FPJ-GAOGE/V4-Underwater-Robot/THIRD_PARTY_NOTICES.md

# 许可、署名与来源

**中文** · [English](THIRD_PARTY_NOTICES.en.md)

本仓库按项目所有者要求整理为**私有开源准备仓库**，保留各上游组件的原始许可和版权声明。没有给整个资料包补写统一 MIT / GPL 许可，也没有将私有整理等同于所有材料已获公共再分发许可。

| 范围 | 来源许可 / 状态 | 本仓库处理 |
| --- | --- | --- |
| `firmware/v4` 的 IWIN-FINS 项目 | 上游 [LICENSE](firmware/v4/LICENSE) 为 GNU GPL v3 文本 | 原样保留；具体子组件按各自条款 |
| V4 的 CMSIS、ST HAL、USB 库 | CMSIS Apache 2.0；HAL 原说明指向 BSD-3-Clause；USB 含 ST SLA0044 | 保留对应 LICENSE 文件与源码头部，不将其统一改写 |
| `firmware/v4-pro` 的 FineSUB | 上游 [LICENSE](firmware/v4-pro/LICENSE) 为 MPL-2.0 | 保留文件级条款、原始署名和固定依赖来源 |
| FineSUB 的 CMSIS-DSP、ETL、BSP 及其他依赖 | 各自目录许可，详见 [IMPORT](firmware/v4-pro/IMPORT.md) | 固定版本并保留许可文件；裁剪不用于目标构建的资料有记录 |
| `software/v4-topside` | 指定提交未附明确许可 | 私有收录并标注来源，未擅自为上游代码添加许可 |
| Jetson 与历史通信附件 | 飞书附件中未附明确许可 | 保留原文件、校验值及文档来源 |
| CAD、工程图、照片、BOM、文档改写 | 所提供资料没有独立的开放硬件/文档许可声明；部分模型为外购器件外形 | 分型号整理并列出来源，不推定供应商外形模型可无条件公开 |

对未明确授权部分，公开发布前需要项目权利人确认分发范围和许可；这不影响当前按要求建立私有资料库。新增整理文档不声明代表第三方授权，也不自动改变被引用材料的条款。

## 保留与排除

- 保留上游作者和团队署名、版权头、许可证、固定提交，以及原始代码行为。
- 机械原包保留原文件名与原生装配文件；中性格式逐文件校验，不声称转换成另一种许可。
- 未收录飞书评论、OAuth 响应、设备登录密码、个人分工、行程及费用信息。
- 没有将未经确认的研究论文实验结果、仿真模型或其他仓库的 Pro 配置当作本项目实测指标。

源码与设计出处见 [sources.md](docs/sources.md)。
