FPJ-GAOGE/V4-Underwater-Robot/hardware/v4/electrical-connection.original.pdf

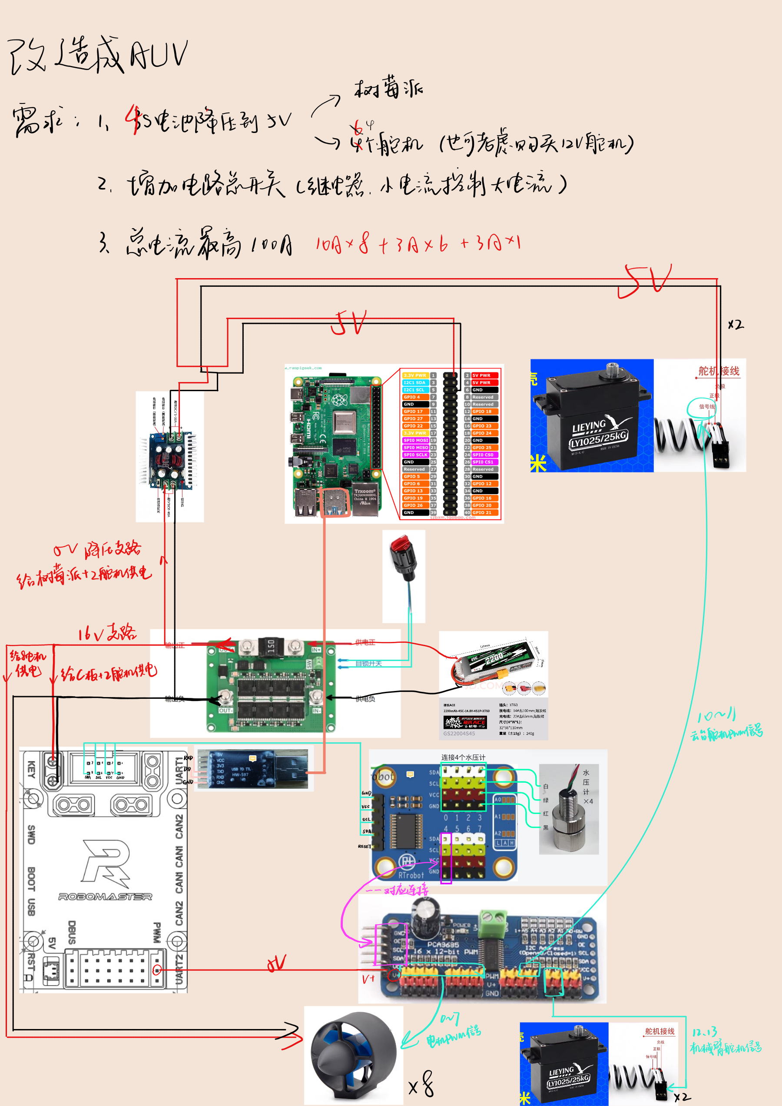
[picture p7: page 1]
