FPJ-GAOGE/V4-Underwater-Robot/docs/bom.en.md

[中文](bom.md) | [English](bom.en.md)

# V4 / V4-pro Bill of Materials (BOM)

This page and the downloadable tables use the same [structured bilingual dataset](../hardware/bom/bom-data.json). Compiled on **2026-10-22**. There are **95 records: 56 for V4 and 39 for V4-pro**. These include historical alternatives, optional mechanisms and unconfirmed quantities; the complete list is not a purchase order for one vehicle.

## Downloads

- [Excel: bilingual V4 / V4-pro BOM](../hardware/bom/V4-V4pro-BOM.xlsx)
- [CSV: V4](../hardware/bom/V4-BOM.csv) · [CSV: V4-pro](../hardware/bom/V4-pro-BOM.csv)
- [JSON: bilingual data, sources and status](../hardware/bom/bom-data.json)
- [Release downloads](https://github.com/FPJ-GAOGE/V4-Underwater-Robot/releases/tag/bilingual-bom-2026-10-22) · [SHA-256 checksums](../hardware/bom/SHA256SUMS.txt)

## Reading quantities and status

- **Unconfirmed** means no quantity can be established from the source. It is `null` in JSON, not zero. Numeric entries reproduce source values; they do not imply a completed assembly-instance count.
- “pcs/sets” are organizational counting units. Where the source lacks a supplier package unit, the quantity note says so. The 100 m Ethernet-tether entry is a recorded length, not 100 cables.
- Do not add **historical alternatives** to the current quantities. **Optional design files** do not mean that every vehicle includes the mechanism. A CAD part file alone does not establish how many instances are required.
- Resolve **conflicting sources** against the actual vehicle: V4 servos (2/4), relay ratings (30 A/120 A) and different terminal layouts; Pro servo supply (5 V/8.4 V) and terminal quantities.
- Purchase links retain only product IDs from the source and omit account/tracking parameters. Current prices, availability and product options have not been checked. One listing may include ESC/no-ESC, voltage or range options; do not order solely from the URL.
- V4 and V4-pro have distinct thruster wiring, controllers, onboard computers, control signals and CAD. Matching names or listing URLs do not establish interchangeability.

All 26 entries in the original V4 parts table are included. Additional entries from the older electrical document have explicit status, and H30 appears only once as a firmware dependency. Pro connector customization is described alongside devices without separate purchase counts, so device counts have not been copied into connector quantities. For mechanical parts without stated material, tolerance, sealing grade or pressure performance, use the drawings and confirmed vehicle records.

## V4

### Electronics and actuators

| ID / Item | Quantity / unit and note | Specification and customization | Status / source / original listing |
| --- | --- | --- | --- |
| `v4-thruster`<br>Thruster | 8 pcs | The original V4 uses power-positive, power-negative and PWM wires. Measure cable lengths on the selected frame; do not use the Pro three-phase wiring scheme. | Listed in source; verify before purchase<br>[v4-parts](#source-v4-parts) · [v4-electrical](#source-v4-electrical)<br>[Original listing](https://item.taobao.com/item.htm?id=591864716045) |
| `v4-servo`<br>Servo | 2 pcs<br>The parts list says 2; the older electrical list says 4. Do not add them. | The older electrical list and V4-ly firmware retain four channels. Confirm the installed camera/mechanism configuration. | Conflicting sources; confirm against the vehicle<br>[v4-parts](#source-v4-parts) · [v4-electrical](#source-v4-electrical) · [v4-firmware](#source-v4-firmware)<br>[Original listing](https://item.taobao.com/item.htm?id=853148098562) |
| `v4-pressure-sensor`<br>Depth/pressure sensor | 4 pcs | Parts list: stainless steel, 10 m option. An older product title mentions MS5837-30BA. Confirm the actual model/option; 10 m is not the vehicle depth rating. The older wiring uses the supplied adapter board; verify that it is included with the sensor. | Listed in source; verify before purchase<br>[v4-parts](#source-v4-parts) · [v4-electrical](#source-v4-electrical)<br>[Original listing](https://item.taobao.com/item.htm?id=605375059849) |
| `v4-battery`<br>4S battery | 1 pcs | XT60 main-power connector. The older electrical document records 10000 mAh and 25C; the parts list confirms only 4S/XT60. | Listed in source; verify before purchase<br>[v4-parts](#source-v4-parts) · [v4-electrical](#source-v4-electrical)<br>[Original listing](https://item.taobao.com/item.htm?id=609820541557) |
| `v4-relay`<br>Relay/power-switch module | 1 pcs | The parts list says 30 A and the older electrical document says 120 A. The original short link is not evidence of the model or current rating. | Conflicting sources; confirm against the vehicle<br>[v4-parts](#source-v4-parts) · [v4-electrical](#source-v4-electrical)<br>No verified product URL |
| `v4-rotary-switch`<br>Underwater rotary switch | 1 pcs | Switch in the main-power control path; verify the connections and contact rating of the actual part. | Listed in source; verify before purchase<br>[v4-parts](#source-v4-parts) · [v4-electrical](#source-v4-electrical)<br>[Original listing](https://item.taobao.com/item.htm?id=746272975983) |
| `v4-buck-converter`<br>DC-DC step-down converter | 1 pcs | Supplies the Raspberry Pi and mechanism branches; confirm voltage/current requirements for each load. | Listed in source; verify before purchase<br>[v4-parts](#source-v4-parts) · [v4-electrical](#source-v4-electrical)<br>[Original listing](https://item.taobao.com/item.htm?id=856012812115) |
| `v4-power-distribution`<br>Power distribution board | 1 pcs<br>Quantity 1 comes from the older electrical list; it is absent from the current parts list. | The older wiring uses it for Raspberry Pi/servo branches and also describes a custom split harness. Do not duplicate alternative distribution solutions. | Historical alternative; do not add to current quantities<br>[v4-electrical](#source-v4-electrical)<br>[Original listing](https://item.taobao.com/item.htm?id=814381038913) |
| `v4-raspberry-pi`<br>Raspberry Pi 4B | 1 pcs | Onboard computer; RAM and storage specifications are not stated in the parts list. | Listed in source; verify before purchase<br>[v4-parts](#source-v4-parts) · [v4-electrical](#source-v4-electrical)<br>[Original listing](https://detail.tmall.com/item.htm?id=705995475782) |
| `v4-controller`<br>RoboMaster C board | 1 pcs | V4 controller named in the system documentation. The firmware project targets STM32F407IGHx; verify the actual board. | Listed in source; verify before purchase<br>[v4-parts](#source-v4-parts) · [v4-electrical](#source-v4-electrical) · [v4-firmware](#source-v4-firmware)<br>[Original listing](https://item.taobao.com/item.htm?id=611226266955) |
| `v4-h30-imu`<br>H30 IMU (firmware dependency) | Unconfirmed pcs<br>No confirmed quantity is given in the source; this does not mean zero. | V4-ly attitude feedback uses H30 on USART1 at 921600 8N1; startup also checks BMI088. Record the actual H30 purchase model and mounting. | Quantity or specification missing<br>[v4-firmware](#source-v4-firmware)<br>No verified product URL |
| `v4-pca9685`<br>PCA9685 PWM expansion board | 1 pcs | Thrusters use channels 0–7; firmware reserves channels 8–11 for servos. Distinguish logic VCC from the V+ load supply. | Listed in source; verify before purchase<br>[v4-parts](#source-v4-parts) · [v4-electrical](#source-v4-electrical) · [v4-firmware](#source-v4-firmware)<br>[Original listing](https://detail.tmall.com/item.htm?id=624960039615) |
| `v4-i2c-expander`<br>I2C multiplexer board | 1 pcs | Firmware uses TCA9548A: channels 0–3 for pressure sensors and channel 4 for PCA9685. | Listed in source; verify before purchase<br>[v4-parts](#source-v4-parts) · [v4-electrical](#source-v4-electrical) · [v4-firmware](#source-v4-firmware)<br>[Original listing](https://item.taobao.com/item.htm?id=612860784973) |
| `v4-camera`<br>Camera | 1 pcs | The full design includes a stereo-camera arrangement; a monocular mount update dated 2025-07-10 is separate. Match the camera to the selected mount and interface. | Listed in source; verify before purchase<br>[v4-parts](#source-v4-parts) · [v4-design](#source-v4-design)<br>[Original listing](https://item.taobao.com/item.htm?id=793615736142) |
| `v4-wireless-debugger`<br>Wireless debugger/programmer | 1 pcs | Verify compatibility with the actual SWD connection and programming tool. | Listed in source; verify before purchase<br>[v4-parts](#source-v4-parts)<br>[Original listing](https://item.taobao.com/item.htm?id=745548099223) |

### Connectors and cabling

| ID / Item | Quantity / unit and note | Specification and customization | Status / source / original listing |
| --- | --- | --- | --- |
| `v4-servo-thruster-connectors`<br>Watertight servo/thruster connectors | 12 sets<br>The source says 12 without a package unit; listed as sets from the mating-pair description, subject to confirmation. Note the older 8-thruster/4-servo layout versus the current 2-servo list. | Three-pin receptacle plus male cable; confirm equipment positions and cable lengths before custom assembly. | Conflicting sources; confirm against the vehicle<br>[v4-parts](#source-v4-parts)<br>[Original listing](https://item.taobao.com/item.htm?id=811948973422) |
| `v4-connector-caps`<br>Three-pin male blanking plugs | 2 pcs | For unused servo/thruster connectors; match the mating receptacle. | Listed in source; verify before purchase<br>[v4-parts](#source-v4-parts)<br>[Original listing](https://item.taobao.com/item.htm?id=811948973422) |
| `v4-pressure-sleeves`<br>External pressure-sensor sleeves | 4 pcs | For sensor-cable extension and potting; follow the purchased materials/process specifications. | Listed in source; verify before purchase<br>[v4-parts](#source-v4-parts) · [v4-design](#source-v4-design)<br>[Original listing](https://item.taobao.com/item.htm?id=781752613399) |
| `v4-pressure-connectors`<br>Watertight pressure-sensor connectors | 4 sets<br>The source quantity is 4; mating pairs are listed as sets. Confirm the supplier package unit. | Custom 00W four-pin plug and receptacle; 65 cm vendor-supplied four-core cable. | Listed in source; verify before purchase<br>[v4-parts](#source-v4-parts)<br>[Original listing](https://item.taobao.com/item.htm?id=619481441943) |
| `v4-ethernet-tether`<br>Neutral-buoyancy Ethernet tether | 100 m<br>100 is a recorded length, not 100 cables; confirm whether it is the per-vehicle requirement. | The quantity cell states “neutral-buoyancy Ethernet cable, 100 m”. Confirm termination, outer diameter, core count and length definition with the connector supplier. | Listed in source; verify before purchase<br>[v4-parts](#source-v4-parts)<br>No verified product URL |
| `v4-tether-connector`<br>Tether connector | 1 pcs | 1W eight-pin plug; the mating receptacle and termination arrangement are not fully specified. | Listed in source; verify before purchase<br>[v4-parts](#source-v4-parts)<br>No verified product URL |
| `v4-camera-connector`<br>Camera connector | Unconfirmed pcs<br>No confirmed quantity is given in the source; this does not mean zero. | 1W four-pin plug; verify against the actual camera and cable-penetration design. | Quantity or specification missing<br>[v4-parts](#source-v4-parts)<br>No verified product URL |
| `v4-terminal-20p`<br>H3800 20-position terminal block | 2 pcs | Match the current mounting holes and wiring schedule. | Listed in source; verify before purchase<br>[v4-parts](#source-v4-parts)<br>[Original listing](https://item.taobao.com/item.htm?id=661948958655) |
| `v4-terminal-16p`<br>H3803 16-position terminal block | 2 pcs | Verify against the power/branch harnesses and the actual terminal specification. | Listed in source; verify before purchase<br>[v4-parts](#source-v4-parts)<br>[Original listing](https://item.taobao.com/item.htm?id=551775262138) |
| `v4-terminal-6p`<br>H3800 6-position terminal block | 2 pcs | An older document describes a different six-/seven-pin layout. Do not add the historical terminal rows to this quantity. | Listed in source; verify before purchase<br>[v4-parts](#source-v4-parts) · [v4-electrical](#source-v4-electrical)<br>[Original listing](https://item.taobao.com/item.htm?id=661948958655) |
| `v4-bridge-3-5mm`<br>3.5 mm ten-position jumper bridge | 2 pcs | FBS10-3.5, red, brass; match the terminal-block series. | Listed in source; verify before purchase<br>[v4-parts](#source-v4-parts)<br>[Original listing](https://detail.tmall.com/item.htm?id=622709470719) |
| `v4-bridge-6-2mm`<br>6.2 mm ten-position jumper bridge | 2 pcs | Ten-position EB bridge; match the terminal-block series. | Listed in source; verify before purchase<br>[v4-parts](#source-v4-parts)<br>[Original listing](https://item.taobao.com/item.htm?id=551775262138) |
| `v4-usb-c-power-cable`<br>Raspberry Pi USB-C power cable | 1 pcs | The source specifies two left/right angled connectors; verify current capability and available space. | Listed in source; verify before purchase<br>[v4-parts](#source-v4-parts)<br>[Original listing](https://detail.tmall.com/item.htm?id=739417974339) |

### Mechanical and machined parts

| ID / Item | Quantity / unit and note | Specification and customization | Status / source / original listing |
| --- | --- | --- | --- |
| `v4-side-support`<br>Side support | Unconfirmed pcs<br>The CAD contains this part, but its assembly instance count is unconfirmed. Do not copy the Pro quantity. | 主体/侧支撑.STEP; a DWG is also provided. The V4 aluminum-machining instructions specify matte black anodizing; use the drawings for material and tolerances. | Quantity or specification missing<br>[v4-design](#source-v4-design) · [v4-cad](#source-v4-cad)<br>No verified product URL |
| `v4-bottom-support`<br>Bottom support 2 | Unconfirmed pcs<br>The CAD contains this part, but its assembly instance count is unconfirmed. Do not copy the Pro quantity. | 主体/底支撑2.STEP; a DWG is also provided. The V4 aluminum-machining instructions specify matte black anodizing; use the drawings for material and tolerances. | Quantity or specification missing<br>[v4-design](#source-v4-design) · [v4-cad](#source-v4-cad)<br>No verified product URL |
| `v4-upper-thruster-support`<br>Upper thruster support | Unconfirmed pcs<br>The CAD contains this part, but its assembly instance count is unconfirmed. Do not copy the Pro quantity. | 主体/上推进器支撑.STEP; a DWG is also provided. The V4 aluminum-machining instructions specify matte black anodizing; use the drawings for material and tolerances. | Quantity or specification missing<br>[v4-design](#source-v4-design) · [v4-cad](#source-v4-cad)<br>No verified product URL |
| `v4-corner-piece`<br>Corner bracket | Unconfirmed pcs<br>The CAD contains this part, but its assembly instance count is unconfirmed. Do not copy the Pro quantity. | 主体/角件.STEP. The V4 aluminum-machining instructions specify matte black anodizing; use the drawings for material and tolerances. | Quantity or specification missing<br>[v4-design](#source-v4-design) · [v4-cad](#source-v4-cad)<br>No verified product URL |
| `v4-rear-endcap`<br>Rear end cap 165 | Unconfirmed pcs<br>The CAD contains this part, but its assembly instance count is unconfirmed. Do not copy the Pro quantity. | 密封舱/后舱盖165.STEP; a DWG is also provided. The V4 aluminum-machining instructions specify matte black anodizing; use the drawings for material and tolerances. | Quantity or specification missing<br>[v4-design](#source-v4-design) · [v4-cad](#source-v4-cad)<br>No verified product URL |
| `v4-gimbal-base`<br>Gimbal base | Unconfirmed pcs<br>The CAD contains this part, but its assembly instance count is unconfirmed. Do not copy the Pro quantity. | 相机云台/云台底架.STEP; a DWG is also provided. The V4 aluminum-machining instructions specify matte black anodizing; use the drawings for material and tolerances. | Quantity or specification missing<br>[v4-design](#source-v4-design) · [v4-cad](#source-v4-cad)<br>No verified product URL |
| `v4-rear-gimbal-base`<br>Rear gimbal base | Unconfirmed pcs<br>The CAD contains this part, but its assembly instance count is unconfirmed. Do not copy the Pro quantity. | 相机云台/后云台底架.STEP; a DWG is also provided. The V4 aluminum-machining instructions specify matte black anodizing; use the drawings for material and tolerances. | Quantity or specification missing<br>[v4-design](#source-v4-design) · [v4-cad](#source-v4-cad)<br>No verified product URL |
| `v4-sensor-sleeve-mount`<br>Machined external-sleeve mount | Unconfirmed pcs<br>The CAD contains this part, but its assembly instance count is unconfirmed. Do not copy the Pro quantity. | 水深传感器/外置套管固定加工版.STEP. The V4 aluminum-machining instructions specify matte black anodizing; use the drawings for material and tolerances. | Quantity or specification missing<br>[v4-design](#source-v4-design) · [v4-cad](#source-v4-cad)<br>No verified product URL |
| `v4-sealed-housing`<br>Sealed enclosure and associated seals/mounts | Unconfirmed assembly (breakdown required)<br>No confirmed quantity is given in the source; this does not mean zero. | The manufacturing steps mention the sealed enclosure and rear cap, but do not provide a complete enclosure/seal purchase breakdown or a vehicle depth rating. | Quantity or specification missing<br>[v4-design](#source-v4-design)<br>No verified product URL |

### Printed parts and internal supports

| ID / Item | Quantity / unit and note | Specification and customization | Status / source / original listing |
| --- | --- | --- | --- |
| `v4-upper-electronics-tray`<br>Upper electronics tray | Unconfirmed pcs<br>No confirmed quantity is given in the source; this does not mean zero. | CAD: 密封舱/舱内/上层架板.STEP. Confirm the process, material and quantity from the selected assembly; file presence alone does not establish them. | Quantity or specification missing<br>[v4-cad](#source-v4-cad)<br>No verified product URL |
| `v4-lower-electronics-tray`<br>Lower electronics tray | Unconfirmed pcs<br>No confirmed quantity is given in the source; this does not mean zero. | CAD: 密封舱/舱内/下层架板.STEP. Confirm the process, material and quantity from the selected assembly; file presence alone does not establish them. | Quantity or specification missing<br>[v4-cad](#source-v4-cad)<br>No verified product URL |
| `v4-battery-tray`<br>Battery holder | Unconfirmed pcs<br>No confirmed quantity is given in the source; this does not mean zero. | CAD: 密封舱/舱内/电池架.STEP. Confirm the process, material and quantity from the selected assembly; file presence alone does not establish them. | Quantity or specification missing<br>[v4-cad](#source-v4-cad)<br>No verified product URL |
| `v4-camera-link`<br>Camera mounting link | Unconfirmed pcs<br>No confirmed quantity is given in the source; this does not mean zero. | CAD: 相机云台/相机连接件.STEP. Confirm the process, material and quantity from the selected assembly; file presence alone does not establish them. | Quantity or specification missing<br>[v4-cad](#source-v4-cad)<br>No verified product URL |
| `v4-servo-link`<br>Servo mounting link | Unconfirmed pcs<br>No confirmed quantity is given in the source; this does not mean zero. | CAD: 相机云台/舵机连接件.STEP. Confirm the process, material and quantity from the selected assembly; file presence alone does not establish them. | Quantity or specification missing<br>[v4-cad](#source-v4-cad)<br>No verified product URL |
| `v4-buoyancy-shell`<br>Buoyancy shell 2 | Unconfirmed pcs<br>No confirmed quantity is given in the source; this does not mean zero. | CAD: 浮力外壳/浮力外壳2.STEP. Confirm the process, material and quantity from the selected assembly; file presence alone does not establish them. | Quantity or specification missing<br>[v4-cad](#source-v4-cad)<br>No verified product URL |

### Fasteners and assembly materials

| ID / Item | Quantity / unit and note | Specification and customization | Status / source / original listing |
| --- | --- | --- | --- |
| `v4-switch-extension-wire`<br>24 AWG switch-extension wire | Unconfirmed m<br>No confirmed quantity is given in the source; this does not mean zero. | The older electrical text specifies 24 AWG only when the rotary-switch leads need extending; total length is not stated. | Quantity or specification missing<br>[v4-electrical](#source-v4-electrical)<br>No verified product URL |
| `v4-power-y-harness`<br>XT60 and power-split harness | Unconfirmed sets<br>No confirmed quantity is given in the source; this does not mean zero. | The older wiring describes a Y split and XT60 connection. Use a completed, verified harness; the historical rewiring steps are not a product specification. | Quantity or specification missing<br>[v4-electrical](#source-v4-electrical)<br>No verified product URL |
| `v4-heat-set-inserts`<br>M2.5/M3 heat-set inserts | Unconfirmed pcs<br>No confirmed quantity is given in the source; this does not mean zero. | Use M2.5 at Raspberry Pi/PWM-board positions and M3 at other specified positions; not every hole receives an insert. | Quantity or specification missing<br>[v4-design](#source-v4-design)<br>No verified product URL |
| `v4-nylon-standoffs`<br>M2.5/M3 nylon standoffs | Unconfirmed pcs<br>No confirmed quantity is given in the source; this does not mean zero. | M2.5 for Raspberry Pi/PWM-board positions and M3 elsewhere as specified; the C board and terminals do not use the same standoffs. | Quantity or specification missing<br>[v4-design](#source-v4-design)<br>No verified product URL |
| `v4-fasteners`<br>Frame and electronics-mount fasteners | Unconfirmed pcs<br>No confirmed quantity is given in the source; this does not mean zero. | Derive from the 2025-05-23 assembly and threaded-hole drawings; the source has no consolidated size/quantity list. | Quantity or specification missing<br>[v4-design](#source-v4-design) · [v4-cad](#source-v4-cad)<br>No verified product URL |
| `v4-potting-material`<br>Epoxy potting and insulating materials | Unconfirmed amount TBD<br>No confirmed quantity is given in the source; this does not mean zero. | The source requires epoxy potting after soldering and insulation of unused distribution points; mixture and quantity are not specified. | Quantity or specification missing<br>[v4-design](#source-v4-design) · [v4-electrical](#source-v4-electrical)<br>No verified product URL |

### Historical wiring alternatives

| ID / Item | Quantity / unit and note | Specification and customization | Status / source / original listing |
| --- | --- | --- | --- |
| `v4-usb-ttl`<br>USB-to-TTL adapter | 1 pcs<br>Quantity 1 comes from the older electrical list; it is absent from the current parts list. | Optional UART connection in the older electrical document; distinguish it from direct GPIO UART wiring. | Historical alternative; do not add to current quantities<br>[v4-electrical](#source-v4-electrical)<br>No verified product URL |
| `v4-historical-6pin-large`<br>Large six-pin terminal blocks, older layout | 4 pcs | The older wiring uses these for thrusters with positive/negative/signal wiring. | Historical alternative; do not add to current quantities<br>[v4-electrical](#source-v4-electrical)<br>No verified product URL |
| `v4-historical-6pin-small`<br>Small six-pin terminal blocks, older layout | 2 pcs | Used for servos in the older wiring; do not add to the current H3800-series layout. | Historical alternative; do not add to current quantities<br>[v4-electrical](#source-v4-electrical)<br>No verified product URL |
| `v4-historical-7pin-small`<br>Small seven-pin terminal block, older layout | Unconfirmed pcs<br>No confirmed quantity is given in the source; this does not mean zero. | Three UART wires plus four SWD wires; the source gives no explicit quantity. | Historical alternative; do not add to current quantities<br>[v4-electrical](#source-v4-electrical)<br>No verified product URL |
| `v4-historical-stlink`<br>ST-Link debugger (older connection) | Unconfirmed pcs<br>No confirmed quantity is given in the source; this does not mean zero. | The older wiring steps mention ST-Link. It is an alternative to the wireless debugger, not an automatic additional purchase. | Historical alternative; do not add to current quantities<br>[v4-electrical](#source-v4-electrical)<br>No verified product URL |

### Optional mechanisms and later updates

| ID / Item | Quantity / unit and note | Specification and customization | Status / source / original listing |
| --- | --- | --- | --- |
| `v4-monocular-mount-update`<br>2025-07-10 monocular-camera mount update | Unconfirmed assembly (breakdown required)<br>No confirmed quantity is given in the source; this does not mean zero. | Two separate SLDPRT definitions, 相机支架1 and 相机支架2; this does not establish one of each per vehicle. Confirm the chosen mechanism. | Optional design files; not part of the default assembly<br>[v4-design](#source-v4-design) · [v4-cad](#source-v4-cad)<br>No verified product URL |
| `v4-gripper-design`<br>Optional gripper design package | Unconfirmed assembly (breakdown required)<br>No confirmed quantity is given in the source; this does not mean zero. | Contains driving/driven gears, a circular flange, gripper finger, link rod, base and top-cover models. Instance counts and vehicle integration are unconfirmed. | Optional design files; not part of the default assembly<br>[v4-design](#source-v4-design) · [v4-cad](#source-v4-cad)<br>No verified product URL |

## V4-pro

### Electronics and actuators

| ID / Item | Quantity / unit and note | Specification and customization | Status / source / original listing |
| --- | --- | --- | --- |
| `v4-pro-thruster`<br>Brushless thruster without ESC | 8 pcs | Four CW and four CCW propellers, paired one of each; the four cable groups are 65/50/38/32 cm. Three motor-phase wires, not the V4 power-positive/negative/PWM arrangement. | Listed in source; verify before purchase<br>[pro-making](#source-pro-making)<br>[Original listing](https://item.taobao.com/item.htm?id=591864716045) |
| `v4-pro-esc`<br>Four-in-one ESC | 2 pcs | Eight motor channels total. FineSUB uses DSHOT with bidirectional 3D mode and telemetry; confirm the ESC model, voltage and firmware settings. | Listed in source; verify before purchase<br>[pro-making](#source-pro-making) · [pro-firmware](#source-pro-firmware)<br>No verified product URL |
| `v4-pro-pressure-sensor`<br>Depth/pressure sensor | 4 pcs | 316L stainless steel, 10 m option; custom 70 cm waterproof leads, pin 1 red/2 black/3 green SCL/4 white SDA. The 10 m option is not a vehicle depth rating. | Listed in source; verify before purchase<br>[pro-making](#source-pro-making)<br>[Original listing](https://item.taobao.com/item.htm?id=605375059849) |
| `v4-pro-fill-light`<br>PWM fill light | 2 pcs | ArduSub pulse-width-controlled light, 100° beam angle; 60 cm waterproof lead, pin 1 red/2 black/3 yellow PWM. Verify its power supply specification. | Listed in source; verify before purchase<br>[pro-making](#source-pro-making) · [pro-wiring](#source-pro-wiring)<br>[Original listing](https://item.taobao.com/item.htm?id=934701227487) |
| `v4-pro-servo`<br>Servo | 2 pcs | 75 cm waterproof lead, pin 1 red/2 black/3 yellow PWM. The simplified drawing says 5 V while the manufacturing text specifies an 8.4 V adjustable board supply; resolve this before assembly. | Conflicting sources; confirm against the vehicle<br>[pro-making](#source-pro-making) · [pro-wiring](#source-pro-wiring)<br>[Original listing](https://item.taobao.com/item.htm?id=853148098562) |
| `v4-pro-controller`<br>RoboMaster A board | 1 pcs | STM32F427. Thrusters use DSHOT; lights/servos use separate PWM outputs. Verify board and load supplies. | Listed in source; verify before purchase<br>[pro-making](#source-pro-making) · [pro-firmware](#source-pro-firmware)<br>[Original listing](https://item.taobao.com/item.htm?id=605165393036) |
| `v4-pro-jetson`<br>Jetson Orin module and carrier board | 1 set<br>The source says “NANO ×1”. Counted as one computer set; separate module/carrier purchase quantities require confirmation. | The manufacturing list says “NANO”; the linked setup covers Orin NX/Nano and a Damiao carrier. This is not a generic substitution with the older Jetson Nano. | Listed in source; verify before purchase<br>[pro-making](#source-pro-making) · [orin-setup](#source-orin-setup)<br>No verified product URL |
| `v4-pro-battery`<br>Custom battery | Unconfirmed pcs<br>No confirmed quantity is given in the source; this does not mean zero. | The original wiring drawing labels the main supply 24 V. Capacity, cell configuration, protection and charging interface are unspecified; do not infer them from a product title. | Quantity or specification missing<br>[pro-making](#source-pro-making) · [pro-wiring](#source-pro-wiring)<br>No verified product URL |
| `v4-pro-power-distribution`<br>Power distribution board | Unconfirmed pcs<br>No confirmed quantity is given in the source; this does not mean zero. | Must match the battery, ESC, controller and Jetson branches; model, current rating and quantity are not listed. | Quantity or specification missing<br>[pro-making](#source-pro-making) · [pro-wiring](#source-pro-wiring)<br>No verified product URL |
| `v4-pro-i2c-expander`<br>I2C multiplexer board | Unconfirmed pcs<br>No confirmed quantity is given in the source; this does not mean zero. | The guide requires 3.3 V; current firmware uses I2C2 → TCA9548A at 0x70 → four pressure sensors. | Quantity or specification missing<br>[pro-making](#source-pro-making) · [pro-firmware](#source-pro-firmware)<br>[Original listing](https://item.taobao.com/item.htm?id=677595693967) |
| `v4-pro-imu`<br>IMU | Unconfirmed pcs<br>No confirmed quantity is given in the source; this does not mean zero. | The guide requests 400 Hz firmware and 921600 baud. Firmware uses H30/UART7; confirm the actual hardware model. | Quantity or specification missing<br>[pro-making](#source-pro-making) · [pro-firmware](#source-pro-firmware)<br>[Original listing](https://item.taobao.com/item.htm?id=649300089333) |
| `v4-pro-wireless-programmer`<br>Wireless programmer | 2 pcs | Match each intended use and SWD interface; this does not mean attaching two programmers to one board. | Listed in source; verify before purchase<br>[pro-making](#source-pro-making)<br>[Original listing](https://item.taobao.com/item.htm?id=745548099223) |
| `v4-pro-powerline-modem`<br>Power-line communication module | 2 pcs | Paired modules for PC-to-vehicle communication; confirm model and power requirements. | Listed in source; verify before purchase<br>[pro-making](#source-pro-making)<br>[Original listing](https://item.taobao.com/item.htm?id=674728822237) |
| `v4-pro-camera`<br>USB camera | Unconfirmed pcs<br>No confirmed quantity is given in the source; this does not mean zero. | The manufacturing/setup texts mention a USB camera; model, quantity and actual video modes are not fully specified. | Quantity or specification missing<br>[pro-making](#source-pro-making) · [orin-setup](#source-orin-setup)<br>No verified product URL |
| `v4-pro-rotary-switch`<br>Rotary power switch | Unconfirmed pcs<br>No confirmed quantity is given in the source; this does not mean zero. | Mentioned in the internal wiring steps; contact rating and quantity are not listed. Do not substitute the V4 switch entry automatically. | Quantity or specification missing<br>[pro-making](#source-pro-making)<br>No verified product URL |

### Connectors and cabling

| ID / Item | Quantity / unit and note | Specification and customization | Status / source / original listing |
| --- | --- | --- | --- |
| `v4-pro-terminal-12p`<br>H3800 12-position terminal block | 2 pcs | The text lists 12P ×2; the drawing also shows 20P and servo 12P blocks. Reconcile against the final harness. | Conflicting sources; confirm against the vehicle<br>[pro-making](#source-pro-making) · [pro-wiring](#source-pro-wiring)<br>[Original listing](https://item.taobao.com/item.htm?id=661948958655) |
| `v4-pro-terminal-drawing-extras`<br>Additional 20P/12P blocks in drawing (reconciliation pending) | Unconfirmed pcs<br>No confirmed quantity is given in the source; this does not mean zero. | Records the drawing/text discrepancy; it is not a confirmed extra quantity on top of the listed 12P ×2. | Conflicting sources; confirm against the vehicle<br>[pro-wiring](#source-pro-wiring)<br>No verified product URL |
| `v4-pro-thruster-connectors`<br>Thruster 1W three-pin watertight connectors | Unconfirmed sets (confirm)<br>Connectors are specified with the eight thrusters, but no separate purchase count/unit is stated. | Motor-phase plugs; mating receptacles are specified at 15 A with 20 cm internal leads. Expand the mating pairs and supplier package units. | Quantity or specification missing<br>[pro-making](#source-pro-making)<br>No verified product URL |
| `v4-pro-pressure-connectors`<br>Pressure-sensor 00W four-pin watertight connectors | Unconfirmed sets (confirm)<br>Specified with the four sensors; no separate connector purchase quantity is listed. | Plug pin 1 red/2 black/3 green SCL/4 white SDA; 20 cm internal receptacle leads and 70 cm sensor-side leads. | Quantity or specification missing<br>[pro-making](#source-pro-making)<br>No verified product URL |
| `v4-pro-light-connectors`<br>Fill-light 1W three-pin watertight connectors | Unconfirmed sets (confirm)<br>Specified with the two lights; no separate connector purchase quantity is listed. | Pin 1 red/2 black/3 yellow PWM; receptacle specified at 3 A with 20 cm internal leads and 60 cm device-side leads. | Quantity or specification missing<br>[pro-making](#source-pro-making)<br>No verified product URL |
| `v4-pro-servo-connectors`<br>Servo 1W three-pin watertight connectors | Unconfirmed sets (confirm)<br>Specified with the two servos; no separate connector purchase quantity is listed. | Pin 1 red/2 black/3 yellow PWM; receptacle specified at 2 A with 20 cm internal leads and 75 cm device-side leads. | Quantity or specification missing<br>[pro-making](#source-pro-making)<br>No verified product URL |
| `v4-pro-uart-harness`<br>Jetson-to-RM-A UART harness | Unconfirmed cables<br>No confirmed quantity is given in the source; this does not mean zero. | GH1.25 four-pin lead with the 5 V wire removed: common GND and crossed TX/RX. The documented /dev/ttyTHS1 connects to UART3; confirm the carrier revision. | Quantity or specification missing<br>[orin-setup](#source-orin-setup)<br>No verified product URL |
| `v4-pro-camera-penetrator`<br>Camera cable penetrator | Unconfirmed pcs<br>No confirmed quantity is given in the source; this does not mean zero. | The internal assembly instructions call for a camera cable penetrator; match the cable diameter and sealing design. | Quantity or specification missing<br>[pro-making](#source-pro-making)<br>No verified product URL |
| `v4-pro-ethernet-cable`<br>Ethernet/power-line connection cables | Unconfirmed cables<br>No confirmed quantity is given in the source; this does not mean zero. | The Orin/PC setup uses a direct Ethernet cable for initial checks and paired power-line modules in the vehicle. No consolidated length/termination specification is given. | Quantity or specification missing<br>[pro-making](#source-pro-making) · [orin-setup](#source-orin-setup)<br>No verified product URL |

### Mechanical and machined parts

| ID / Item | Quantity / unit and note | Specification and customization | Status / source / original listing |
| --- | --- | --- | --- |
| `v4-pro-side-support`<br>Side support | 2 pcs | 主体/侧支撑.STEP and DWG. Use the corresponding drawings for material, tolerance and finish. | Listed in source; verify before purchase<br>[pro-making](#source-pro-making) · [pro-cad](#source-pro-cad)<br>No verified product URL |
| `v4-pro-bottom-support`<br>Bottom support 2 | 2 pcs | Called bottom support in the list; the filename is 底支撑2. Use the corresponding drawings for material, tolerance and finish. | Listed in source; verify before purchase<br>[pro-making](#source-pro-making) · [pro-cad](#source-pro-cad)<br>No verified product URL |
| `v4-pro-upper-thruster-support`<br>Upper thruster support | 2 pcs | 主体/上推进器支撑.STEP and DWG. Use the corresponding drawings for material, tolerance and finish. | Listed in source; verify before purchase<br>[pro-making](#source-pro-making) · [pro-cad](#source-pro-cad)<br>No verified product URL |
| `v4-pro-front-gimbal-base`<br>Front gimbal base | 1 pcs | The matching CAD part is 相机云台/前云台底架. Use the corresponding drawings for material, tolerance and finish. | Listed in source; verify before purchase<br>[pro-making](#source-pro-making) · [pro-cad](#source-pro-cad)<br>No verified product URL |
| `v4-pro-rear-endcap`<br>Rear end cap | 1 pcs | The matching CAD part is 密封舱/后舱盖165; use the drawings for connector holes and threads. Use the corresponding drawings for material, tolerance and finish. | Listed in source; verify before purchase<br>[pro-making](#source-pro-making) · [pro-cad](#source-pro-cad)<br>No verified product URL |
| `v4-pro-acrylic-tube`<br>Acrylic tube | Unconfirmed pcs<br>No confirmed quantity is given in the source; this does not mean zero. | The purchasing text lists an acrylic tube and associated mounts, without quantity, dimensions or pressure rating. | Quantity or specification missing<br>[pro-making](#source-pro-making)<br>No verified product URL |
| `v4-pro-housing-fixings`<br>Enclosure seals/flanges/mounts | Unconfirmed assembly (breakdown required)<br>No confirmed quantity is given in the source; this does not mean zero. | Expand from the full assembly and selected enclosure; the source does not provide a complete per-part count. | Quantity or specification missing<br>[pro-making](#source-pro-making) · [pro-cad](#source-pro-cad)<br>No verified product URL |

### Printed parts and internal supports

| ID / Item | Quantity / unit and note | Specification and customization | Status / source / original listing |
| --- | --- | --- | --- |
| `v4-pro-upper-tray`<br>Upper electronics tray | 1 pcs | 3D print from the V4pro model; no unified material, layer-height or infill settings are supplied. | Listed in source; verify before purchase<br>[pro-making](#source-pro-making) · [pro-cad](#source-pro-cad)<br>No verified product URL |
| `v4-pro-lower-tray`<br>Lower electronics tray | 1 pcs | 3D print from the V4pro model; no unified material, layer-height or infill settings are supplied. | Listed in source; verify before purchase<br>[pro-making](#source-pro-making) · [pro-cad](#source-pro-cad)<br>No verified product URL |
| `v4-pro-pressure-mount`<br>Pressure-sensor mount | 4 pcs | 3D print from the V4pro model; no unified material, layer-height or infill settings are supplied. | Listed in source; verify before purchase<br>[pro-making](#source-pro-making) · [pro-cad](#source-pro-cad)<br>No verified product URL |
| `v4-pro-light-mount`<br>Fill-light mount | 2 pcs | 3D print from the V4pro model; no unified material, layer-height or infill settings are supplied. | Listed in source; verify before purchase<br>[pro-making](#source-pro-making) · [pro-cad](#source-pro-cad)<br>No verified product URL |

### Fasteners and assembly materials

| ID / Item | Quantity / unit and note | Specification and customization | Status / source / original listing |
| --- | --- | --- | --- |
| `v4-pro-heat-set-inserts`<br>M3/M4 heat-set inserts | Unconfirmed pcs<br>No confirmed quantity is given in the source; this does not mean zero. | Select M3/M4 positions from the upper/lower tray models; do not substitute the V4 M2.5/M3 instructions. | Quantity or specification missing<br>[pro-making](#source-pro-making)<br>No verified product URL |
| `v4-pro-fasteners`<br>Frame and electronics-mount screws | Unconfirmed pcs<br>No confirmed quantity is given in the source; this does not mean zero. | Flat-head screws are specified for side supports; derive threads, lengths and quantities from the assembly/drawings. | Quantity or specification missing<br>[pro-making](#source-pro-making) · [pro-cad](#source-pro-cad)<br>No verified product URL |
| `v4-pro-esc-capacitors`<br>ESC capacitors | Unconfirmed pcs<br>No confirmed quantity is given in the source; this does not mean zero. | The internal soldering steps explicitly mention ESC wiring and capacitors, without capacitor ratings or quantities. | Quantity or specification missing<br>[pro-making](#source-pro-making)<br>No verified product URL |
| `v4-pro-power-harness`<br>Power/distribution/switch harnesses | Unconfirmed sets (breakdown required)<br>No confirmed quantity is given in the source; this does not mean zero. | For ESCs, distribution board, custom battery, rotary switch and power-line modules; determine wire gauge, protection and lengths from actual loads. | Quantity or specification missing<br>[pro-making](#source-pro-making)<br>No verified product URL |

## Sources

| Source ID | Document |
| --- | --- |
| `v4-parts` | [V4 parts list](https://iwin-fins.feishu.cn/wiki/BQjFwY7GeiFW2KkmTXWcBC7fn8d) |
| `v4-electrical` | [AUV electrical connections and component list](https://iwin-fins.feishu.cn/wiki/R7XGwUqQZiNfqGkNGA8cCkj1nsh) |
| `v4-design` | [Competition details and V4 design, including the mechanical version table](https://iwin-fins.feishu.cn/wiki/Ty7WwhJmCihi7qk3Gx8cAL93n8f) |
| `v4-cad` | [V4 neutral CAD from 2025-05-23 and later optional mechanism files](https://github.com/FPJ-GAOGE/V4-Underwater-Robot/tree/main/hardware/v4) |
| `v4-firmware` | [IWIN-FINS V4-ly, fixed commit 42e5f16](https://gitee.com/superkinkin/IWIN-FINS/tree/42e5f16f5b3ad3e23fceb5eb60868340b365dfd5/) |
| `pro-making` | [V4-PRO manufacturing guide (RM-A controller)](https://iwin-fins.feishu.cn/wiki/RfVuwKMnqisR3rkWaFmcW6bOnVh) |
| `pro-wiring` | [V4 simplified wiring drawing (the contents describe V4-pro)](https://iwin-fins.feishu.cn/wiki/AW4WwJtehiJW3mk2VVbcxBXOnje) |
| `orin-setup` | [Orin NX setup (also described as applicable to Orin Nano)](https://iwin-fins.feishu.cn/docx/S8I9dBMNmo2dIPxhWzkcyeQsnoP) |
| `pro-firmware` | [FineSUB v4pro1, fixed commit 5a78326](https://gitee.com/gan-ju/FineSUB/tree/5a7832648206e522e9b8e0dff108638789f6afdd/) |
| `pro-cad` | [CAD files extracted from V4pro.zip](https://github.com/FPJ-GAOGE/V4-Underwater-Robot/tree/main/hardware/v4-pro) |

Feishu links may require project access. CAD and fixed software snapshots are preserved in this private repository and its Release. The reference open-source project informed presentation only; it is not a source of specifications or quantities in this BOM.

For assembly details, see [V4 hardware](hardware-v4.en.md), [V4-pro hardware](hardware-v4-pro.en.md) and [variant differences](variants.en.md). Update the same item ID in the bilingual JSON first, then synchronize Excel, CSV and both language pages while retaining the evidence for conflicts.
