FPJ-GAOGE/V4-Underwater-Robot/hardware/bom/V4-BOM.csv

条目 ID / Item ID | 型号 / Variant | 类别 | Category | 元件 / 零件 | Component / Part | 数量 / Quantity | 单位 | Unit | 数量依据 / 备注 | Quantity basis / Notes | 规格及型号差异 | Specifications and variant details | 状态 | Status | 原商品记录 / Original supplier link | 来源 ID / Source IDs | 来源链接 / Source URLs
v4-thruster | V4 | 电子与执行器 | Electronics and actuators | 推进器 | Thruster | 8 | 件 | pcs |  |  | 原V4为电源正/负/PWM三线；线长按安装位置实测定制，不采用Pro三相线接法。 | The original V4 uses power-positive, power-negative and PWM wires. Measure cable lengths on the selected frame; do not use the Pro three-phase wiring scheme. | 原文列明，采购前核对 | Listed in source; verify before purchase | https://item.taobao.com/item.htm?id=591864716045 | v4-parts; v4-electrical | https://iwin-fins.feishu.cn/wiki/BQjFwY7GeiFW2KkmTXWcBC7fn8d; https://iwin-fins.feishu.cn/wiki/R7XGwUqQZiNfqGkNGA8cCkj1nsh
v4-servo | V4 | 电子与执行器 | Electronics and actuators | 舵机 | Servo | 2 | 件 | pcs | 配件表数量2；旧电路表数量4，不相加。 | The parts list says 2; the older electrical list says 4. Do not add them. | 旧电路表和V4-ly固件保留4路；按当前相机/机构实装数量确认。 | The older electrical list and V4-ly firmware retain four channels. Confirm the installed camera/mechanism configuration. | 来源冲突，待实物确认 | Conflicting sources; confirm against the vehicle | https://item.taobao.com/item.htm?id=853148098562 | v4-parts; v4-electrical; v4-firmware | https://iwin-fins.feishu.cn/wiki/BQjFwY7GeiFW2KkmTXWcBC7fn8d; https://iwin-fins.feishu.cn/wiki/R7XGwUqQZiNfqGkNGA8cCkj1nsh; https://gitee.com/superkinkin/IWIN-FINS/tree/42e5f16f5b3ad3e23fceb5eb60868340b365dfd5/
v4-pressure-sensor | V4 | 电子与执行器 | Electronics and actuators | 水深/水压传感器 | Depth/pressure sensor | 4 | 件 | pcs |  |  | 配件表：不锈钢、10m选项；旧商品标题含MS5837-30BA。选项/实际型号须核对，10m不是整机潜深。 旧接线使用随附转接板，需核对是否包含在传感器供货中。 | Parts list: stainless steel, 10 m option. An older product title mentions MS5837-30BA. Confirm the actual model/option; 10 m is not the vehicle depth rating. The older wiring uses the supplied adapter board; verify that it is included with the sensor. | 原文列明，采购前核对 | Listed in source; verify before purchase | https://item.taobao.com/item.htm?id=605375059849 | v4-parts; v4-electrical | https://iwin-fins.feishu.cn/wiki/BQjFwY7GeiFW2KkmTXWcBC7fn8d; https://iwin-fins.feishu.cn/wiki/R7XGwUqQZiNfqGkNGA8cCkj1nsh
v4-battery | V4 | 电子与执行器 | Electronics and actuators | 4S电池 | 4S battery | 1 | 件 | pcs |  |  | XT60主电源接口；旧电路文档记10000mAh、25C，配件表只确认4S/XT60。 | XT60 main-power connector. The older electrical document records 10000 mAh and 25C; the parts list confirms only 4S/XT60. | 原文列明，采购前核对 | Listed in source; verify before purchase | https://item.taobao.com/item.htm?id=609820541557 | v4-parts; v4-electrical | https://iwin-fins.feishu.cn/wiki/BQjFwY7GeiFW2KkmTXWcBC7fn8d; https://iwin-fins.feishu.cn/wiki/R7XGwUqQZiNfqGkNGA8cCkj1nsh
v4-relay | V4 | 电子与执行器 | Electronics and actuators | 继电器/电源开关模块 | Relay/power-switch module | 1 | 件 | pcs |  |  | 配件表写30A，旧电路文档写120A；原短链接不作为型号或额定电流证明。 | The parts list says 30 A and the older electrical document says 120 A. The original short link is not evidence of the model or current rating. | 来源冲突，待实物确认 | Conflicting sources; confirm against the vehicle |  | v4-parts; v4-electrical | https://iwin-fins.feishu.cn/wiki/BQjFwY7GeiFW2KkmTXWcBC7fn8d; https://iwin-fins.feishu.cn/wiki/R7XGwUqQZiNfqGkNGA8cCkj1nsh
v4-rotary-switch | V4 | 电子与执行器 | Electronics and actuators | 水下旋钮开关 | Underwater rotary switch | 1 | 件 | pcs |  |  | 主电源控制路径中的开关；按实际器件核对接口和触点能力。 | Switch in the main-power control path; verify the connections and contact rating of the actual part. | 原文列明，采购前核对 | Listed in source; verify before purchase | https://item.taobao.com/item.htm?id=746272975983 | v4-parts; v4-electrical | https://iwin-fins.feishu.cn/wiki/BQjFwY7GeiFW2KkmTXWcBC7fn8d; https://iwin-fins.feishu.cn/wiki/R7XGwUqQZiNfqGkNGA8cCkj1nsh
v4-buck-converter | V4 | 电子与执行器 | Electronics and actuators | 降压模块 | DC-DC step-down converter | 1 | 件 | pcs |  |  | 用于树莓派和机构支路；各负载电压/电流分别核对。 | Supplies the Raspberry Pi and mechanism branches; confirm voltage/current requirements for each load. | 原文列明，采购前核对 | Listed in source; verify before purchase | https://item.taobao.com/item.htm?id=856012812115 | v4-parts; v4-electrical | https://iwin-fins.feishu.cn/wiki/BQjFwY7GeiFW2KkmTXWcBC7fn8d; https://iwin-fins.feishu.cn/wiki/R7XGwUqQZiNfqGkNGA8cCkj1nsh
v4-power-distribution | V4 | 电子与执行器 | Electronics and actuators | 分电板 | Power distribution board | 1 | 件 | pcs | 数量1来自旧电路表；当前配件表未列。 | Quantity 1 comes from the older electrical list; it is absent from the current parts list. | 旧电路用于树莓派/舵机支路；正文也允许自制分线，不与其他分支方案重复采购。 | The older wiring uses it for Raspberry Pi/servo branches and also describes a custom split harness. Do not duplicate alternative distribution solutions. | 历史替代项，不与当前清单累加 | Historical alternative; do not add to current quantities | https://item.taobao.com/item.htm?id=814381038913 | v4-electrical | https://iwin-fins.feishu.cn/wiki/R7XGwUqQZiNfqGkNGA8cCkj1nsh
v4-raspberry-pi | V4 | 电子与执行器 | Electronics and actuators | 树莓派4B | Raspberry Pi 4B | 1 | 件 | pcs |  |  | 舱内计算机；内存规格和存储介质未在配件表明确。 | Onboard computer; RAM and storage specifications are not stated in the parts list. | 原文列明，采购前核对 | Listed in source; verify before purchase | https://detail.tmall.com/item.htm?id=705995475782 | v4-parts; v4-electrical | https://iwin-fins.feishu.cn/wiki/BQjFwY7GeiFW2KkmTXWcBC7fn8d; https://iwin-fins.feishu.cn/wiki/R7XGwUqQZiNfqGkNGA8cCkj1nsh
v4-controller | V4 | 电子与执行器 | Electronics and actuators | RoboMaster C板 | RoboMaster C board | 1 | 件 | pcs |  |  | 系统资料中的V4主控；固件工程目标为STM32F407IGHx，按实际板卡核对。 | V4 controller named in the system documentation. The firmware project targets STM32F407IGHx; verify the actual board. | 原文列明，采购前核对 | Listed in source; verify before purchase | https://item.taobao.com/item.htm?id=611226266955 | v4-parts; v4-electrical; v4-firmware | https://iwin-fins.feishu.cn/wiki/BQjFwY7GeiFW2KkmTXWcBC7fn8d; https://iwin-fins.feishu.cn/wiki/R7XGwUqQZiNfqGkNGA8cCkj1nsh; https://gitee.com/superkinkin/IWIN-FINS/tree/42e5f16f5b3ad3e23fceb5eb60868340b365dfd5/
v4-h30-imu | V4 | 电子与执行器 | Electronics and actuators | H30 IMU（源码依赖） | H30 IMU (firmware dependency) |  | 件 | pcs | 原文未给出可确认的数量；不等于0。 | No confirmed quantity is given in the source; this does not mean zero. | V4-ly姿态反馈来自H30，USART1 921600 8N1；启动还检查BMI088。实际H30采购型号与安装需补录。 | V4-ly attitude feedback uses H30 on USART1 at 921600 8N1; startup also checks BMI088. Record the actual H30 purchase model and mounting. | 数量或规格缺失 | Quantity or specification missing |  | v4-firmware | https://gitee.com/superkinkin/IWIN-FINS/tree/42e5f16f5b3ad3e23fceb5eb60868340b365dfd5/
v4-pca9685 | V4 | 电子与执行器 | Electronics and actuators | PCA9685 PWM扩展板 | PCA9685 PWM expansion board | 1 | 件 | pcs |  |  | 推进器使用通道0–7；固件舵机预留通道8–11，逻辑VCC与V+负载电源区分。 | Thrusters use channels 0–7; firmware reserves channels 8–11 for servos. Distinguish logic VCC from the V+ load supply. | 原文列明，采购前核对 | Listed in source; verify before purchase | https://detail.tmall.com/item.htm?id=624960039615 | v4-parts; v4-electrical; v4-firmware | https://iwin-fins.feishu.cn/wiki/BQjFwY7GeiFW2KkmTXWcBC7fn8d; https://iwin-fins.feishu.cn/wiki/R7XGwUqQZiNfqGkNGA8cCkj1nsh; https://gitee.com/superkinkin/IWIN-FINS/tree/42e5f16f5b3ad3e23fceb5eb60868340b365dfd5/
v4-i2c-expander | V4 | 电子与执行器 | Electronics and actuators | I2C扩展板 | I2C multiplexer board | 1 | 件 | pcs |  |  | 固件为TCA9548A；0–3通道接压力传感器，4通道接PCA9685。 | Firmware uses TCA9548A: channels 0–3 for pressure sensors and channel 4 for PCA9685. | 原文列明，采购前核对 | Listed in source; verify before purchase | https://item.taobao.com/item.htm?id=612860784973 | v4-parts; v4-electrical; v4-firmware | https://iwin-fins.feishu.cn/wiki/BQjFwY7GeiFW2KkmTXWcBC7fn8d; https://iwin-fins.feishu.cn/wiki/R7XGwUqQZiNfqGkNGA8cCkj1nsh; https://gitee.com/superkinkin/IWIN-FINS/tree/42e5f16f5b3ad3e23fceb5eb60868340b365dfd5/
v4-camera | V4 | 电子与执行器 | Electronics and actuators | 相机 | Camera | 1 | 件 | pcs |  |  | 完整设计含双目方案，后有2025-07-10单目支架更新；按所选支架与接口确认。 | The full design includes a stereo-camera arrangement; a monocular mount update dated 2025-07-10 is separate. Match the camera to the selected mount and interface. | 原文列明，采购前核对 | Listed in source; verify before purchase | https://item.taobao.com/item.htm?id=793615736142 | v4-parts; v4-design | https://iwin-fins.feishu.cn/wiki/BQjFwY7GeiFW2KkmTXWcBC7fn8d; https://iwin-fins.feishu.cn/wiki/Ty7WwhJmCihi7qk3Gx8cAL93n8f
v4-wireless-debugger | V4 | 电子与执行器 | Electronics and actuators | 无线调试/烧写器 | Wireless debugger/programmer | 1 | 件 | pcs |  |  | 按实际SWD接口与工具支持情况核对。 | Verify compatibility with the actual SWD connection and programming tool. | 原文列明，采购前核对 | Listed in source; verify before purchase | https://item.taobao.com/item.htm?id=745548099223 | v4-parts | https://iwin-fins.feishu.cn/wiki/BQjFwY7GeiFW2KkmTXWcBC7fn8d
v4-usb-ttl | V4 | 历史接线替代项 | Historical wiring alternatives | USB转TTL模块 | USB-to-TTL adapter | 1 | 件 | pcs | 数量1来自旧电路表；当前配件表未列。 | Quantity 1 comes from the older electrical list; it is absent from the current parts list. | 旧电路的可选UART连接方法；与直接GPIO UART方案区分。 | Optional UART connection in the older electrical document; distinguish it from direct GPIO UART wiring. | 历史替代项，不与当前清单累加 | Historical alternative; do not add to current quantities |  | v4-electrical | https://iwin-fins.feishu.cn/wiki/R7XGwUqQZiNfqGkNGA8cCkj1nsh
v4-servo-thruster-connectors | V4 | 连接器与线材 | Connectors and cabling | 舵机/推进器水密接插件 | Watertight servo/thruster connectors | 12 | 组 | sets | 原表记12，未写包装单位；按配对说明暂列组，须核对。旧8推进器+4舵机与当前舵机2的差异勿忽略。 | The source says 12 without a package unit; listed as sets from the mating-pair description, subject to confirmation. Note the older 8-thruster/4-servo layout versus the current 2-servo list. | 3芯母座+公缆；先确定设备位置和线长，再交由厂家定制。 | Three-pin receptacle plus male cable; confirm equipment positions and cable lengths before custom assembly. | 来源冲突，待实物确认 | Conflicting sources; confirm against the vehicle | https://item.taobao.com/item.htm?id=811948973422 | v4-parts | https://iwin-fins.feishu.cn/wiki/BQjFwY7GeiFW2KkmTXWcBC7fn8d
v4-connector-caps | V4 | 连接器与线材 | Connectors and cabling | 3芯公堵头 | Three-pin male blanking plugs | 2 | 件 | pcs |  |  | 用于未使用的舵机/推进器接口，与母座配套。 | For unused servo/thruster connectors; match the mating receptacle. | 原文列明，采购前核对 | Listed in source; verify before purchase | https://item.taobao.com/item.htm?id=811948973422 | v4-parts | https://iwin-fins.feishu.cn/wiki/BQjFwY7GeiFW2KkmTXWcBC7fn8d
v4-pressure-sleeves | V4 | 连接器与线材 | Connectors and cabling | 水压计外置套管 | External pressure-sensor sleeves | 4 | 件 | pcs |  |  | 用于传感器线缆延长和灌封；密封工艺按所购材料说明。 | For sensor-cable extension and potting; follow the purchased materials/process specifications. | 原文列明，采购前核对 | Listed in source; verify before purchase | https://item.taobao.com/item.htm?id=781752613399 | v4-parts; v4-design | https://iwin-fins.feishu.cn/wiki/BQjFwY7GeiFW2KkmTXWcBC7fn8d; https://iwin-fins.feishu.cn/wiki/Ty7WwhJmCihi7qk3Gx8cAL93n8f
v4-pressure-connectors | V4 | 连接器与线材 | Connectors and cabling | 水压计水密接插件 | Watertight pressure-sensor connectors | 4 | 组 | sets | 原表数量4；配对件以组列出，商品包装单位待确认。 | The source quantity is 4; mating pairs are listed as sets. Confirm the supplier package unit. | 定制00W 4芯插头+插座；厂家4芯电缆65cm。 | Custom 00W four-pin plug and receptacle; 65 cm vendor-supplied four-core cable. | 原文列明，采购前核对 | Listed in source; verify before purchase | https://item.taobao.com/item.htm?id=619481441943 | v4-parts | https://iwin-fins.feishu.cn/wiki/BQjFwY7GeiFW2KkmTXWcBC7fn8d
v4-ethernet-tether | V4 | 连接器与线材 | Connectors and cabling | 零浮力网线 | Neutral-buoyancy Ethernet tether | 100 | 米 | m | 100为原表长度记录，不是100条电缆；是否对应单台需求待确认。 | 100 is a recorded length, not 100 cables; confirm whether it is the per-vehicle requirement. | 原表数量栏写“零浮力网线，100m”；端接、外径、芯数与长度定义需和接插件确认。 | The quantity cell states “neutral-buoyancy Ethernet cable, 100 m”. Confirm termination, outer diameter, core count and length definition with the connector supplier. | 原文列明，采购前核对 | Listed in source; verify before purchase |  | v4-parts | https://iwin-fins.feishu.cn/wiki/BQjFwY7GeiFW2KkmTXWcBC7fn8d
v4-tether-connector | V4 | 连接器与线材 | Connectors and cabling | 电缆接插件 | Tether connector | 1 | 件 | pcs |  |  | 1W 8芯插头；配对插座与端接方案未完整列出。 | 1W eight-pin plug; the mating receptacle and termination arrangement are not fully specified. | 原文列明，采购前核对 | Listed in source; verify before purchase |  | v4-parts | https://iwin-fins.feishu.cn/wiki/BQjFwY7GeiFW2KkmTXWcBC7fn8d
v4-camera-connector | V4 | 连接器与线材 | Connectors and cabling | 相机接插件 | Camera connector |  | 件 | pcs | 原文未给出可确认的数量；不等于0。 | No confirmed quantity is given in the source; this does not mean zero. | 1W 4芯插头；按实际相机和穿舱方案核对。 | 1W four-pin plug; verify against the actual camera and cable-penetration design. | 数量或规格缺失 | Quantity or specification missing |  | v4-parts | https://iwin-fins.feishu.cn/wiki/BQjFwY7GeiFW2KkmTXWcBC7fn8d
v4-terminal-20p | V4 | 连接器与线材 | Connectors and cabling | H3800 20P接线端子 | H3800 20-position terminal block | 2 | 件 | pcs |  |  | 按当前板架孔位与线束表配套。 | Match the current mounting holes and wiring schedule. | 原文列明，采购前核对 | Listed in source; verify before purchase | https://item.taobao.com/item.htm?id=661948958655 | v4-parts | https://iwin-fins.feishu.cn/wiki/BQjFwY7GeiFW2KkmTXWcBC7fn8d
v4-terminal-16p | V4 | 连接器与线材 | Connectors and cabling | H3803 16P接线端子 | H3803 16-position terminal block | 2 | 件 | pcs |  |  | 按动力/支路线束和实物端子规格核对。 | Verify against the power/branch harnesses and the actual terminal specification. | 原文列明，采购前核对 | Listed in source; verify before purchase | https://item.taobao.com/item.htm?id=551775262138 | v4-parts | https://iwin-fins.feishu.cn/wiki/BQjFwY7GeiFW2KkmTXWcBC7fn8d
v4-terminal-6p | V4 | 连接器与线材 | Connectors and cabling | H3800 6P接线端子 | H3800 6-position terminal block | 2 | 件 | pcs |  |  | 旧电路正文另有6针/7针布局；不与历史端子行累加。 | An older document describes a different six-/seven-pin layout. Do not add the historical terminal rows to this quantity. | 原文列明，采购前核对 | Listed in source; verify before purchase | https://item.taobao.com/item.htm?id=661948958655 | v4-parts; v4-electrical | https://iwin-fins.feishu.cn/wiki/BQjFwY7GeiFW2KkmTXWcBC7fn8d; https://iwin-fins.feishu.cn/wiki/R7XGwUqQZiNfqGkNGA8cCkj1nsh
v4-bridge-3-5mm | V4 | 连接器与线材 | Connectors and cabling | 3.5mm 10P短接件 | 3.5 mm ten-position jumper bridge | 2 | 件 | pcs |  |  | FBS10-3.5，红色，黄铜；与端子系列匹配。 | FBS10-3.5, red, brass; match the terminal-block series. | 原文列明，采购前核对 | Listed in source; verify before purchase | https://detail.tmall.com/item.htm?id=622709470719 | v4-parts | https://iwin-fins.feishu.cn/wiki/BQjFwY7GeiFW2KkmTXWcBC7fn8d
v4-bridge-6-2mm | V4 | 连接器与线材 | Connectors and cabling | 6.2mm 10P短接件 | 6.2 mm ten-position jumper bridge | 2 | 件 | pcs |  |  | 10P EB连接件；与端子系列匹配。 | Ten-position EB bridge; match the terminal-block series. | 原文列明，采购前核对 | Listed in source; verify before purchase | https://item.taobao.com/item.htm?id=551775262138 | v4-parts | https://iwin-fins.feishu.cn/wiki/BQjFwY7GeiFW2KkmTXWcBC7fn8d
v4-usb-c-power-cable | V4 | 连接器与线材 | Connectors and cabling | 树莓派Type-C供电线 | Raspberry Pi USB-C power cable | 1 | 件 | pcs |  |  | 原表记录双左右弯头；按供电电流和安装空间核对。 | The source specifies two left/right angled connectors; verify current capability and available space. | 原文列明，采购前核对 | Listed in source; verify before purchase | https://detail.tmall.com/item.htm?id=739417974339 | v4-parts | https://iwin-fins.feishu.cn/wiki/BQjFwY7GeiFW2KkmTXWcBC7fn8d
v4-historical-6pin-large | V4 | 历史接线替代项 | Historical wiring alternatives | 旧方案大6针座 | Large six-pin terminal blocks, older layout | 4 | 件 | pcs |  |  | 旧电路用于推进器，每路为正/负/信号三线。 | The older wiring uses these for thrusters with positive/negative/signal wiring. | 历史替代项，不与当前清单累加 | Historical alternative; do not add to current quantities |  | v4-electrical | https://iwin-fins.feishu.cn/wiki/R7XGwUqQZiNfqGkNGA8cCkj1nsh
v4-historical-6pin-small | V4 | 历史接线替代项 | Historical wiring alternatives | 旧方案小6针座 | Small six-pin terminal blocks, older layout | 2 | 件 | pcs |  |  | 旧电路用于舵机；与当前H3800等布局不叠加。 | Used for servos in the older wiring; do not add to the current H3800-series layout. | 历史替代项，不与当前清单累加 | Historical alternative; do not add to current quantities |  | v4-electrical | https://iwin-fins.feishu.cn/wiki/R7XGwUqQZiNfqGkNGA8cCkj1nsh
v4-historical-7pin-small | V4 | 历史接线替代项 | Historical wiring alternatives | 旧方案小7针座 | Small seven-pin terminal block, older layout |  | 件 | pcs | 原文未给出可确认的数量；不等于0。 | No confirmed quantity is given in the source; this does not mean zero. | UART三线+SWD四线；原正文没有明确数量。 | Three UART wires plus four SWD wires; the source gives no explicit quantity. | 历史替代项，不与当前清单累加 | Historical alternative; do not add to current quantities |  | v4-electrical | https://iwin-fins.feishu.cn/wiki/R7XGwUqQZiNfqGkNGA8cCkj1nsh
v4-historical-stlink | V4 | 历史接线替代项 | Historical wiring alternatives | ST-Link调试器（旧接法） | ST-Link debugger (older connection) |  | 件 | pcs | 原文未给出可确认的数量；不等于0。 | No confirmed quantity is given in the source; this does not mean zero. | 旧接线步骤提及ST-Link；与无线调试器属不同调试方案，不默认同时采购。 | The older wiring steps mention ST-Link. It is an alternative to the wireless debugger, not an automatic additional purchase. | 历史替代项，不与当前清单累加 | Historical alternative; do not add to current quantities |  | v4-electrical | https://iwin-fins.feishu.cn/wiki/R7XGwUqQZiNfqGkNGA8cCkj1nsh
v4-switch-extension-wire | V4 | 紧固件与装配材料 | Fasteners and assembly materials | 24AWG开关延长线 | 24 AWG switch-extension wire |  | 米 | m | 原文未给出可确认的数量；不等于0。 | No confirmed quantity is given in the source; this does not mean zero. | 旧电路只在需要延长旋钮开关线时指定24AWG，未给总长度。 | The older electrical text specifies 24 AWG only when the rotary-switch leads need extending; total length is not stated. | 数量或规格缺失 | Quantity or specification missing |  | v4-electrical | https://iwin-fins.feishu.cn/wiki/R7XGwUqQZiNfqGkNGA8cCkj1nsh
v4-power-y-harness | V4 | 紧固件与装配材料 | Fasteners and assembly materials | XT60与电源分支线束 | XT60 and power-split harness |  | 组 | sets | 原文未给出可确认的数量；不等于0。 | No confirmed quantity is given in the source; this does not mean zero. | 旧接线描述Y形分支与XT60连接；使用完成并核验的线束，不将旧改线操作当产品规格。 | The older wiring describes a Y split and XT60 connection. Use a completed, verified harness; the historical rewiring steps are not a product specification. | 数量或规格缺失 | Quantity or specification missing |  | v4-electrical | https://iwin-fins.feishu.cn/wiki/R7XGwUqQZiNfqGkNGA8cCkj1nsh
v4-side-support | V4 | 结构与加工件 | Mechanical and machined parts | 侧支撑 | Side support |  | 件 | pcs | CAD存在该零件，未从装配体确认实例数；不套用Pro数量。 | The CAD contains this part, but its assembly instance count is unconfirmed. Do not copy the Pro quantity. | 主体/侧支撑.STEP；同时提供DWG。 V4铝合金加工说明为黑色阳极氧化、哑光；具体材料及公差以工程图为准。 | 主体/侧支撑.STEP; a DWG is also provided. The V4 aluminum-machining instructions specify matte black anodizing; use the drawings for material and tolerances. | 数量或规格缺失 | Quantity or specification missing |  | v4-design; v4-cad | https://iwin-fins.feishu.cn/wiki/Ty7WwhJmCihi7qk3Gx8cAL93n8f; https://github.com/FPJ-GAOGE/V4-Underwater-Robot/tree/main/hardware/v4
v4-bottom-support | V4 | 结构与加工件 | Mechanical and machined parts | 底支撑2 | Bottom support 2 |  | 件 | pcs | CAD存在该零件，未从装配体确认实例数；不套用Pro数量。 | The CAD contains this part, but its assembly instance count is unconfirmed. Do not copy the Pro quantity. | 主体/底支撑2.STEP；同时提供DWG。 V4铝合金加工说明为黑色阳极氧化、哑光；具体材料及公差以工程图为准。 | 主体/底支撑2.STEP; a DWG is also provided. The V4 aluminum-machining instructions specify matte black anodizing; use the drawings for material and tolerances. | 数量或规格缺失 | Quantity or specification missing |  | v4-design; v4-cad | https://iwin-fins.feishu.cn/wiki/Ty7WwhJmCihi7qk3Gx8cAL93n8f; https://github.com/FPJ-GAOGE/V4-Underwater-Robot/tree/main/hardware/v4
v4-upper-thruster-support | V4 | 结构与加工件 | Mechanical and machined parts | 上推进器支撑 | Upper thruster support |  | 件 | pcs | CAD存在该零件，未从装配体确认实例数；不套用Pro数量。 | The CAD contains this part, but its assembly instance count is unconfirmed. Do not copy the Pro quantity. | 主体/上推进器支撑.STEP；同时提供DWG。 V4铝合金加工说明为黑色阳极氧化、哑光；具体材料及公差以工程图为准。 | 主体/上推进器支撑.STEP; a DWG is also provided. The V4 aluminum-machining instructions specify matte black anodizing; use the drawings for material and tolerances. | 数量或规格缺失 | Quantity or specification missing |  | v4-design; v4-cad | https://iwin-fins.feishu.cn/wiki/Ty7WwhJmCihi7qk3Gx8cAL93n8f; https://github.com/FPJ-GAOGE/V4-Underwater-Robot/tree/main/hardware/v4
v4-corner-piece | V4 | 结构与加工件 | Mechanical and machined parts | 角件 | Corner bracket |  | 件 | pcs | CAD存在该零件，未从装配体确认实例数；不套用Pro数量。 | The CAD contains this part, but its assembly instance count is unconfirmed. Do not copy the Pro quantity. | 主体/角件.STEP。 V4铝合金加工说明为黑色阳极氧化、哑光；具体材料及公差以工程图为准。 | 主体/角件.STEP. The V4 aluminum-machining instructions specify matte black anodizing; use the drawings for material and tolerances. | 数量或规格缺失 | Quantity or specification missing |  | v4-design; v4-cad | https://iwin-fins.feishu.cn/wiki/Ty7WwhJmCihi7qk3Gx8cAL93n8f; https://github.com/FPJ-GAOGE/V4-Underwater-Robot/tree/main/hardware/v4
v4-rear-endcap | V4 | 结构与加工件 | Mechanical and machined parts | 后舱盖165 | Rear end cap 165 |  | 件 | pcs | CAD存在该零件，未从装配体确认实例数；不套用Pro数量。 | The CAD contains this part, but its assembly instance count is unconfirmed. Do not copy the Pro quantity. | 密封舱/后舱盖165.STEP；同时提供DWG。 V4铝合金加工说明为黑色阳极氧化、哑光；具体材料及公差以工程图为准。 | 密封舱/后舱盖165.STEP; a DWG is also provided. The V4 aluminum-machining instructions specify matte black anodizing; use the drawings for material and tolerances. | 数量或规格缺失 | Quantity or specification missing |  | v4-design; v4-cad | https://iwin-fins.feishu.cn/wiki/Ty7WwhJmCihi7qk3Gx8cAL93n8f; https://github.com/FPJ-GAOGE/V4-Underwater-Robot/tree/main/hardware/v4
v4-gimbal-base | V4 | 结构与加工件 | Mechanical and machined parts | 云台底架 | Gimbal base |  | 件 | pcs | CAD存在该零件，未从装配体确认实例数；不套用Pro数量。 | The CAD contains this part, but its assembly instance count is unconfirmed. Do not copy the Pro quantity. | 相机云台/云台底架.STEP；同时提供DWG。 V4铝合金加工说明为黑色阳极氧化、哑光；具体材料及公差以工程图为准。 | 相机云台/云台底架.STEP; a DWG is also provided. The V4 aluminum-machining instructions specify matte black anodizing; use the drawings for material and tolerances. | 数量或规格缺失 | Quantity or specification missing |  | v4-design; v4-cad | https://iwin-fins.feishu.cn/wiki/Ty7WwhJmCihi7qk3Gx8cAL93n8f; https://github.com/FPJ-GAOGE/V4-Underwater-Robot/tree/main/hardware/v4
v4-rear-gimbal-base | V4 | 结构与加工件 | Mechanical and machined parts | 后云台底架 | Rear gimbal base |  | 件 | pcs | CAD存在该零件，未从装配体确认实例数；不套用Pro数量。 | The CAD contains this part, but its assembly instance count is unconfirmed. Do not copy the Pro quantity. | 相机云台/后云台底架.STEP；同时提供DWG。 V4铝合金加工说明为黑色阳极氧化、哑光；具体材料及公差以工程图为准。 | 相机云台/后云台底架.STEP; a DWG is also provided. The V4 aluminum-machining instructions specify matte black anodizing; use the drawings for material and tolerances. | 数量或规格缺失 | Quantity or specification missing |  | v4-design; v4-cad | https://iwin-fins.feishu.cn/wiki/Ty7WwhJmCihi7qk3Gx8cAL93n8f; https://github.com/FPJ-GAOGE/V4-Underwater-Robot/tree/main/hardware/v4
v4-sensor-sleeve-mount | V4 | 结构与加工件 | Mechanical and machined parts | 外置套管固定加工件 | Machined external-sleeve mount |  | 件 | pcs | CAD存在该零件，未从装配体确认实例数；不套用Pro数量。 | The CAD contains this part, but its assembly instance count is unconfirmed. Do not copy the Pro quantity. | 水深传感器/外置套管固定加工版.STEP。 V4铝合金加工说明为黑色阳极氧化、哑光；具体材料及公差以工程图为准。 | 水深传感器/外置套管固定加工版.STEP. The V4 aluminum-machining instructions specify matte black anodizing; use the drawings for material and tolerances. | 数量或规格缺失 | Quantity or specification missing |  | v4-design; v4-cad | https://iwin-fins.feishu.cn/wiki/Ty7WwhJmCihi7qk3Gx8cAL93n8f; https://github.com/FPJ-GAOGE/V4-Underwater-Robot/tree/main/hardware/v4
v4-upper-electronics-tray | V4 | 打印件与内部支撑 | Printed parts and internal supports | 上层架板 | Upper electronics tray |  | 件 | pcs | 原文未给出可确认的数量；不等于0。 | No confirmed quantity is given in the source; this does not mean zero. | 对应CAD：密封舱/舱内/上层架板.STEP；加工方式、材料和数量按所选装配确认，不能仅凭文件存在推断。 | CAD: 密封舱/舱内/上层架板.STEP. Confirm the process, material and quantity from the selected assembly; file presence alone does not establish them. | 数量或规格缺失 | Quantity or specification missing |  | v4-cad | https://github.com/FPJ-GAOGE/V4-Underwater-Robot/tree/main/hardware/v4
v4-lower-electronics-tray | V4 | 打印件与内部支撑 | Printed parts and internal supports | 下层架板 | Lower electronics tray |  | 件 | pcs | 原文未给出可确认的数量；不等于0。 | No confirmed quantity is given in the source; this does not mean zero. | 对应CAD：密封舱/舱内/下层架板.STEP；加工方式、材料和数量按所选装配确认，不能仅凭文件存在推断。 | CAD: 密封舱/舱内/下层架板.STEP. Confirm the process, material and quantity from the selected assembly; file presence alone does not establish them. | 数量或规格缺失 | Quantity or specification missing |  | v4-cad | https://github.com/FPJ-GAOGE/V4-Underwater-Robot/tree/main/hardware/v4
v4-battery-tray | V4 | 打印件与内部支撑 | Printed parts and internal supports | 电池架 | Battery holder |  | 件 | pcs | 原文未给出可确认的数量；不等于0。 | No confirmed quantity is given in the source; this does not mean zero. | 对应CAD：密封舱/舱内/电池架.STEP；加工方式、材料和数量按所选装配确认，不能仅凭文件存在推断。 | CAD: 密封舱/舱内/电池架.STEP. Confirm the process, material and quantity from the selected assembly; file presence alone does not establish them. | 数量或规格缺失 | Quantity or specification missing |  | v4-cad | https://github.com/FPJ-GAOGE/V4-Underwater-Robot/tree/main/hardware/v4
v4-camera-link | V4 | 打印件与内部支撑 | Printed parts and internal supports | 相机连接件 | Camera mounting link |  | 件 | pcs | 原文未给出可确认的数量；不等于0。 | No confirmed quantity is given in the source; this does not mean zero. | 对应CAD：相机云台/相机连接件.STEP；加工方式、材料和数量按所选装配确认，不能仅凭文件存在推断。 | CAD: 相机云台/相机连接件.STEP. Confirm the process, material and quantity from the selected assembly; file presence alone does not establish them. | 数量或规格缺失 | Quantity or specification missing |  | v4-cad | https://github.com/FPJ-GAOGE/V4-Underwater-Robot/tree/main/hardware/v4
v4-servo-link | V4 | 打印件与内部支撑 | Printed parts and internal supports | 舵机连接件 | Servo mounting link |  | 件 | pcs | 原文未给出可确认的数量；不等于0。 | No confirmed quantity is given in the source; this does not mean zero. | 对应CAD：相机云台/舵机连接件.STEP；加工方式、材料和数量按所选装配确认，不能仅凭文件存在推断。 | CAD: 相机云台/舵机连接件.STEP. Confirm the process, material and quantity from the selected assembly; file presence alone does not establish them. | 数量或规格缺失 | Quantity or specification missing |  | v4-cad | https://github.com/FPJ-GAOGE/V4-Underwater-Robot/tree/main/hardware/v4
v4-buoyancy-shell | V4 | 打印件与内部支撑 | Printed parts and internal supports | 浮力外壳2 | Buoyancy shell 2 |  | 件 | pcs | 原文未给出可确认的数量；不等于0。 | No confirmed quantity is given in the source; this does not mean zero. | 对应CAD：浮力外壳/浮力外壳2.STEP；加工方式、材料和数量按所选装配确认，不能仅凭文件存在推断。 | CAD: 浮力外壳/浮力外壳2.STEP. Confirm the process, material and quantity from the selected assembly; file presence alone does not establish them. | 数量或规格缺失 | Quantity or specification missing |  | v4-cad | https://github.com/FPJ-GAOGE/V4-Underwater-Robot/tree/main/hardware/v4
v4-sealed-housing | V4 | 结构与加工件 | Mechanical and machined parts | 密封舱及配套密封/固定件 | Sealed enclosure and associated seals/mounts |  | 组（待展开） | assembly (breakdown required) | 原文未给出可确认的数量；不等于0。 | No confirmed quantity is given in the source; this does not mean zero. | 制造步骤提及密封舱与后舱盖；未给出完整舱体/密封件采购展开和额定潜深。 | The manufacturing steps mention the sealed enclosure and rear cap, but do not provide a complete enclosure/seal purchase breakdown or a vehicle depth rating. | 数量或规格缺失 | Quantity or specification missing |  | v4-design | https://iwin-fins.feishu.cn/wiki/Ty7WwhJmCihi7qk3Gx8cAL93n8f
v4-heat-set-inserts | V4 | 紧固件与装配材料 | Fasteners and assembly materials | M2.5/M3预埋螺母 | M2.5/M3 heat-set inserts |  | 件 | pcs | 原文未给出可确认的数量；不等于0。 | No confirmed quantity is given in the source; this does not mean zero. | 树莓派、PWM扩展板相关位置用M2.5，其他指定位置M3；并非每个孔都装。 | Use M2.5 at Raspberry Pi/PWM-board positions and M3 at other specified positions; not every hole receives an insert. | 数量或规格缺失 | Quantity or specification missing |  | v4-design | https://iwin-fins.feishu.cn/wiki/Ty7WwhJmCihi7qk3Gx8cAL93n8f
v4-nylon-standoffs | V4 | 紧固件与装配材料 | Fasteners and assembly materials | M2.5/M3尼龙柱 | M2.5/M3 nylon standoffs |  | 件 | pcs | 原文未给出可确认的数量；不等于0。 | No confirmed quantity is given in the source; this does not mean zero. | 树莓派/PWM板M2.5，其余指定位置M3；C板和端子不使用同样支柱。 | M2.5 for Raspberry Pi/PWM-board positions and M3 elsewhere as specified; the C board and terminals do not use the same standoffs. | 数量或规格缺失 | Quantity or specification missing |  | v4-design | https://iwin-fins.feishu.cn/wiki/Ty7WwhJmCihi7qk3Gx8cAL93n8f
v4-fasteners | V4 | 紧固件与装配材料 | Fasteners and assembly materials | 框架与板架紧固件 | Frame and electronics-mount fasteners |  | 件 | pcs | 原文未给出可确认的数量；不等于0。 | No confirmed quantity is given in the source; this does not mean zero. | 按2025-05-23装配与螺纹工程图展开，原文无统一规格/数量表。 | Derive from the 2025-05-23 assembly and threaded-hole drawings; the source has no consolidated size/quantity list. | 数量或规格缺失 | Quantity or specification missing |  | v4-design; v4-cad | https://iwin-fins.feishu.cn/wiki/Ty7WwhJmCihi7qk3Gx8cAL93n8f; https://github.com/FPJ-GAOGE/V4-Underwater-Robot/tree/main/hardware/v4
v4-potting-material | V4 | 紧固件与装配材料 | Fasteners and assembly materials | 环氧灌封与绝缘材料 | Epoxy potting and insulating materials |  | 用量待定 | amount TBD | 原文未给出可确认的数量；不等于0。 | No confirmed quantity is given in the source; this does not mean zero. | 原文要求焊后环氧灌封，旧电气文档要求封住未使用分电点；配比/用量未给。 | The source requires epoxy potting after soldering and insulation of unused distribution points; mixture and quantity are not specified. | 数量或规格缺失 | Quantity or specification missing |  | v4-design; v4-electrical | https://iwin-fins.feishu.cn/wiki/Ty7WwhJmCihi7qk3Gx8cAL93n8f; https://iwin-fins.feishu.cn/wiki/R7XGwUqQZiNfqGkNGA8cCkj1nsh
v4-monocular-mount-update | V4 | 可选机构与后续更新 | Optional mechanisms and later updates | 2025-07-10单目相机支架更新 | 2025-07-10 monocular-camera mount update |  | 组（待展开） | assembly (breakdown required) | 原文未给出可确认的数量；不等于0。 | No confirmed quantity is given in the source; this does not mean zero. | 独立的相机支架1/2两份SLDPRT，不代表每台各采购1件；按所选机构确认。 | Two separate SLDPRT definitions, 相机支架1 and 相机支架2; this does not establish one of each per vehicle. Confirm the chosen mechanism. | 可选设计资料，非默认装配 | Optional design files; not part of the default assembly |  | v4-design; v4-cad | https://iwin-fins.feishu.cn/wiki/Ty7WwhJmCihi7qk3Gx8cAL93n8f; https://github.com/FPJ-GAOGE/V4-Underwater-Robot/tree/main/hardware/v4
v4-gripper-design | V4 | 可选机构与后续更新 | Optional mechanisms and later updates | 机械爪设计附加包 | Optional gripper design package |  | 组（待展开） | assembly (breakdown required) | 原文未给出可确认的数量；不等于0。 | No confirmed quantity is given in the source; this does not mean zero. | 含主动/从动齿轮、圆法兰、夹手、拉杆、基座和顶盖模型；实例数及与主机集成未确认。 | Contains driving/driven gears, a circular flange, gripper finger, link rod, base and top-cover models. Instance counts and vehicle integration are unconfirmed. | 可选设计资料，非默认装配 | Optional design files; not part of the default assembly |  | v4-design; v4-cad | https://iwin-fins.feishu.cn/wiki/Ty7WwhJmCihi7qk3Gx8cAL93n8f; https://github.com/FPJ-GAOGE/V4-Underwater-Robot/tree/main/hardware/v4
