FPJ-GAOGE/V4-Underwater-Robot/hardware/bom/V4-pro-BOM.csv

条目 ID / Item ID | 型号 / Variant | 类别 | Category | 元件 / 零件 | Component / Part | 数量 / Quantity | 单位 | Unit | 数量依据 / 备注 | Quantity basis / Notes | 规格及型号差异 | Specifications and variant details | 状态 | Status | 原商品记录 / Original supplier link | 来源 ID / Source IDs | 来源链接 / Source URLs
v4-pro-thruster | V4-pro | 电子与执行器 | Electronics and actuators | 无刷推进器（不带电调） | Brushless thruster without ESC | 8 | 件 | pcs |  |  | 4正桨+4反桨；一正一反为一组，4组线长65/50/38/32cm。三根电机相线，不是V4正/负/PWM线。 | Four CW and four CCW propellers, paired one of each; the four cable groups are 65/50/38/32 cm. Three motor-phase wires, not the V4 power-positive/negative/PWM arrangement. | 原文列明，采购前核对 | Listed in source; verify before purchase | https://item.taobao.com/item.htm?id=591864716045 | pro-making | https://iwin-fins.feishu.cn/wiki/RfVuwKMnqisR3rkWaFmcW6bOnVh
v4-pro-esc | V4-pro | 电子与执行器 | Electronics and actuators | 四合一电调 | Four-in-one ESC | 2 | 件 | pcs |  |  | 共8电机通道；FineSUB使用DSHOT双向3D及遥测，电调型号/电压/固件参数待确认。 | Eight motor channels total. FineSUB uses DSHOT with bidirectional 3D mode and telemetry; confirm the ESC model, voltage and firmware settings. | 原文列明，采购前核对 | Listed in source; verify before purchase |  | pro-making; pro-firmware | https://iwin-fins.feishu.cn/wiki/RfVuwKMnqisR3rkWaFmcW6bOnVh; https://gitee.com/gan-ju/FineSUB/tree/5a7832648206e522e9b8e0dff108638789f6afdd/
v4-pro-pressure-sensor | V4-pro | 电子与执行器 | Electronics and actuators | 水深/水压传感器 | Depth/pressure sensor | 4 | 件 | pcs |  |  | 316L不锈钢、10m选项；定制70cm防水线，1红/2黑/3绿SCL/4白SDA。10m不是整机潜深。 | 316L stainless steel, 10 m option; custom 70 cm waterproof leads, pin 1 red/2 black/3 green SCL/4 white SDA. The 10 m option is not a vehicle depth rating. | 原文列明，采购前核对 | Listed in source; verify before purchase | https://item.taobao.com/item.htm?id=605375059849 | pro-making | https://iwin-fins.feishu.cn/wiki/RfVuwKMnqisR3rkWaFmcW6bOnVh
v4-pro-fill-light | V4-pro | 电子与执行器 | Electronics and actuators | PWM补光灯 | PWM fill light | 2 | 件 | pcs |  |  | ArduSub脉宽控制探照灯，100°光束角；60cm防水线，1红/2黑/3黄PWM；动力供电按器件核实。 | ArduSub pulse-width-controlled light, 100° beam angle; 60 cm waterproof lead, pin 1 red/2 black/3 yellow PWM. Verify its power supply specification. | 原文列明，采购前核对 | Listed in source; verify before purchase | https://item.taobao.com/item.htm?id=934701227487 | pro-making; pro-wiring | https://iwin-fins.feishu.cn/wiki/RfVuwKMnqisR3rkWaFmcW6bOnVh; https://iwin-fins.feishu.cn/wiki/AW4WwJtehiJW3mk2VVbcxBXOnje
v4-pro-servo | V4-pro | 电子与执行器 | Electronics and actuators | 舵机 | Servo | 2 | 件 | pcs |  |  | 75cm防水线，1红/2黑/3黄PWM。接线简图标5V，制作文字要求A板可调负载电源8.4V，必须核对。 | 75 cm waterproof lead, pin 1 red/2 black/3 yellow PWM. The simplified drawing says 5 V while the manufacturing text specifies an 8.4 V adjustable board supply; resolve this before assembly. | 来源冲突，待实物确认 | Conflicting sources; confirm against the vehicle | https://item.taobao.com/item.htm?id=853148098562 | pro-making; pro-wiring | https://iwin-fins.feishu.cn/wiki/RfVuwKMnqisR3rkWaFmcW6bOnVh; https://iwin-fins.feishu.cn/wiki/AW4WwJtehiJW3mk2VVbcxBXOnje
v4-pro-controller | V4-pro | 电子与执行器 | Electronics and actuators | RoboMaster A板 | RoboMaster A board | 1 | 件 | pcs |  |  | STM32F427；推进器为DSHOT，灯具/舵机是独立PWM输出；核对板卡和负载供电。 | STM32F427. Thrusters use DSHOT; lights/servos use separate PWM outputs. Verify board and load supplies. | 原文列明，采购前核对 | Listed in source; verify before purchase | https://item.taobao.com/item.htm?id=605165393036 | pro-making; pro-firmware | https://iwin-fins.feishu.cn/wiki/RfVuwKMnqisR3rkWaFmcW6bOnVh; https://gitee.com/gan-ju/FineSUB/tree/5a7832648206e522e9b8e0dff108638789f6afdd/
v4-pro-jetson | V4-pro | 电子与执行器 | Electronics and actuators | Jetson Orin模块与载板 | Jetson Orin module and carrier board | 1 | 套 | set | 原文“NANO×1”；暂以一套计算机记数，模块/载板的独立采购数量待确认。 | The source says “NANO ×1”. Counted as one computer set; separate module/carrier purchase quantities require confirmation. | 制作清单记“NANO”；关联说明覆盖Orin NX/Nano、达妙载板。不是旧款Jetson Nano的通用替代。 | The manufacturing list says “NANO”; the linked setup covers Orin NX/Nano and a Damiao carrier. This is not a generic substitution with the older Jetson Nano. | 原文列明，采购前核对 | Listed in source; verify before purchase |  | pro-making; orin-setup | https://iwin-fins.feishu.cn/wiki/RfVuwKMnqisR3rkWaFmcW6bOnVh; https://iwin-fins.feishu.cn/docx/S8I9dBMNmo2dIPxhWzkcyeQsnoP
v4-pro-battery | V4-pro | 电子与执行器 | Electronics and actuators | 定制电池 | Custom battery |  | 件 | pcs | 原文未给出可确认的数量；不等于0。 | No confirmed quantity is given in the source; this does not mean zero. | 原接线图主电源标24V；容量、电芯串并联、保护及充电接口未明确，不能用商品标题补齐。 | The original wiring drawing labels the main supply 24 V. Capacity, cell configuration, protection and charging interface are unspecified; do not infer them from a product title. | 数量或规格缺失 | Quantity or specification missing |  | pro-making; pro-wiring | https://iwin-fins.feishu.cn/wiki/RfVuwKMnqisR3rkWaFmcW6bOnVh; https://iwin-fins.feishu.cn/wiki/AW4WwJtehiJW3mk2VVbcxBXOnje
v4-pro-power-distribution | V4-pro | 电子与执行器 | Electronics and actuators | 分电板 | Power distribution board |  | 件 | pcs | 原文未给出可确认的数量；不等于0。 | No confirmed quantity is given in the source; this does not mean zero. | 匹配电池、电调、主控、Jetson支路；具体型号/电流和数量未列。 | Must match the battery, ESC, controller and Jetson branches; model, current rating and quantity are not listed. | 数量或规格缺失 | Quantity or specification missing |  | pro-making; pro-wiring | https://iwin-fins.feishu.cn/wiki/RfVuwKMnqisR3rkWaFmcW6bOnVh; https://iwin-fins.feishu.cn/wiki/AW4WwJtehiJW3mk2VVbcxBXOnje
v4-pro-i2c-expander | V4-pro | 电子与执行器 | Electronics and actuators | I2C扩展板 | I2C multiplexer board |  | 件 | pcs | 原文未给出可确认的数量；不等于0。 | No confirmed quantity is given in the source; this does not mean zero. | 制作要求3.3V；当前固件为I2C2→TCA9548A地址0x70→4路水压计。 | The guide requires 3.3 V; current firmware uses I2C2 → TCA9548A at 0x70 → four pressure sensors. | 数量或规格缺失 | Quantity or specification missing | https://item.taobao.com/item.htm?id=677595693967 | pro-making; pro-firmware | https://iwin-fins.feishu.cn/wiki/RfVuwKMnqisR3rkWaFmcW6bOnVh; https://gitee.com/gan-ju/FineSUB/tree/5a7832648206e522e9b8e0dff108638789f6afdd/
v4-pro-imu | V4-pro | 电子与执行器 | Electronics and actuators | IMU | IMU |  | 件 | pcs | 原文未给出可确认的数量；不等于0。 | No confirmed quantity is given in the source; this does not mean zero. | 供应商刷400Hz固件，配置921600波特率；源码为H30/UART7，确认实际硬件型号。 | The guide requests 400 Hz firmware and 921600 baud. Firmware uses H30/UART7; confirm the actual hardware model. | 数量或规格缺失 | Quantity or specification missing | https://item.taobao.com/item.htm?id=649300089333 | pro-making; pro-firmware | https://iwin-fins.feishu.cn/wiki/RfVuwKMnqisR3rkWaFmcW6bOnVh; https://gitee.com/gan-ju/FineSUB/tree/5a7832648206e522e9b8e0dff108638789f6afdd/
v4-pro-wireless-programmer | V4-pro | 电子与执行器 | Electronics and actuators | 无线烧写器 | Wireless programmer | 2 | 件 | pcs |  |  | 按各自用途和SWD接口配套，不代表同时连接两台到一块板。 | Match each intended use and SWD interface; this does not mean attaching two programmers to one board. | 原文列明，采购前核对 | Listed in source; verify before purchase | https://item.taobao.com/item.htm?id=745548099223 | pro-making | https://iwin-fins.feishu.cn/wiki/RfVuwKMnqisR3rkWaFmcW6bOnVh
v4-pro-powerline-modem | V4-pro | 电子与执行器 | Electronics and actuators | 电力载波模块 | Power-line communication module | 2 | 件 | pcs |  |  | PC与潜器通信的成对模块，具体型号/电源参数按实物核对。 | Paired modules for PC-to-vehicle communication; confirm model and power requirements. | 原文列明，采购前核对 | Listed in source; verify before purchase | https://item.taobao.com/item.htm?id=674728822237 | pro-making | https://iwin-fins.feishu.cn/wiki/RfVuwKMnqisR3rkWaFmcW6bOnVh
v4-pro-camera | V4-pro | 电子与执行器 | Electronics and actuators | USB相机 | USB camera |  | 件 | pcs | 原文未给出可确认的数量；不等于0。 | No confirmed quantity is given in the source; this does not mean zero. | 制作步骤与Orin说明提及USB相机；型号、数量及实际视频模式未完整给出。 | The manufacturing/setup texts mention a USB camera; model, quantity and actual video modes are not fully specified. | 数量或规格缺失 | Quantity or specification missing |  | pro-making; orin-setup | https://iwin-fins.feishu.cn/wiki/RfVuwKMnqisR3rkWaFmcW6bOnVh; https://iwin-fins.feishu.cn/docx/S8I9dBMNmo2dIPxhWzkcyeQsnoP
v4-pro-rotary-switch | V4-pro | 电子与执行器 | Electronics and actuators | 旋钮开关 | Rotary power switch |  | 件 | pcs | 原文未给出可确认的数量；不等于0。 | No confirmed quantity is given in the source; this does not mean zero. | 内部焊线步骤提及；触点额定值和数量未列，不能套用V4开关条目。 | Mentioned in the internal wiring steps; contact rating and quantity are not listed. Do not substitute the V4 switch entry automatically. | 数量或规格缺失 | Quantity or specification missing |  | pro-making | https://iwin-fins.feishu.cn/wiki/RfVuwKMnqisR3rkWaFmcW6bOnVh
v4-pro-terminal-12p | V4-pro | 连接器与线材 | Connectors and cabling | H3800 12P接线端子 | H3800 12-position terminal block | 2 | 件 | pcs |  |  | 文字列12P×2；接线图另外显示20P及舵机12P等，须按最终线束重新确认。 | The text lists 12P ×2; the drawing also shows 20P and servo 12P blocks. Reconcile against the final harness. | 来源冲突，待实物确认 | Conflicting sources; confirm against the vehicle | https://item.taobao.com/item.htm?id=661948958655 | pro-making; pro-wiring | https://iwin-fins.feishu.cn/wiki/RfVuwKMnqisR3rkWaFmcW6bOnVh; https://iwin-fins.feishu.cn/wiki/AW4WwJtehiJW3mk2VVbcxBXOnje
v4-pro-terminal-drawing-extras | V4-pro | 连接器与线材 | Connectors and cabling | 接线图额外20P/12P端子（待合并） | Additional 20P/12P blocks in drawing (reconciliation pending) |  | 件 | pcs | 原文未给出可确认的数量；不等于0。 | No confirmed quantity is given in the source; this does not mean zero. | 用于记录图文差异，不作为在12P×2之外已确认需要追加的数量。 | Records the drawing/text discrepancy; it is not a confirmed extra quantity on top of the listed 12P ×2. | 来源冲突，待实物确认 | Conflicting sources; confirm against the vehicle |  | pro-wiring | https://iwin-fins.feishu.cn/wiki/AW4WwJtehiJW3mk2VVbcxBXOnje
v4-pro-thruster-connectors | V4-pro | 连接器与线材 | Connectors and cabling | 推进器1W 3芯水密接插件 | Thruster 1W three-pin watertight connectors |  | 组（待核对） | sets (confirm) | 原文随8个推进器说明定制接插件，未另列采购数量；不能假定计数单位。 | Connectors are specified with the eight thrusters, but no separate purchase count/unit is stated. | 三相线插头；对应插座要求15A、20cm舱内线；各路配对和包装单位需展开。 | Motor-phase plugs; mating receptacles are specified at 15 A with 20 cm internal leads. Expand the mating pairs and supplier package units. | 数量或规格缺失 | Quantity or specification missing |  | pro-making | https://iwin-fins.feishu.cn/wiki/RfVuwKMnqisR3rkWaFmcW6bOnVh
v4-pro-pressure-connectors | V4-pro | 连接器与线材 | Connectors and cabling | 水压计00W 4芯水密接插件 | Pressure-sensor 00W four-pin watertight connectors |  | 组（待核对） | sets (confirm) | 与4个水压计配套，原文未单列接插件采购数量。 | Specified with the four sensors; no separate connector purchase quantity is listed. | 插头1红/2黑/3绿SCL/4白SDA；插座20cm舱内线，传感器侧70cm。 | Plug pin 1 red/2 black/3 green SCL/4 white SDA; 20 cm internal receptacle leads and 70 cm sensor-side leads. | 数量或规格缺失 | Quantity or specification missing |  | pro-making | https://iwin-fins.feishu.cn/wiki/RfVuwKMnqisR3rkWaFmcW6bOnVh
v4-pro-light-connectors | V4-pro | 连接器与线材 | Connectors and cabling | 补光灯1W 3芯水密接插件 | Fill-light 1W three-pin watertight connectors |  | 组（待核对） | sets (confirm) | 与2个灯配套，原文未单列接插件采购数量。 | Specified with the two lights; no separate connector purchase quantity is listed. | 1红/2黑/3黄PWM；插座3A、20cm舱内线，设备侧60cm。 | Pin 1 red/2 black/3 yellow PWM; receptacle specified at 3 A with 20 cm internal leads and 60 cm device-side leads. | 数量或规格缺失 | Quantity or specification missing |  | pro-making | https://iwin-fins.feishu.cn/wiki/RfVuwKMnqisR3rkWaFmcW6bOnVh
v4-pro-servo-connectors | V4-pro | 连接器与线材 | Connectors and cabling | 舵机1W 3芯水密接插件 | Servo 1W three-pin watertight connectors |  | 组（待核对） | sets (confirm) | 与2个舵机配套，原文未单列接插件采购数量。 | Specified with the two servos; no separate connector purchase quantity is listed. | 1红/2黑/3黄PWM；插座2A、20cm舱内线，设备侧75cm。 | Pin 1 red/2 black/3 yellow PWM; receptacle specified at 2 A with 20 cm internal leads and 75 cm device-side leads. | 数量或规格缺失 | Quantity or specification missing |  | pro-making | https://iwin-fins.feishu.cn/wiki/RfVuwKMnqisR3rkWaFmcW6bOnVh
v4-pro-uart-harness | V4-pro | 连接器与线材 | Connectors and cabling | Jetson–RM-A UART连接线 | Jetson-to-RM-A UART harness |  | 条 | cables | 原文未给出可确认的数量；不等于0。 | No confirmed quantity is given in the source; this does not mean zero. | GH1.25 4pin线去除5V，仅GND共地、TX↔RX；/dev/ttyTHS1对接UART3，按具体载板核对。 | GH1.25 four-pin lead with the 5 V wire removed: common GND and crossed TX/RX. The documented /dev/ttyTHS1 connects to UART3; confirm the carrier revision. | 数量或规格缺失 | Quantity or specification missing |  | orin-setup | https://iwin-fins.feishu.cn/docx/S8I9dBMNmo2dIPxhWzkcyeQsnoP
v4-pro-camera-penetrator | V4-pro | 连接器与线材 | Connectors and cabling | 相机穿舱件 | Camera cable penetrator |  | 件 | pcs | 原文未给出可确认的数量；不等于0。 | No confirmed quantity is given in the source; this does not mean zero. | 内部装配要求制作相机穿线螺丝；按相机电缆外径和密封方案核对。 | The internal assembly instructions call for a camera cable penetrator; match the cable diameter and sealing design. | 数量或规格缺失 | Quantity or specification missing |  | pro-making | https://iwin-fins.feishu.cn/wiki/RfVuwKMnqisR3rkWaFmcW6bOnVh
v4-pro-ethernet-cable | V4-pro | 连接器与线材 | Connectors and cabling | 以太网/载波连接线 | Ethernet/power-line connection cables |  | 条 | cables | 原文未给出可确认的数量；不等于0。 | No confirmed quantity is given in the source; this does not mean zero. | Orin与PC调试先直连网线，整机另有载波模块；线长与端接未给统一规格。 | The Orin/PC setup uses a direct Ethernet cable for initial checks and paired power-line modules in the vehicle. No consolidated length/termination specification is given. | 数量或规格缺失 | Quantity or specification missing |  | pro-making; orin-setup | https://iwin-fins.feishu.cn/wiki/RfVuwKMnqisR3rkWaFmcW6bOnVh; https://iwin-fins.feishu.cn/docx/S8I9dBMNmo2dIPxhWzkcyeQsnoP
v4-pro-side-support | V4-pro | 结构与加工件 | Mechanical and machined parts | 侧支撑 | Side support | 2 | 件 | pcs |  |  | 主体/侧支撑.STEP与DWG。 材料、公差与表面处理按对应工程图。 | 主体/侧支撑.STEP and DWG. Use the corresponding drawings for material, tolerance and finish. | 原文列明，采购前核对 | Listed in source; verify before purchase |  | pro-making; pro-cad | https://iwin-fins.feishu.cn/wiki/RfVuwKMnqisR3rkWaFmcW6bOnVh; https://github.com/FPJ-GAOGE/V4-Underwater-Robot/tree/main/hardware/v4-pro
v4-pro-bottom-support | V4-pro | 结构与加工件 | Mechanical and machined parts | 底支撑2 | Bottom support 2 | 2 | 件 | pcs |  |  | 原清单称底支撑，文件名底支撑2。 材料、公差与表面处理按对应工程图。 | Called bottom support in the list; the filename is 底支撑2. Use the corresponding drawings for material, tolerance and finish. | 原文列明，采购前核对 | Listed in source; verify before purchase |  | pro-making; pro-cad | https://iwin-fins.feishu.cn/wiki/RfVuwKMnqisR3rkWaFmcW6bOnVh; https://github.com/FPJ-GAOGE/V4-Underwater-Robot/tree/main/hardware/v4-pro
v4-pro-upper-thruster-support | V4-pro | 结构与加工件 | Mechanical and machined parts | 上推进器支撑 | Upper thruster support | 2 | 件 | pcs |  |  | 主体/上推进器支撑.STEP与DWG。 材料、公差与表面处理按对应工程图。 | 主体/上推进器支撑.STEP and DWG. Use the corresponding drawings for material, tolerance and finish. | 原文列明，采购前核对 | Listed in source; verify before purchase |  | pro-making; pro-cad | https://iwin-fins.feishu.cn/wiki/RfVuwKMnqisR3rkWaFmcW6bOnVh; https://github.com/FPJ-GAOGE/V4-Underwater-Robot/tree/main/hardware/v4-pro
v4-pro-front-gimbal-base | V4-pro | 结构与加工件 | Mechanical and machined parts | 前云台底座 | Front gimbal base | 1 | 件 | pcs |  |  | CAD对应相机云台/前云台底架。 材料、公差与表面处理按对应工程图。 | The matching CAD part is 相机云台/前云台底架. Use the corresponding drawings for material, tolerance and finish. | 原文列明，采购前核对 | Listed in source; verify before purchase |  | pro-making; pro-cad | https://iwin-fins.feishu.cn/wiki/RfVuwKMnqisR3rkWaFmcW6bOnVh; https://github.com/FPJ-GAOGE/V4-Underwater-Robot/tree/main/hardware/v4-pro
v4-pro-rear-endcap | V4-pro | 结构与加工件 | Mechanical and machined parts | 后舱盖 | Rear end cap | 1 | 件 | pcs |  |  | CAD对应密封舱/后舱盖165；连接器孔与螺纹按工程图。 材料、公差与表面处理按对应工程图。 | The matching CAD part is 密封舱/后舱盖165; use the drawings for connector holes and threads. Use the corresponding drawings for material, tolerance and finish. | 原文列明，采购前核对 | Listed in source; verify before purchase |  | pro-making; pro-cad | https://iwin-fins.feishu.cn/wiki/RfVuwKMnqisR3rkWaFmcW6bOnVh; https://github.com/FPJ-GAOGE/V4-Underwater-Robot/tree/main/hardware/v4-pro
v4-pro-acrylic-tube | V4-pro | 结构与加工件 | Mechanical and machined parts | 亚克力管 | Acrylic tube |  | 件 | pcs | 原文未给出可确认的数量；不等于0。 | No confirmed quantity is given in the source; this does not mean zero. | 原采购文列亚克力管及附属固定件，未给数量/尺寸/耐压等级。 | The purchasing text lists an acrylic tube and associated mounts, without quantity, dimensions or pressure rating. | 数量或规格缺失 | Quantity or specification missing |  | pro-making | https://iwin-fins.feishu.cn/wiki/RfVuwKMnqisR3rkWaFmcW6bOnVh
v4-pro-housing-fixings | V4-pro | 结构与加工件 | Mechanical and machined parts | 舱体密封圈/法兰/固定件 | Enclosure seals/flanges/mounts |  | 组（待展开） | assembly (breakdown required) | 原文未给出可确认的数量；不等于0。 | No confirmed quantity is given in the source; this does not mean zero. | 按完整装配体和配套舱体展开；原文未给完整独立零件数量。 | Expand from the full assembly and selected enclosure; the source does not provide a complete per-part count. | 数量或规格缺失 | Quantity or specification missing |  | pro-making; pro-cad | https://iwin-fins.feishu.cn/wiki/RfVuwKMnqisR3rkWaFmcW6bOnVh; https://github.com/FPJ-GAOGE/V4-Underwater-Robot/tree/main/hardware/v4-pro
v4-pro-upper-tray | V4-pro | 打印件与内部支撑 | Printed parts and internal supports | 上层板架 | Upper electronics tray | 1 | 件 | pcs |  |  | 按V4pro模型3D打印；材料、层高、填充率未给统一参数。 | 3D print from the V4pro model; no unified material, layer-height or infill settings are supplied. | 原文列明，采购前核对 | Listed in source; verify before purchase |  | pro-making; pro-cad | https://iwin-fins.feishu.cn/wiki/RfVuwKMnqisR3rkWaFmcW6bOnVh; https://github.com/FPJ-GAOGE/V4-Underwater-Robot/tree/main/hardware/v4-pro
v4-pro-lower-tray | V4-pro | 打印件与内部支撑 | Printed parts and internal supports | 下层板架 | Lower electronics tray | 1 | 件 | pcs |  |  | 按V4pro模型3D打印；材料、层高、填充率未给统一参数。 | 3D print from the V4pro model; no unified material, layer-height or infill settings are supplied. | 原文列明，采购前核对 | Listed in source; verify before purchase |  | pro-making; pro-cad | https://iwin-fins.feishu.cn/wiki/RfVuwKMnqisR3rkWaFmcW6bOnVh; https://github.com/FPJ-GAOGE/V4-Underwater-Robot/tree/main/hardware/v4-pro
v4-pro-pressure-mount | V4-pro | 打印件与内部支撑 | Printed parts and internal supports | 水压计固定件 | Pressure-sensor mount | 4 | 件 | pcs |  |  | 按V4pro模型3D打印；材料、层高、填充率未给统一参数。 | 3D print from the V4pro model; no unified material, layer-height or infill settings are supplied. | 原文列明，采购前核对 | Listed in source; verify before purchase |  | pro-making; pro-cad | https://iwin-fins.feishu.cn/wiki/RfVuwKMnqisR3rkWaFmcW6bOnVh; https://github.com/FPJ-GAOGE/V4-Underwater-Robot/tree/main/hardware/v4-pro
v4-pro-light-mount | V4-pro | 打印件与内部支撑 | Printed parts and internal supports | 补光灯固定件 | Fill-light mount | 2 | 件 | pcs |  |  | 按V4pro模型3D打印；材料、层高、填充率未给统一参数。 | 3D print from the V4pro model; no unified material, layer-height or infill settings are supplied. | 原文列明，采购前核对 | Listed in source; verify before purchase |  | pro-making; pro-cad | https://iwin-fins.feishu.cn/wiki/RfVuwKMnqisR3rkWaFmcW6bOnVh; https://github.com/FPJ-GAOGE/V4-Underwater-Robot/tree/main/hardware/v4-pro
v4-pro-heat-set-inserts | V4-pro | 紧固件与装配材料 | Fasteners and assembly materials | M3/M4预埋螺母 | M3/M4 heat-set inserts |  | 件 | pcs | 原文未给出可确认的数量；不等于0。 | No confirmed quantity is given in the source; this does not mean zero. | 按上下板架模型区分M3/M4孔位；不能使用V4的M2.5/M3说明代替。 | Select M3/M4 positions from the upper/lower tray models; do not substitute the V4 M2.5/M3 instructions. | 数量或规格缺失 | Quantity or specification missing |  | pro-making | https://iwin-fins.feishu.cn/wiki/RfVuwKMnqisR3rkWaFmcW6bOnVh
v4-pro-fasteners | V4-pro | 紧固件与装配材料 | Fasteners and assembly materials | 框架与板架螺钉 | Frame and electronics-mount screws |  | 件 | pcs | 原文未给出可确认的数量；不等于0。 | No confirmed quantity is given in the source; this does not mean zero. | 侧支撑要求平头螺丝；具体螺纹、长度和数量按装配体/工程图展开。 | Flat-head screws are specified for side supports; derive threads, lengths and quantities from the assembly/drawings. | 数量或规格缺失 | Quantity or specification missing |  | pro-making; pro-cad | https://iwin-fins.feishu.cn/wiki/RfVuwKMnqisR3rkWaFmcW6bOnVh; https://github.com/FPJ-GAOGE/V4-Underwater-Robot/tree/main/hardware/v4-pro
v4-pro-esc-capacitors | V4-pro | 紧固件与装配材料 | Fasteners and assembly materials | 电调配套电容 | ESC capacitors |  | 件 | pcs | 原文未给出可确认的数量；不等于0。 | No confirmed quantity is given in the source; this does not mean zero. | 内部焊接步骤明确电调焊线与电容，未给电容规格和数量。 | The internal soldering steps explicitly mention ESC wiring and capacitors, without capacitor ratings or quantities. | 数量或规格缺失 | Quantity or specification missing |  | pro-making | https://iwin-fins.feishu.cn/wiki/RfVuwKMnqisR3rkWaFmcW6bOnVh
v4-pro-power-harness | V4-pro | 紧固件与装配材料 | Fasteners and assembly materials | 动力/分电/开关线束 | Power/distribution/switch harnesses |  | 组（待展开） | sets (breakdown required) | 原文未给出可确认的数量；不等于0。 | No confirmed quantity is given in the source; this does not mean zero. | 用于电调、分电板、定制电池、旋钮开关和载波模块；线规、保护与长度须按实际负载确定。 | For ESCs, distribution board, custom battery, rotary switch and power-line modules; determine wire gauge, protection and lengths from actual loads. | 数量或规格缺失 | Quantity or specification missing |  | pro-making | https://iwin-fins.feishu.cn/wiki/RfVuwKMnqisR3rkWaFmcW6bOnVh
