FPJ-GAOGE/V4-Underwater-Robot/hardware/bom/V4-V4pro-BOM.xlsx

Sheet: V4 中文
V4 材料清单
资料整理日期：2026-10-22。空白数量表示原资料未明确，不等于零。
状态列区分历史替代方案、可选件和待确认项。历史清单不得与现行清单直接相加；商品链接不代表当前价格或在售状态。
条目 ID | 类别 | 元件 / 零件 | 数量 | 单位 | 规格及型号差异 | 数量依据 / 备注 | 状态 | 原商品记录 | 资料来源 | 来源链接
v4-thruster | 电子与执行器 | 推进器 | 8 | 件 | 原V4为电源正/负/PWM三线；线长按安装位置实测定制，不采用Pro三相线接法。 |  | 原文列明，采购前核对 | https://item.taobao.com/item.htm?id=591864716045 | V4配件清单 AUV电路连接设计及元件清单 | https://iwin-fins.feishu.cn/wiki/BQjFwY7GeiFW2KkmTXWcBC7fn8d https://iwin-fins.feishu.cn/wiki/R7XGwUqQZiNfqGkNGA8cCkj1nsh
v4-servo | 电子与执行器 | 舵机 | 2 | 件 | 旧电路表和V4-ly固件保留4路；按当前相机/机构实装数量确认。 | 配件表数量2；旧电路表数量4，不相加。 | 来源冲突，待实物确认 | https://item.taobao.com/item.htm?id=853148098562 | V4配件清单 AUV电路连接设计及元件清单 IWIN-FINS V4-ly固定提交42e5f16 | https://iwin-fins.feishu.cn/wiki/BQjFwY7GeiFW2KkmTXWcBC7fn8d https://iwin-fins.feishu.cn/wiki/R7XGwUqQZiNfqGkNGA8cCkj1nsh https://gitee.com/superkinkin/IWIN-FINS/tree/42e5f16f5b3ad3e23fceb5eb60868340b365dfd5/
v4-pressure-sensor | 电子与执行器 | 水深/水压传感器 | 4 | 件 | 配件表：不锈钢、10m选项；旧商品标题含MS5837-30BA。选项/实际型号须核对，10m不是整机潜深。 旧接线使用随附转接板，需核对是否包含在传感器供货中。 |  | 原文列明，采购前核对 | https://item.taobao.com/item.htm?id=605375059849 | V4配件清单 AUV电路连接设计及元件清单 | https://iwin-fins.feishu.cn/wiki/BQjFwY7GeiFW2KkmTXWcBC7fn8d https://iwin-fins.feishu.cn/wiki/R7XGwUqQZiNfqGkNGA8cCkj1nsh
v4-battery | 电子与执行器 | 4S电池 | 1 | 件 | XT60主电源接口；旧电路文档记10000mAh、25C，配件表只确认4S/XT60。 |  | 原文列明，采购前核对 | https://item.taobao.com/item.htm?id=609820541557 | V4配件清单 AUV电路连接设计及元件清单 | https://iwin-fins.feishu.cn/wiki/BQjFwY7GeiFW2KkmTXWcBC7fn8d https://iwin-fins.feishu.cn/wiki/R7XGwUqQZiNfqGkNGA8cCkj1nsh
v4-relay | 电子与执行器 | 继电器/电源开关模块 | 1 | 件 | 配件表写30A，旧电路文档写120A；原短链接不作为型号或额定电流证明。 |  | 来源冲突，待实物确认 |  | V4配件清单 AUV电路连接设计及元件清单 | https://iwin-fins.feishu.cn/wiki/BQjFwY7GeiFW2KkmTXWcBC7fn8d https://iwin-fins.feishu.cn/wiki/R7XGwUqQZiNfqGkNGA8cCkj1nsh
v4-rotary-switch | 电子与执行器 | 水下旋钮开关 | 1 | 件 | 主电源控制路径中的开关；按实际器件核对接口和触点能力。 |  | 原文列明，采购前核对 | https://item.taobao.com/item.htm?id=746272975983 | V4配件清单 AUV电路连接设计及元件清单 | https://iwin-fins.feishu.cn/wiki/BQjFwY7GeiFW2KkmTXWcBC7fn8d https://iwin-fins.feishu.cn/wiki/R7XGwUqQZiNfqGkNGA8cCkj1nsh
v4-buck-converter | 电子与执行器 | 降压模块 | 1 | 件 | 用于树莓派和机构支路；各负载电压/电流分别核对。 |  | 原文列明，采购前核对 | https://item.taobao.com/item.htm?id=856012812115 | V4配件清单 AUV电路连接设计及元件清单 | https://iwin-fins.feishu.cn/wiki/BQjFwY7GeiFW2KkmTXWcBC7fn8d https://iwin-fins.feishu.cn/wiki/R7XGwUqQZiNfqGkNGA8cCkj1nsh
v4-power-distribution | 电子与执行器 | 分电板 | 1 | 件 | 旧电路用于树莓派/舵机支路；正文也允许自制分线，不与其他分支方案重复采购。 | 数量1来自旧电路表；当前配件表未列。 | 历史替代项，不与当前清单累加 | https://item.taobao.com/item.htm?id=814381038913 | AUV电路连接设计及元件清单 | https://iwin-fins.feishu.cn/wiki/R7XGwUqQZiNfqGkNGA8cCkj1nsh
v4-raspberry-pi | 电子与执行器 | 树莓派4B | 1 | 件 | 舱内计算机；内存规格和存储介质未在配件表明确。 |  | 原文列明，采购前核对 | https://detail.tmall.com/item.htm?id=705995475782 | V4配件清单 AUV电路连接设计及元件清单 | https://iwin-fins.feishu.cn/wiki/BQjFwY7GeiFW2KkmTXWcBC7fn8d https://iwin-fins.feishu.cn/wiki/R7XGwUqQZiNfqGkNGA8cCkj1nsh
v4-controller | 电子与执行器 | RoboMaster C板 | 1 | 件 | 系统资料中的V4主控；固件工程目标为STM32F407IGHx，按实际板卡核对。 |  | 原文列明，采购前核对 | https://item.taobao.com/item.htm?id=611226266955 | V4配件清单 AUV电路连接设计及元件清单 IWIN-FINS V4-ly固定提交42e5f16 | https://iwin-fins.feishu.cn/wiki/BQjFwY7GeiFW2KkmTXWcBC7fn8d https://iwin-fins.feishu.cn/wiki/R7XGwUqQZiNfqGkNGA8cCkj1nsh https://gitee.com/superkinkin/IWIN-FINS/tree/42e5f16f5b3ad3e23fceb5eb60868340b365dfd5/
v4-h30-imu | 电子与执行器 | H30 IMU（源码依赖） |  | 件 | V4-ly姿态反馈来自H30，USART1 921600 8N1；启动还检查BMI088。实际H30采购型号与安装需补录。 | 原文未给出可确认的数量；不等于0。 | 数量或规格缺失 |  | IWIN-FINS V4-ly固定提交42e5f16 | https://gitee.com/superkinkin/IWIN-FINS/tree/42e5f16f5b3ad3e23fceb5eb60868340b365dfd5/
v4-pca9685 | 电子与执行器 | PCA9685 PWM扩展板 | 1 | 件 | 推进器使用通道0–7；固件舵机预留通道8–11，逻辑VCC与V+负载电源区分。 |  | 原文列明，采购前核对 | https://detail.tmall.com/item.htm?id=624960039615 | V4配件清单 AUV电路连接设计及元件清单 IWIN-FINS V4-ly固定提交42e5f16 | https://iwin-fins.feishu.cn/wiki/BQjFwY7GeiFW2KkmTXWcBC7fn8d https://iwin-fins.feishu.cn/wiki/R7XGwUqQZiNfqGkNGA8cCkj1nsh https://gitee.com/superkinkin/IWIN-FINS/tree/42e5f16f5b3ad3e23fceb5eb60868340b365dfd5/
v4-i2c-expander | 电子与执行器 | I2C扩展板 | 1 | 件 | 固件为TCA9548A；0–3通道接压力传感器，4通道接PCA9685。 |  | 原文列明，采购前核对 | https://item.taobao.com/item.htm?id=612860784973 | V4配件清单 AUV电路连接设计及元件清单 IWIN-FINS V4-ly固定提交42e5f16 | https://iwin-fins.feishu.cn/wiki/BQjFwY7GeiFW2KkmTXWcBC7fn8d https://iwin-fins.feishu.cn/wiki/R7XGwUqQZiNfqGkNGA8cCkj1nsh https://gitee.com/superkinkin/IWIN-FINS/tree/42e5f16f5b3ad3e23fceb5eb60868340b365dfd5/
v4-camera | 电子与执行器 | 相机 | 1 | 件 | 完整设计含双目方案，后有2025-07-10单目支架更新；按所选支架与接口确认。 |  | 原文列明，采购前核对 | https://item.taobao.com/item.htm?id=793615736142 | V4配件清单 比赛细节与V4设计（含结构设计表） | https://iwin-fins.feishu.cn/wiki/BQjFwY7GeiFW2KkmTXWcBC7fn8d https://iwin-fins.feishu.cn/wiki/Ty7WwhJmCihi7qk3Gx8cAL93n8f
v4-wireless-debugger | 电子与执行器 | 无线调试/烧写器 | 1 | 件 | 按实际SWD接口与工具支持情况核对。 |  | 原文列明，采购前核对 | https://item.taobao.com/item.htm?id=745548099223 | V4配件清单 | https://iwin-fins.feishu.cn/wiki/BQjFwY7GeiFW2KkmTXWcBC7fn8d
v4-usb-ttl | 历史接线替代项 | USB转TTL模块 | 1 | 件 | 旧电路的可选UART连接方法；与直接GPIO UART方案区分。 | 数量1来自旧电路表；当前配件表未列。 | 历史替代项，不与当前清单累加 |  | AUV电路连接设计及元件清单 | https://iwin-fins.feishu.cn/wiki/R7XGwUqQZiNfqGkNGA8cCkj1nsh
v4-servo-thruster-connectors | 连接器与线材 | 舵机/推进器水密接插件 | 12 | 组 | 3芯母座+公缆；先确定设备位置和线长，再交由厂家定制。 | 原表记12，未写包装单位；按配对说明暂列组，须核对。旧8推进器+4舵机与当前舵机2的差异勿忽略。 | 来源冲突，待实物确认 | https://item.taobao.com/item.htm?id=811948973422 | V4配件清单 | https://iwin-fins.feishu.cn/wiki/BQjFwY7GeiFW2KkmTXWcBC7fn8d
v4-connector-caps | 连接器与线材 | 3芯公堵头 | 2 | 件 | 用于未使用的舵机/推进器接口，与母座配套。 |  | 原文列明，采购前核对 | https://item.taobao.com/item.htm?id=811948973422 | V4配件清单 | https://iwin-fins.feishu.cn/wiki/BQjFwY7GeiFW2KkmTXWcBC7fn8d
v4-pressure-sleeves | 连接器与线材 | 水压计外置套管 | 4 | 件 | 用于传感器线缆延长和灌封；密封工艺按所购材料说明。 |  | 原文列明，采购前核对 | https://item.taobao.com/item.htm?id=781752613399 | V4配件清单 比赛细节与V4设计（含结构设计表） | https://iwin-fins.feishu.cn/wiki/BQjFwY7GeiFW2KkmTXWcBC7fn8d https://iwin-fins.feishu.cn/wiki/Ty7WwhJmCihi7qk3Gx8cAL93n8f
v4-pressure-connectors | 连接器与线材 | 水压计水密接插件 | 4 | 组 | 定制00W 4芯插头+插座；厂家4芯电缆65cm。 | 原表数量4；配对件以组列出，商品包装单位待确认。 | 原文列明，采购前核对 | https://item.taobao.com/item.htm?id=619481441943 | V4配件清单 | https://iwin-fins.feishu.cn/wiki/BQjFwY7GeiFW2KkmTXWcBC7fn8d
v4-ethernet-tether | 连接器与线材 | 零浮力网线 | 100 | 米 | 原表数量栏写“零浮力网线，100m”；端接、外径、芯数与长度定义需和接插件确认。 | 100为原表长度记录，不是100条电缆；是否对应单台需求待确认。 | 原文列明，采购前核对 |  | V4配件清单 | https://iwin-fins.feishu.cn/wiki/BQjFwY7GeiFW2KkmTXWcBC7fn8d
v4-tether-connector | 连接器与线材 | 电缆接插件 | 1 | 件 | 1W 8芯插头；配对插座与端接方案未完整列出。 |  | 原文列明，采购前核对 |  | V4配件清单 | https://iwin-fins.feishu.cn/wiki/BQjFwY7GeiFW2KkmTXWcBC7fn8d
v4-camera-connector | 连接器与线材 | 相机接插件 |  | 件 | 1W 4芯插头；按实际相机和穿舱方案核对。 | 原文未给出可确认的数量；不等于0。 | 数量或规格缺失 |  | V4配件清单 | https://iwin-fins.feishu.cn/wiki/BQjFwY7GeiFW2KkmTXWcBC7fn8d
v4-terminal-20p | 连接器与线材 | H3800 20P接线端子 | 2 | 件 | 按当前板架孔位与线束表配套。 |  | 原文列明，采购前核对 | https://item.taobao.com/item.htm?id=661948958655 | V4配件清单 | https://iwin-fins.feishu.cn/wiki/BQjFwY7GeiFW2KkmTXWcBC7fn8d
v4-terminal-16p | 连接器与线材 | H3803 16P接线端子 | 2 | 件 | 按动力/支路线束和实物端子规格核对。 |  | 原文列明，采购前核对 | https://item.taobao.com/item.htm?id=551775262138 | V4配件清单 | https://iwin-fins.feishu.cn/wiki/BQjFwY7GeiFW2KkmTXWcBC7fn8d
v4-terminal-6p | 连接器与线材 | H3800 6P接线端子 | 2 | 件 | 旧电路正文另有6针/7针布局；不与历史端子行累加。 |  | 原文列明，采购前核对 | https://item.taobao.com/item.htm?id=661948958655 | V4配件清单 AUV电路连接设计及元件清单 | https://iwin-fins.feishu.cn/wiki/BQjFwY7GeiFW2KkmTXWcBC7fn8d https://iwin-fins.feishu.cn/wiki/R7XGwUqQZiNfqGkNGA8cCkj1nsh
v4-bridge-3-5mm | 连接器与线材 | 3.5mm 10P短接件 | 2 | 件 | FBS10-3.5，红色，黄铜；与端子系列匹配。 |  | 原文列明，采购前核对 | https://detail.tmall.com/item.htm?id=622709470719 | V4配件清单 | https://iwin-fins.feishu.cn/wiki/BQjFwY7GeiFW2KkmTXWcBC7fn8d
v4-bridge-6-2mm | 连接器与线材 | 6.2mm 10P短接件 | 2 | 件 | 10P EB连接件；与端子系列匹配。 |  | 原文列明，采购前核对 | https://item.taobao.com/item.htm?id=551775262138 | V4配件清单 | https://iwin-fins.feishu.cn/wiki/BQjFwY7GeiFW2KkmTXWcBC7fn8d
v4-usb-c-power-cable | 连接器与线材 | 树莓派Type-C供电线 | 1 | 件 | 原表记录双左右弯头；按供电电流和安装空间核对。 |  | 原文列明，采购前核对 | https://detail.tmall.com/item.htm?id=739417974339 | V4配件清单 | https://iwin-fins.feishu.cn/wiki/BQjFwY7GeiFW2KkmTXWcBC7fn8d
v4-historical-6pin-large | 历史接线替代项 | 旧方案大6针座 | 4 | 件 | 旧电路用于推进器，每路为正/负/信号三线。 |  | 历史替代项，不与当前清单累加 |  | AUV电路连接设计及元件清单 | https://iwin-fins.feishu.cn/wiki/R7XGwUqQZiNfqGkNGA8cCkj1nsh
v4-historical-6pin-small | 历史接线替代项 | 旧方案小6针座 | 2 | 件 | 旧电路用于舵机；与当前H3800等布局不叠加。 |  | 历史替代项，不与当前清单累加 |  | AUV电路连接设计及元件清单 | https://iwin-fins.feishu.cn/wiki/R7XGwUqQZiNfqGkNGA8cCkj1nsh
v4-historical-7pin-small | 历史接线替代项 | 旧方案小7针座 |  | 件 | UART三线+SWD四线；原正文没有明确数量。 | 原文未给出可确认的数量；不等于0。 | 历史替代项，不与当前清单累加 |  | AUV电路连接设计及元件清单 | https://iwin-fins.feishu.cn/wiki/R7XGwUqQZiNfqGkNGA8cCkj1nsh
v4-historical-stlink | 历史接线替代项 | ST-Link调试器（旧接法） |  | 件 | 旧接线步骤提及ST-Link；与无线调试器属不同调试方案，不默认同时采购。 | 原文未给出可确认的数量；不等于0。 | 历史替代项，不与当前清单累加 |  | AUV电路连接设计及元件清单 | https://iwin-fins.feishu.cn/wiki/R7XGwUqQZiNfqGkNGA8cCkj1nsh
v4-switch-extension-wire | 紧固件与装配材料 | 24AWG开关延长线 |  | 米 | 旧电路只在需要延长旋钮开关线时指定24AWG，未给总长度。 | 原文未给出可确认的数量；不等于0。 | 数量或规格缺失 |  | AUV电路连接设计及元件清单 | https://iwin-fins.feishu.cn/wiki/R7XGwUqQZiNfqGkNGA8cCkj1nsh
v4-power-y-harness | 紧固件与装配材料 | XT60与电源分支线束 |  | 组 | 旧接线描述Y形分支与XT60连接；使用完成并核验的线束，不将旧改线操作当产品规格。 | 原文未给出可确认的数量；不等于0。 | 数量或规格缺失 |  | AUV电路连接设计及元件清单 | https://iwin-fins.feishu.cn/wiki/R7XGwUqQZiNfqGkNGA8cCkj1nsh
v4-side-support | 结构与加工件 | 侧支撑 |  | 件 | 主体/侧支撑.STEP；同时提供DWG。 V4铝合金加工说明为黑色阳极氧化、哑光；具体材料及公差以工程图为准。 | CAD存在该零件，未从装配体确认实例数；不套用Pro数量。 | 数量或规格缺失 |  | 比赛细节与V4设计（含结构设计表） V4 2025-05-23中性CAD及后续可选机构资料 | https://iwin-fins.feishu.cn/wiki/Ty7WwhJmCihi7qk3Gx8cAL93n8f https://github.com/FPJ-GAOGE/V4-Underwater-Robot/tree/main/hardware/v4
v4-bottom-support | 结构与加工件 | 底支撑2 |  | 件 | 主体/底支撑2.STEP；同时提供DWG。 V4铝合金加工说明为黑色阳极氧化、哑光；具体材料及公差以工程图为准。 | CAD存在该零件，未从装配体确认实例数；不套用Pro数量。 | 数量或规格缺失 |  | 比赛细节与V4设计（含结构设计表） V4 2025-05-23中性CAD及后续可选机构资料 | https://iwin-fins.feishu.cn/wiki/Ty7WwhJmCihi7qk3Gx8cAL93n8f https://github.com/FPJ-GAOGE/V4-Underwater-Robot/tree/main/hardware/v4
v4-upper-thruster-support | 结构与加工件 | 上推进器支撑 |  | 件 | 主体/上推进器支撑.STEP；同时提供DWG。 V4铝合金加工说明为黑色阳极氧化、哑光；具体材料及公差以工程图为准。 | CAD存在该零件，未从装配体确认实例数；不套用Pro数量。 | 数量或规格缺失 |  | 比赛细节与V4设计（含结构设计表） V4 2025-05-23中性CAD及后续可选机构资料 | https://iwin-fins.feishu.cn/wiki/Ty7WwhJmCihi7qk3Gx8cAL93n8f https://github.com/FPJ-GAOGE/V4-Underwater-Robot/tree/main/hardware/v4
v4-corner-piece | 结构与加工件 | 角件 |  | 件 | 主体/角件.STEP。 V4铝合金加工说明为黑色阳极氧化、哑光；具体材料及公差以工程图为准。 | CAD存在该零件，未从装配体确认实例数；不套用Pro数量。 | 数量或规格缺失 |  | 比赛细节与V4设计（含结构设计表） V4 2025-05-23中性CAD及后续可选机构资料 | https://iwin-fins.feishu.cn/wiki/Ty7WwhJmCihi7qk3Gx8cAL93n8f https://github.com/FPJ-GAOGE/V4-Underwater-Robot/tree/main/hardware/v4
v4-rear-endcap | 结构与加工件 | 后舱盖165 |  | 件 | 密封舱/后舱盖165.STEP；同时提供DWG。 V4铝合金加工说明为黑色阳极氧化、哑光；具体材料及公差以工程图为准。 | CAD存在该零件，未从装配体确认实例数；不套用Pro数量。 | 数量或规格缺失 |  | 比赛细节与V4设计（含结构设计表） V4 2025-05-23中性CAD及后续可选机构资料 | https://iwin-fins.feishu.cn/wiki/Ty7WwhJmCihi7qk3Gx8cAL93n8f https://github.com/FPJ-GAOGE/V4-Underwater-Robot/tree/main/hardware/v4
v4-gimbal-base | 结构与加工件 | 云台底架 |  | 件 | 相机云台/云台底架.STEP；同时提供DWG。 V4铝合金加工说明为黑色阳极氧化、哑光；具体材料及公差以工程图为准。 | CAD存在该零件，未从装配体确认实例数；不套用Pro数量。 | 数量或规格缺失 |  | 比赛细节与V4设计（含结构设计表） V4 2025-05-23中性CAD及后续可选机构资料 | https://iwin-fins.feishu.cn/wiki/Ty7WwhJmCihi7qk3Gx8cAL93n8f https://github.com/FPJ-GAOGE/V4-Underwater-Robot/tree/main/hardware/v4
v4-rear-gimbal-base | 结构与加工件 | 后云台底架 |  | 件 | 相机云台/后云台底架.STEP；同时提供DWG。 V4铝合金加工说明为黑色阳极氧化、哑光；具体材料及公差以工程图为准。 | CAD存在该零件，未从装配体确认实例数；不套用Pro数量。 | 数量或规格缺失 |  | 比赛细节与V4设计（含结构设计表） V4 2025-05-23中性CAD及后续可选机构资料 | https://iwin-fins.feishu.cn/wiki/Ty7WwhJmCihi7qk3Gx8cAL93n8f https://github.com/FPJ-GAOGE/V4-Underwater-Robot/tree/main/hardware/v4
v4-sensor-sleeve-mount | 结构与加工件 | 外置套管固定加工件 |  | 件 | 水深传感器/外置套管固定加工版.STEP。 V4铝合金加工说明为黑色阳极氧化、哑光；具体材料及公差以工程图为准。 | CAD存在该零件，未从装配体确认实例数；不套用Pro数量。 | 数量或规格缺失 |  | 比赛细节与V4设计（含结构设计表） V4 2025-05-23中性CAD及后续可选机构资料 | https://iwin-fins.feishu.cn/wiki/Ty7WwhJmCihi7qk3Gx8cAL93n8f https://github.com/FPJ-GAOGE/V4-Underwater-Robot/tree/main/hardware/v4
v4-upper-electronics-tray | 打印件与内部支撑 | 上层架板 |  | 件 | 对应CAD：密封舱/舱内/上层架板.STEP；加工方式、材料和数量按所选装配确认，不能仅凭文件存在推断。 | 原文未给出可确认的数量；不等于0。 | 数量或规格缺失 |  | V4 2025-05-23中性CAD及后续可选机构资料 | https://github.com/FPJ-GAOGE/V4-Underwater-Robot/tree/main/hardware/v4
v4-lower-electronics-tray | 打印件与内部支撑 | 下层架板 |  | 件 | 对应CAD：密封舱/舱内/下层架板.STEP；加工方式、材料和数量按所选装配确认，不能仅凭文件存在推断。 | 原文未给出可确认的数量；不等于0。 | 数量或规格缺失 |  | V4 2025-05-23中性CAD及后续可选机构资料 | https://github.com/FPJ-GAOGE/V4-Underwater-Robot/tree/main/hardware/v4
v4-battery-tray | 打印件与内部支撑 | 电池架 |  | 件 | 对应CAD：密封舱/舱内/电池架.STEP；加工方式、材料和数量按所选装配确认，不能仅凭文件存在推断。 | 原文未给出可确认的数量；不等于0。 | 数量或规格缺失 |  | V4 2025-05-23中性CAD及后续可选机构资料 | https://github.com/FPJ-GAOGE/V4-Underwater-Robot/tree/main/hardware/v4
v4-camera-link | 打印件与内部支撑 | 相机连接件 |  | 件 | 对应CAD：相机云台/相机连接件.STEP；加工方式、材料和数量按所选装配确认，不能仅凭文件存在推断。 | 原文未给出可确认的数量；不等于0。 | 数量或规格缺失 |  | V4 2025-05-23中性CAD及后续可选机构资料 | https://github.com/FPJ-GAOGE/V4-Underwater-Robot/tree/main/hardware/v4
v4-servo-link | 打印件与内部支撑 | 舵机连接件 |  | 件 | 对应CAD：相机云台/舵机连接件.STEP；加工方式、材料和数量按所选装配确认，不能仅凭文件存在推断。 | 原文未给出可确认的数量；不等于0。 | 数量或规格缺失 |  | V4 2025-05-23中性CAD及后续可选机构资料 | https://github.com/FPJ-GAOGE/V4-Underwater-Robot/tree/main/hardware/v4
v4-buoyancy-shell | 打印件与内部支撑 | 浮力外壳2 |  | 件 | 对应CAD：浮力外壳/浮力外壳2.STEP；加工方式、材料和数量按所选装配确认，不能仅凭文件存在推断。 | 原文未给出可确认的数量；不等于0。 | 数量或规格缺失 |  | V4 2025-05-23中性CAD及后续可选机构资料 | https://github.com/FPJ-GAOGE/V4-Underwater-Robot/tree/main/hardware/v4
v4-sealed-housing | 结构与加工件 | 密封舱及配套密封/固定件 |  | 组（待展开） | 制造步骤提及密封舱与后舱盖；未给出完整舱体/密封件采购展开和额定潜深。 | 原文未给出可确认的数量；不等于0。 | 数量或规格缺失 |  | 比赛细节与V4设计（含结构设计表） | https://iwin-fins.feishu.cn/wiki/Ty7WwhJmCihi7qk3Gx8cAL93n8f
v4-heat-set-inserts | 紧固件与装配材料 | M2.5/M3预埋螺母 |  | 件 | 树莓派、PWM扩展板相关位置用M2.5，其他指定位置M3；并非每个孔都装。 | 原文未给出可确认的数量；不等于0。 | 数量或规格缺失 |  | 比赛细节与V4设计（含结构设计表） | https://iwin-fins.feishu.cn/wiki/Ty7WwhJmCihi7qk3Gx8cAL93n8f
v4-nylon-standoffs | 紧固件与装配材料 | M2.5/M3尼龙柱 |  | 件 | 树莓派/PWM板M2.5，其余指定位置M3；C板和端子不使用同样支柱。 | 原文未给出可确认的数量；不等于0。 | 数量或规格缺失 |  | 比赛细节与V4设计（含结构设计表） | https://iwin-fins.feishu.cn/wiki/Ty7WwhJmCihi7qk3Gx8cAL93n8f
v4-fasteners | 紧固件与装配材料 | 框架与板架紧固件 |  | 件 | 按2025-05-23装配与螺纹工程图展开，原文无统一规格/数量表。 | 原文未给出可确认的数量；不等于0。 | 数量或规格缺失 |  | 比赛细节与V4设计（含结构设计表） V4 2025-05-23中性CAD及后续可选机构资料 | https://iwin-fins.feishu.cn/wiki/Ty7WwhJmCihi7qk3Gx8cAL93n8f https://github.com/FPJ-GAOGE/V4-Underwater-Robot/tree/main/hardware/v4
v4-potting-material | 紧固件与装配材料 | 环氧灌封与绝缘材料 |  | 用量待定 | 原文要求焊后环氧灌封，旧电气文档要求封住未使用分电点；配比/用量未给。 | 原文未给出可确认的数量；不等于0。 | 数量或规格缺失 |  | 比赛细节与V4设计（含结构设计表） AUV电路连接设计及元件清单 | https://iwin-fins.feishu.cn/wiki/Ty7WwhJmCihi7qk3Gx8cAL93n8f https://iwin-fins.feishu.cn/wiki/R7XGwUqQZiNfqGkNGA8cCkj1nsh
v4-monocular-mount-update | 可选机构与后续更新 | 2025-07-10单目相机支架更新 |  | 组（待展开） | 独立的相机支架1/2两份SLDPRT，不代表每台各采购1件；按所选机构确认。 | 原文未给出可确认的数量；不等于0。 | 可选设计资料，非默认装配 |  | 比赛细节与V4设计（含结构设计表） V4 2025-05-23中性CAD及后续可选机构资料 | https://iwin-fins.feishu.cn/wiki/Ty7WwhJmCihi7qk3Gx8cAL93n8f https://github.com/FPJ-GAOGE/V4-Underwater-Robot/tree/main/hardware/v4
v4-gripper-design | 可选机构与后续更新 | 机械爪设计附加包 |  | 组（待展开） | 含主动/从动齿轮、圆法兰、夹手、拉杆、基座和顶盖模型；实例数及与主机集成未确认。 | 原文未给出可确认的数量；不等于0。 | 可选设计资料，非默认装配 |  | 比赛细节与V4设计（含结构设计表） V4 2025-05-23中性CAD及后续可选机构资料 | https://iwin-fins.feishu.cn/wiki/Ty7WwhJmCihi7qk3Gx8cAL93n8f https://github.com/FPJ-GAOGE/V4-Underwater-Robot/tree/main/hardware/v4

Sheet: V4 English
V4 Bill of materials
Source snapshot: 2026-10-22. Blank quantities mean unspecified in the source, not zero.
Use Status to distinguish historical alternatives, optional parts, and unresolved items. Do not add historical alternatives to the current list. Supplier links do not establish current prices or availability.
Item ID | Category | Component / Part | Qty | Unit | Specifications and variant details | Quantity basis / Notes | Status | Original supplier link | Sources | Source URLs
v4-thruster | Electronics and actuators | Thruster | 8 | pcs | The original V4 uses power-positive, power-negative and PWM wires. Measure cable lengths on the selected frame; do not use the Pro three-phase wiring scheme. |  | Listed in source; verify before purchase | https://item.taobao.com/item.htm?id=591864716045 | V4 parts list AUV electrical connections and component list | https://iwin-fins.feishu.cn/wiki/BQjFwY7GeiFW2KkmTXWcBC7fn8d https://iwin-fins.feishu.cn/wiki/R7XGwUqQZiNfqGkNGA8cCkj1nsh
v4-servo | Electronics and actuators | Servo | 2 | pcs | The older electrical list and V4-ly firmware retain four channels. Confirm the installed camera/mechanism configuration. | The parts list says 2; the older electrical list says 4. Do not add them. | Conflicting sources; confirm against the vehicle | https://item.taobao.com/item.htm?id=853148098562 | V4 parts list AUV electrical connections and component list IWIN-FINS V4-ly, fixed commit 42e5f16 | https://iwin-fins.feishu.cn/wiki/BQjFwY7GeiFW2KkmTXWcBC7fn8d https://iwin-fins.feishu.cn/wiki/R7XGwUqQZiNfqGkNGA8cCkj1nsh https://gitee.com/superkinkin/IWIN-FINS/tree/42e5f16f5b3ad3e23fceb5eb60868340b365dfd5/
v4-pressure-sensor | Electronics and actuators | Depth/pressure sensor | 4 | pcs | Parts list: stainless steel, 10 m option. An older product title mentions MS5837-30BA. Confirm the actual model/option; 10 m is not the vehicle depth rating. The older wiring uses the supplied adapter board; verify that it is included with the sensor. |  | Listed in source; verify before purchase | https://item.taobao.com/item.htm?id=605375059849 | V4 parts list AUV electrical connections and component list | https://iwin-fins.feishu.cn/wiki/BQjFwY7GeiFW2KkmTXWcBC7fn8d https://iwin-fins.feishu.cn/wiki/R7XGwUqQZiNfqGkNGA8cCkj1nsh
v4-battery | Electronics and actuators | 4S battery | 1 | pcs | XT60 main-power connector. The older electrical document records 10000 mAh and 25C; the parts list confirms only 4S/XT60. |  | Listed in source; verify before purchase | https://item.taobao.com/item.htm?id=609820541557 | V4 parts list AUV electrical connections and component list | https://iwin-fins.feishu.cn/wiki/BQjFwY7GeiFW2KkmTXWcBC7fn8d https://iwin-fins.feishu.cn/wiki/R7XGwUqQZiNfqGkNGA8cCkj1nsh
v4-relay | Electronics and actuators | Relay/power-switch module | 1 | pcs | The parts list says 30 A and the older electrical document says 120 A. The original short link is not evidence of the model or current rating. |  | Conflicting sources; confirm against the vehicle |  | V4 parts list AUV electrical connections and component list | https://iwin-fins.feishu.cn/wiki/BQjFwY7GeiFW2KkmTXWcBC7fn8d https://iwin-fins.feishu.cn/wiki/R7XGwUqQZiNfqGkNGA8cCkj1nsh
v4-rotary-switch | Electronics and actuators | Underwater rotary switch | 1 | pcs | Switch in the main-power control path; verify the connections and contact rating of the actual part. |  | Listed in source; verify before purchase | https://item.taobao.com/item.htm?id=746272975983 | V4 parts list AUV electrical connections and component list | https://iwin-fins.feishu.cn/wiki/BQjFwY7GeiFW2KkmTXWcBC7fn8d https://iwin-fins.feishu.cn/wiki/R7XGwUqQZiNfqGkNGA8cCkj1nsh
v4-buck-converter | Electronics and actuators | DC-DC step-down converter | 1 | pcs | Supplies the Raspberry Pi and mechanism branches; confirm voltage/current requirements for each load. |  | Listed in source; verify before purchase | https://item.taobao.com/item.htm?id=856012812115 | V4 parts list AUV electrical connections and component list | https://iwin-fins.feishu.cn/wiki/BQjFwY7GeiFW2KkmTXWcBC7fn8d https://iwin-fins.feishu.cn/wiki/R7XGwUqQZiNfqGkNGA8cCkj1nsh
v4-power-distribution | Electronics and actuators | Power distribution board | 1 | pcs | The older wiring uses it for Raspberry Pi/servo branches and also describes a custom split harness. Do not duplicate alternative distribution solutions. | Quantity 1 comes from the older electrical list; it is absent from the current parts list. | Historical alternative; do not add to current quantities | https://item.taobao.com/item.htm?id=814381038913 | AUV electrical connections and component list | https://iwin-fins.feishu.cn/wiki/R7XGwUqQZiNfqGkNGA8cCkj1nsh
v4-raspberry-pi | Electronics and actuators | Raspberry Pi 4B | 1 | pcs | Onboard computer; RAM and storage specifications are not stated in the parts list. |  | Listed in source; verify before purchase | https://detail.tmall.com/item.htm?id=705995475782 | V4 parts list AUV electrical connections and component list | https://iwin-fins.feishu.cn/wiki/BQjFwY7GeiFW2KkmTXWcBC7fn8d https://iwin-fins.feishu.cn/wiki/R7XGwUqQZiNfqGkNGA8cCkj1nsh
v4-controller | Electronics and actuators | RoboMaster C board | 1 | pcs | V4 controller named in the system documentation. The firmware project targets STM32F407IGHx; verify the actual board. |  | Listed in source; verify before purchase | https://item.taobao.com/item.htm?id=611226266955 | V4 parts list AUV electrical connections and component list IWIN-FINS V4-ly, fixed commit 42e5f16 | https://iwin-fins.feishu.cn/wiki/BQjFwY7GeiFW2KkmTXWcBC7fn8d https://iwin-fins.feishu.cn/wiki/R7XGwUqQZiNfqGkNGA8cCkj1nsh https://gitee.com/superkinkin/IWIN-FINS/tree/42e5f16f5b3ad3e23fceb5eb60868340b365dfd5/
v4-h30-imu | Electronics and actuators | H30 IMU (firmware dependency) |  | pcs | V4-ly attitude feedback uses H30 on USART1 at 921600 8N1; startup also checks BMI088. Record the actual H30 purchase model and mounting. | No confirmed quantity is given in the source; this does not mean zero. | Quantity or specification missing |  | IWIN-FINS V4-ly, fixed commit 42e5f16 | https://gitee.com/superkinkin/IWIN-FINS/tree/42e5f16f5b3ad3e23fceb5eb60868340b365dfd5/
v4-pca9685 | Electronics and actuators | PCA9685 PWM expansion board | 1 | pcs | Thrusters use channels 0–7; firmware reserves channels 8–11 for servos. Distinguish logic VCC from the V+ load supply. |  | Listed in source; verify before purchase | https://detail.tmall.com/item.htm?id=624960039615 | V4 parts list AUV electrical connections and component list IWIN-FINS V4-ly, fixed commit 42e5f16 | https://iwin-fins.feishu.cn/wiki/BQjFwY7GeiFW2KkmTXWcBC7fn8d https://iwin-fins.feishu.cn/wiki/R7XGwUqQZiNfqGkNGA8cCkj1nsh https://gitee.com/superkinkin/IWIN-FINS/tree/42e5f16f5b3ad3e23fceb5eb60868340b365dfd5/
v4-i2c-expander | Electronics and actuators | I2C multiplexer board | 1 | pcs | Firmware uses TCA9548A: channels 0–3 for pressure sensors and channel 4 for PCA9685. |  | Listed in source; verify before purchase | https://item.taobao.com/item.htm?id=612860784973 | V4 parts list AUV electrical connections and component list IWIN-FINS V4-ly, fixed commit 42e5f16 | https://iwin-fins.feishu.cn/wiki/BQjFwY7GeiFW2KkmTXWcBC7fn8d https://iwin-fins.feishu.cn/wiki/R7XGwUqQZiNfqGkNGA8cCkj1nsh https://gitee.com/superkinkin/IWIN-FINS/tree/42e5f16f5b3ad3e23fceb5eb60868340b365dfd5/
v4-camera | Electronics and actuators | Camera | 1 | pcs | The full design includes a stereo-camera arrangement; a monocular mount update dated 2025-07-10 is separate. Match the camera to the selected mount and interface. |  | Listed in source; verify before purchase | https://item.taobao.com/item.htm?id=793615736142 | V4 parts list Competition details and V4 design, including the mechanical version table | https://iwin-fins.feishu.cn/wiki/BQjFwY7GeiFW2KkmTXWcBC7fn8d https://iwin-fins.feishu.cn/wiki/Ty7WwhJmCihi7qk3Gx8cAL93n8f
v4-wireless-debugger | Electronics and actuators | Wireless debugger/programmer | 1 | pcs | Verify compatibility with the actual SWD connection and programming tool. |  | Listed in source; verify before purchase | https://item.taobao.com/item.htm?id=745548099223 | V4 parts list | https://iwin-fins.feishu.cn/wiki/BQjFwY7GeiFW2KkmTXWcBC7fn8d
v4-usb-ttl | Historical wiring alternatives | USB-to-TTL adapter | 1 | pcs | Optional UART connection in the older electrical document; distinguish it from direct GPIO UART wiring. | Quantity 1 comes from the older electrical list; it is absent from the current parts list. | Historical alternative; do not add to current quantities |  | AUV electrical connections and component list | https://iwin-fins.feishu.cn/wiki/R7XGwUqQZiNfqGkNGA8cCkj1nsh
v4-servo-thruster-connectors | Connectors and cabling | Watertight servo/thruster connectors | 12 | sets | Three-pin receptacle plus male cable; confirm equipment positions and cable lengths before custom assembly. | The source says 12 without a package unit; listed as sets from the mating-pair description, subject to confirmation. Note the older 8-thruster/4-servo layout versus the current 2-servo list. | Conflicting sources; confirm against the vehicle | https://item.taobao.com/item.htm?id=811948973422 | V4 parts list | https://iwin-fins.feishu.cn/wiki/BQjFwY7GeiFW2KkmTXWcBC7fn8d
v4-connector-caps | Connectors and cabling | Three-pin male blanking plugs | 2 | pcs | For unused servo/thruster connectors; match the mating receptacle. |  | Listed in source; verify before purchase | https://item.taobao.com/item.htm?id=811948973422 | V4 parts list | https://iwin-fins.feishu.cn/wiki/BQjFwY7GeiFW2KkmTXWcBC7fn8d
v4-pressure-sleeves | Connectors and cabling | External pressure-sensor sleeves | 4 | pcs | For sensor-cable extension and potting; follow the purchased materials/process specifications. |  | Listed in source; verify before purchase | https://item.taobao.com/item.htm?id=781752613399 | V4 parts list Competition details and V4 design, including the mechanical version table | https://iwin-fins.feishu.cn/wiki/BQjFwY7GeiFW2KkmTXWcBC7fn8d https://iwin-fins.feishu.cn/wiki/Ty7WwhJmCihi7qk3Gx8cAL93n8f
v4-pressure-connectors | Connectors and cabling | Watertight pressure-sensor connectors | 4 | sets | Custom 00W four-pin plug and receptacle; 65 cm vendor-supplied four-core cable. | The source quantity is 4; mating pairs are listed as sets. Confirm the supplier package unit. | Listed in source; verify before purchase | https://item.taobao.com/item.htm?id=619481441943 | V4 parts list | https://iwin-fins.feishu.cn/wiki/BQjFwY7GeiFW2KkmTXWcBC7fn8d
v4-ethernet-tether | Connectors and cabling | Neutral-buoyancy Ethernet tether | 100 | m | The quantity cell states “neutral-buoyancy Ethernet cable, 100 m”. Confirm termination, outer diameter, core count and length definition with the connector supplier. | 100 is a recorded length, not 100 cables; confirm whether it is the per-vehicle requirement. | Listed in source; verify before purchase |  | V4 parts list | https://iwin-fins.feishu.cn/wiki/BQjFwY7GeiFW2KkmTXWcBC7fn8d
v4-tether-connector | Connectors and cabling | Tether connector | 1 | pcs | 1W eight-pin plug; the mating receptacle and termination arrangement are not fully specified. |  | Listed in source; verify before purchase |  | V4 parts list | https://iwin-fins.feishu.cn/wiki/BQjFwY7GeiFW2KkmTXWcBC7fn8d
v4-camera-connector | Connectors and cabling | Camera connector |  | pcs | 1W four-pin plug; verify against the actual camera and cable-penetration design. | No confirmed quantity is given in the source; this does not mean zero. | Quantity or specification missing |  | V4 parts list | https://iwin-fins.feishu.cn/wiki/BQjFwY7GeiFW2KkmTXWcBC7fn8d
v4-terminal-20p | Connectors and cabling | H3800 20-position terminal block | 2 | pcs | Match the current mounting holes and wiring schedule. |  | Listed in source; verify before purchase | https://item.taobao.com/item.htm?id=661948958655 | V4 parts list | https://iwin-fins.feishu.cn/wiki/BQjFwY7GeiFW2KkmTXWcBC7fn8d
v4-terminal-16p | Connectors and cabling | H3803 16-position terminal block | 2 | pcs | Verify against the power/branch harnesses and the actual terminal specification. |  | Listed in source; verify before purchase | https://item.taobao.com/item.htm?id=551775262138 | V4 parts list | https://iwin-fins.feishu.cn/wiki/BQjFwY7GeiFW2KkmTXWcBC7fn8d
v4-terminal-6p | Connectors and cabling | H3800 6-position terminal block | 2 | pcs | An older document describes a different six-/seven-pin layout. Do not add the historical terminal rows to this quantity. |  | Listed in source; verify before purchase | https://item.taobao.com/item.htm?id=661948958655 | V4 parts list AUV electrical connections and component list | https://iwin-fins.feishu.cn/wiki/BQjFwY7GeiFW2KkmTXWcBC7fn8d https://iwin-fins.feishu.cn/wiki/R7XGwUqQZiNfqGkNGA8cCkj1nsh
v4-bridge-3-5mm | Connectors and cabling | 3.5 mm ten-position jumper bridge | 2 | pcs | FBS10-3.5, red, brass; match the terminal-block series. |  | Listed in source; verify before purchase | https://detail.tmall.com/item.htm?id=622709470719 | V4 parts list | https://iwin-fins.feishu.cn/wiki/BQjFwY7GeiFW2KkmTXWcBC7fn8d
v4-bridge-6-2mm | Connectors and cabling | 6.2 mm ten-position jumper bridge | 2 | pcs | Ten-position EB bridge; match the terminal-block series. |  | Listed in source; verify before purchase | https://item.taobao.com/item.htm?id=551775262138 | V4 parts list | https://iwin-fins.feishu.cn/wiki/BQjFwY7GeiFW2KkmTXWcBC7fn8d
v4-usb-c-power-cable | Connectors and cabling | Raspberry Pi USB-C power cable | 1 | pcs | The source specifies two left/right angled connectors; verify current capability and available space. |  | Listed in source; verify before purchase | https://detail.tmall.com/item.htm?id=739417974339 | V4 parts list | https://iwin-fins.feishu.cn/wiki/BQjFwY7GeiFW2KkmTXWcBC7fn8d
v4-historical-6pin-large | Historical wiring alternatives | Large six-pin terminal blocks, older layout | 4 | pcs | The older wiring uses these for thrusters with positive/negative/signal wiring. |  | Historical alternative; do not add to current quantities |  | AUV electrical connections and component list | https://iwin-fins.feishu.cn/wiki/R7XGwUqQZiNfqGkNGA8cCkj1nsh
v4-historical-6pin-small | Historical wiring alternatives | Small six-pin terminal blocks, older layout | 2 | pcs | Used for servos in the older wiring; do not add to the current H3800-series layout. |  | Historical alternative; do not add to current quantities |  | AUV electrical connections and component list | https://iwin-fins.feishu.cn/wiki/R7XGwUqQZiNfqGkNGA8cCkj1nsh
v4-historical-7pin-small | Historical wiring alternatives | Small seven-pin terminal block, older layout |  | pcs | Three UART wires plus four SWD wires; the source gives no explicit quantity. | No confirmed quantity is given in the source; this does not mean zero. | Historical alternative; do not add to current quantities |  | AUV electrical connections and component list | https://iwin-fins.feishu.cn/wiki/R7XGwUqQZiNfqGkNGA8cCkj1nsh
v4-historical-stlink | Historical wiring alternatives | ST-Link debugger (older connection) |  | pcs | The older wiring steps mention ST-Link. It is an alternative to the wireless debugger, not an automatic additional purchase. | No confirmed quantity is given in the source; this does not mean zero. | Historical alternative; do not add to current quantities |  | AUV electrical connections and component list | https://iwin-fins.feishu.cn/wiki/R7XGwUqQZiNfqGkNGA8cCkj1nsh
v4-switch-extension-wire | Fasteners and assembly materials | 24 AWG switch-extension wire |  | m | The older electrical text specifies 24 AWG only when the rotary-switch leads need extending; total length is not stated. | No confirmed quantity is given in the source; this does not mean zero. | Quantity or specification missing |  | AUV electrical connections and component list | https://iwin-fins.feishu.cn/wiki/R7XGwUqQZiNfqGkNGA8cCkj1nsh
v4-power-y-harness | Fasteners and assembly materials | XT60 and power-split harness |  | sets | The older wiring describes a Y split and XT60 connection. Use a completed, verified harness; the historical rewiring steps are not a product specification. | No confirmed quantity is given in the source; this does not mean zero. | Quantity or specification missing |  | AUV electrical connections and component list | https://iwin-fins.feishu.cn/wiki/R7XGwUqQZiNfqGkNGA8cCkj1nsh
v4-side-support | Mechanical and machined parts | Side support |  | pcs | 主体/侧支撑.STEP; a DWG is also provided. The V4 aluminum-machining instructions specify matte black anodizing; use the drawings for material and tolerances. | The CAD contains this part, but its assembly instance count is unconfirmed. Do not copy the Pro quantity. | Quantity or specification missing |  | Competition details and V4 design, including the mechanical version table V4 neutral CAD from 2025-05-23 and later optional mechanism files | https://iwin-fins.feishu.cn/wiki/Ty7WwhJmCihi7qk3Gx8cAL93n8f https://github.com/FPJ-GAOGE/V4-Underwater-Robot/tree/main/hardware/v4
v4-bottom-support | Mechanical and machined parts | Bottom support 2 |  | pcs | 主体/底支撑2.STEP; a DWG is also provided. The V4 aluminum-machining instructions specify matte black anodizing; use the drawings for material and tolerances. | The CAD contains this part, but its assembly instance count is unconfirmed. Do not copy the Pro quantity. | Quantity or specification missing |  | Competition details and V4 design, including the mechanical version table V4 neutral CAD from 2025-05-23 and later optional mechanism files | https://iwin-fins.feishu.cn/wiki/Ty7WwhJmCihi7qk3Gx8cAL93n8f https://github.com/FPJ-GAOGE/V4-Underwater-Robot/tree/main/hardware/v4
v4-upper-thruster-support | Mechanical and machined parts | Upper thruster support |  | pcs | 主体/上推进器支撑.STEP; a DWG is also provided. The V4 aluminum-machining instructions specify matte black anodizing; use the drawings for material and tolerances. | The CAD contains this part, but its assembly instance count is unconfirmed. Do not copy the Pro quantity. | Quantity or specification missing |  | Competition details and V4 design, including the mechanical version table V4 neutral CAD from 2025-05-23 and later optional mechanism files | https://iwin-fins.feishu.cn/wiki/Ty7WwhJmCihi7qk3Gx8cAL93n8f https://github.com/FPJ-GAOGE/V4-Underwater-Robot/tree/main/hardware/v4
v4-corner-piece | Mechanical and machined parts | Corner bracket |  | pcs | 主体/角件.STEP. The V4 aluminum-machining instructions specify matte black anodizing; use the drawings for material and tolerances. | The CAD contains this part, but its assembly instance count is unconfirmed. Do not copy the Pro quantity. | Quantity or specification missing |  | Competition details and V4 design, including the mechanical version table V4 neutral CAD from 2025-05-23 and later optional mechanism files | https://iwin-fins.feishu.cn/wiki/Ty7WwhJmCihi7qk3Gx8cAL93n8f https://github.com/FPJ-GAOGE/V4-Underwater-Robot/tree/main/hardware/v4
v4-rear-endcap | Mechanical and machined parts | Rear end cap 165 |  | pcs | 密封舱/后舱盖165.STEP; a DWG is also provided. The V4 aluminum-machining instructions specify matte black anodizing; use the drawings for material and tolerances. | The CAD contains this part, but its assembly instance count is unconfirmed. Do not copy the Pro quantity. | Quantity or specification missing |  | Competition details and V4 design, including the mechanical version table V4 neutral CAD from 2025-05-23 and later optional mechanism files | https://iwin-fins.feishu.cn/wiki/Ty7WwhJmCihi7qk3Gx8cAL93n8f https://github.com/FPJ-GAOGE/V4-Underwater-Robot/tree/main/hardware/v4
v4-gimbal-base | Mechanical and machined parts | Gimbal base |  | pcs | 相机云台/云台底架.STEP; a DWG is also provided. The V4 aluminum-machining instructions specify matte black anodizing; use the drawings for material and tolerances. | The CAD contains this part, but its assembly instance count is unconfirmed. Do not copy the Pro quantity. | Quantity or specification missing |  | Competition details and V4 design, including the mechanical version table V4 neutral CAD from 2025-05-23 and later optional mechanism files | https://iwin-fins.feishu.cn/wiki/Ty7WwhJmCihi7qk3Gx8cAL93n8f https://github.com/FPJ-GAOGE/V4-Underwater-Robot/tree/main/hardware/v4
v4-rear-gimbal-base | Mechanical and machined parts | Rear gimbal base |  | pcs | 相机云台/后云台底架.STEP; a DWG is also provided. The V4 aluminum-machining instructions specify matte black anodizing; use the drawings for material and tolerances. | The CAD contains this part, but its assembly instance count is unconfirmed. Do not copy the Pro quantity. | Quantity or specification missing |  | Competition details and V4 design, including the mechanical version table V4 neutral CAD from 2025-05-23 and later optional mechanism files | https://iwin-fins.feishu.cn/wiki/Ty7WwhJmCihi7qk3Gx8cAL93n8f https://github.com/FPJ-GAOGE/V4-Underwater-Robot/tree/main/hardware/v4
v4-sensor-sleeve-mount | Mechanical and machined parts | Machined external-sleeve mount |  | pcs | 水深传感器/外置套管固定加工版.STEP. The V4 aluminum-machining instructions specify matte black anodizing; use the drawings for material and tolerances. | The CAD contains this part, but its assembly instance count is unconfirmed. Do not copy the Pro quantity. | Quantity or specification missing |  | Competition details and V4 design, including the mechanical version table V4 neutral CAD from 2025-05-23 and later optional mechanism files | https://iwin-fins.feishu.cn/wiki/Ty7WwhJmCihi7qk3Gx8cAL93n8f https://github.com/FPJ-GAOGE/V4-Underwater-Robot/tree/main/hardware/v4
v4-upper-electronics-tray | Printed parts and internal supports | Upper electronics tray |  | pcs | CAD: 密封舱/舱内/上层架板.STEP. Confirm the process, material and quantity from the selected assembly; file presence alone does not establish them. | No confirmed quantity is given in the source; this does not mean zero. | Quantity or specification missing |  | V4 neutral CAD from 2025-05-23 and later optional mechanism files | https://github.com/FPJ-GAOGE/V4-Underwater-Robot/tree/main/hardware/v4
v4-lower-electronics-tray | Printed parts and internal supports | Lower electronics tray |  | pcs | CAD: 密封舱/舱内/下层架板.STEP. Confirm the process, material and quantity from the selected assembly; file presence alone does not establish them. | No confirmed quantity is given in the source; this does not mean zero. | Quantity or specification missing |  | V4 neutral CAD from 2025-05-23 and later optional mechanism files | https://github.com/FPJ-GAOGE/V4-Underwater-Robot/tree/main/hardware/v4
v4-battery-tray | Printed parts and internal supports | Battery holder |  | pcs | CAD: 密封舱/舱内/电池架.STEP. Confirm the process, material and quantity from the selected assembly; file presence alone does not establish them. | No confirmed quantity is given in the source; this does not mean zero. | Quantity or specification missing |  | V4 neutral CAD from 2025-05-23 and later optional mechanism files | https://github.com/FPJ-GAOGE/V4-Underwater-Robot/tree/main/hardware/v4
v4-camera-link | Printed parts and internal supports | Camera mounting link |  | pcs | CAD: 相机云台/相机连接件.STEP. Confirm the process, material and quantity from the selected assembly; file presence alone does not establish them. | No confirmed quantity is given in the source; this does not mean zero. | Quantity or specification missing |  | V4 neutral CAD from 2025-05-23 and later optional mechanism files | https://github.com/FPJ-GAOGE/V4-Underwater-Robot/tree/main/hardware/v4
v4-servo-link | Printed parts and internal supports | Servo mounting link |  | pcs | CAD: 相机云台/舵机连接件.STEP. Confirm the process, material and quantity from the selected assembly; file presence alone does not establish them. | No confirmed quantity is given in the source; this does not mean zero. | Quantity or specification missing |  | V4 neutral CAD from 2025-05-23 and later optional mechanism files | https://github.com/FPJ-GAOGE/V4-Underwater-Robot/tree/main/hardware/v4
v4-buoyancy-shell | Printed parts and internal supports | Buoyancy shell 2 |  | pcs | CAD: 浮力外壳/浮力外壳2.STEP. Confirm the process, material and quantity from the selected assembly; file presence alone does not establish them. | No confirmed quantity is given in the source; this does not mean zero. | Quantity or specification missing |  | V4 neutral CAD from 2025-05-23 and later optional mechanism files | https://github.com/FPJ-GAOGE/V4-Underwater-Robot/tree/main/hardware/v4
v4-sealed-housing | Mechanical and machined parts | Sealed enclosure and associated seals/mounts |  | assembly (breakdown required) | The manufacturing steps mention the sealed enclosure and rear cap, but do not provide a complete enclosure/seal purchase breakdown or a vehicle depth rating. | No confirmed quantity is given in the source; this does not mean zero. | Quantity or specification missing |  | Competition details and V4 design, including the mechanical version table | https://iwin-fins.feishu.cn/wiki/Ty7WwhJmCihi7qk3Gx8cAL93n8f
v4-heat-set-inserts | Fasteners and assembly materials | M2.5/M3 heat-set inserts |  | pcs | Use M2.5 at Raspberry Pi/PWM-board positions and M3 at other specified positions; not every hole receives an insert. | No confirmed quantity is given in the source; this does not mean zero. | Quantity or specification missing |  | Competition details and V4 design, including the mechanical version table | https://iwin-fins.feishu.cn/wiki/Ty7WwhJmCihi7qk3Gx8cAL93n8f
v4-nylon-standoffs | Fasteners and assembly materials | M2.5/M3 nylon standoffs |  | pcs | M2.5 for Raspberry Pi/PWM-board positions and M3 elsewhere as specified; the C board and terminals do not use the same standoffs. | No confirmed quantity is given in the source; this does not mean zero. | Quantity or specification missing |  | Competition details and V4 design, including the mechanical version table | https://iwin-fins.feishu.cn/wiki/Ty7WwhJmCihi7qk3Gx8cAL93n8f
v4-fasteners | Fasteners and assembly materials | Frame and electronics-mount fasteners |  | pcs | Derive from the 2025-05-23 assembly and threaded-hole drawings; the source has no consolidated size/quantity list. | No confirmed quantity is given in the source; this does not mean zero. | Quantity or specification missing |  | Competition details and V4 design, including the mechanical version table V4 neutral CAD from 2025-05-23 and later optional mechanism files | https://iwin-fins.feishu.cn/wiki/Ty7WwhJmCihi7qk3Gx8cAL93n8f https://github.com/FPJ-GAOGE/V4-Underwater-Robot/tree/main/hardware/v4
v4-potting-material | Fasteners and assembly materials | Epoxy potting and insulating materials |  | amount TBD | The source requires epoxy potting after soldering and insulation of unused distribution points; mixture and quantity are not specified. | No confirmed quantity is given in the source; this does not mean zero. | Quantity or specification missing |  | Competition details and V4 design, including the mechanical version table AUV electrical connections and component list | https://iwin-fins.feishu.cn/wiki/Ty7WwhJmCihi7qk3Gx8cAL93n8f https://iwin-fins.feishu.cn/wiki/R7XGwUqQZiNfqGkNGA8cCkj1nsh
v4-monocular-mount-update | Optional mechanisms and later updates | 2025-07-10 monocular-camera mount update |  | assembly (breakdown required) | Two separate SLDPRT definitions, 相机支架1 and 相机支架2; this does not establish one of each per vehicle. Confirm the chosen mechanism. | No confirmed quantity is given in the source; this does not mean zero. | Optional design files; not part of the default assembly |  | Competition details and V4 design, including the mechanical version table V4 neutral CAD from 2025-05-23 and later optional mechanism files | https://iwin-fins.feishu.cn/wiki/Ty7WwhJmCihi7qk3Gx8cAL93n8f https://github.com/FPJ-GAOGE/V4-Underwater-Robot/tree/main/hardware/v4
v4-gripper-design | Optional mechanisms and later updates | Optional gripper design package |  | assembly (breakdown required) | Contains driving/driven gears, a circular flange, gripper finger, link rod, base and top-cover models. Instance counts and vehicle integration are unconfirmed. | No confirmed quantity is given in the source; this does not mean zero. | Optional design files; not part of the default assembly |  | Competition details and V4 design, including the mechanical version table V4 neutral CAD from 2025-05-23 and later optional mechanism files | https://iwin-fins.feishu.cn/wiki/Ty7WwhJmCihi7qk3Gx8cAL93n8f https://github.com/FPJ-GAOGE/V4-Underwater-Robot/tree/main/hardware/v4

Sheet: V4-pro 中文
V4-pro 材料清单
资料整理日期：2026-10-22。空白数量表示原资料未明确，不等于零。
状态列区分历史替代方案、可选件和待确认项。历史清单不得与现行清单直接相加；商品链接不代表当前价格或在售状态。
条目 ID | 类别 | 元件 / 零件 | 数量 | 单位 | 规格及型号差异 | 数量依据 / 备注 | 状态 | 原商品记录 | 资料来源 | 来源链接
v4-pro-thruster | 电子与执行器 | 无刷推进器（不带电调） | 8 | 件 | 4正桨+4反桨；一正一反为一组，4组线长65/50/38/32cm。三根电机相线，不是V4正/负/PWM线。 |  | 原文列明，采购前核对 | https://item.taobao.com/item.htm?id=591864716045 | V4-PRO制作文档汇总（RM-A主控） | https://iwin-fins.feishu.cn/wiki/RfVuwKMnqisR3rkWaFmcW6bOnVh
v4-pro-esc | 电子与执行器 | 四合一电调 | 2 | 件 | 共8电机通道；FineSUB使用DSHOT双向3D及遥测，电调型号/电压/固件参数待确认。 |  | 原文列明，采购前核对 |  | V4-PRO制作文档汇总（RM-A主控） FineSUB v4pro1固定提交5a78326 | https://iwin-fins.feishu.cn/wiki/RfVuwKMnqisR3rkWaFmcW6bOnVh https://gitee.com/gan-ju/FineSUB/tree/5a7832648206e522e9b8e0dff108638789f6afdd/
v4-pro-pressure-sensor | 电子与执行器 | 水深/水压传感器 | 4 | 件 | 316L不锈钢、10m选项；定制70cm防水线，1红/2黑/3绿SCL/4白SDA。10m不是整机潜深。 |  | 原文列明，采购前核对 | https://item.taobao.com/item.htm?id=605375059849 | V4-PRO制作文档汇总（RM-A主控） | https://iwin-fins.feishu.cn/wiki/RfVuwKMnqisR3rkWaFmcW6bOnVh
v4-pro-fill-light | 电子与执行器 | PWM补光灯 | 2 | 件 | ArduSub脉宽控制探照灯，100°光束角；60cm防水线，1红/2黑/3黄PWM；动力供电按器件核实。 |  | 原文列明，采购前核对 | https://item.taobao.com/item.htm?id=934701227487 | V4-PRO制作文档汇总（RM-A主控） V4接线简化图（内容为V4-pro） | https://iwin-fins.feishu.cn/wiki/RfVuwKMnqisR3rkWaFmcW6bOnVh https://iwin-fins.feishu.cn/wiki/AW4WwJtehiJW3mk2VVbcxBXOnje
v4-pro-servo | 电子与执行器 | 舵机 | 2 | 件 | 75cm防水线，1红/2黑/3黄PWM。接线简图标5V，制作文字要求A板可调负载电源8.4V，必须核对。 |  | 来源冲突，待实物确认 | https://item.taobao.com/item.htm?id=853148098562 | V4-PRO制作文档汇总（RM-A主控） V4接线简化图（内容为V4-pro） | https://iwin-fins.feishu.cn/wiki/RfVuwKMnqisR3rkWaFmcW6bOnVh https://iwin-fins.feishu.cn/wiki/AW4WwJtehiJW3mk2VVbcxBXOnje
v4-pro-controller | 电子与执行器 | RoboMaster A板 | 1 | 件 | STM32F427；推进器为DSHOT，灯具/舵机是独立PWM输出；核对板卡和负载供电。 |  | 原文列明，采购前核对 | https://item.taobao.com/item.htm?id=605165393036 | V4-PRO制作文档汇总（RM-A主控） FineSUB v4pro1固定提交5a78326 | https://iwin-fins.feishu.cn/wiki/RfVuwKMnqisR3rkWaFmcW6bOnVh https://gitee.com/gan-ju/FineSUB/tree/5a7832648206e522e9b8e0dff108638789f6afdd/
v4-pro-jetson | 电子与执行器 | Jetson Orin模块与载板 | 1 | 套 | 制作清单记“NANO”；关联说明覆盖Orin NX/Nano、达妙载板。不是旧款Jetson Nano的通用替代。 | 原文“NANO×1”；暂以一套计算机记数，模块/载板的独立采购数量待确认。 | 原文列明，采购前核对 |  | V4-PRO制作文档汇总（RM-A主控） ORIN NX配置（ORIN NANO同样适用） | https://iwin-fins.feishu.cn/wiki/RfVuwKMnqisR3rkWaFmcW6bOnVh https://iwin-fins.feishu.cn/docx/S8I9dBMNmo2dIPxhWzkcyeQsnoP
v4-pro-battery | 电子与执行器 | 定制电池 |  | 件 | 原接线图主电源标24V；容量、电芯串并联、保护及充电接口未明确，不能用商品标题补齐。 | 原文未给出可确认的数量；不等于0。 | 数量或规格缺失 |  | V4-PRO制作文档汇总（RM-A主控） V4接线简化图（内容为V4-pro） | https://iwin-fins.feishu.cn/wiki/RfVuwKMnqisR3rkWaFmcW6bOnVh https://iwin-fins.feishu.cn/wiki/AW4WwJtehiJW3mk2VVbcxBXOnje
v4-pro-power-distribution | 电子与执行器 | 分电板 |  | 件 | 匹配电池、电调、主控、Jetson支路；具体型号/电流和数量未列。 | 原文未给出可确认的数量；不等于0。 | 数量或规格缺失 |  | V4-PRO制作文档汇总（RM-A主控） V4接线简化图（内容为V4-pro） | https://iwin-fins.feishu.cn/wiki/RfVuwKMnqisR3rkWaFmcW6bOnVh https://iwin-fins.feishu.cn/wiki/AW4WwJtehiJW3mk2VVbcxBXOnje
v4-pro-i2c-expander | 电子与执行器 | I2C扩展板 |  | 件 | 制作要求3.3V；当前固件为I2C2→TCA9548A地址0x70→4路水压计。 | 原文未给出可确认的数量；不等于0。 | 数量或规格缺失 | https://item.taobao.com/item.htm?id=677595693967 | V4-PRO制作文档汇总（RM-A主控） FineSUB v4pro1固定提交5a78326 | https://iwin-fins.feishu.cn/wiki/RfVuwKMnqisR3rkWaFmcW6bOnVh https://gitee.com/gan-ju/FineSUB/tree/5a7832648206e522e9b8e0dff108638789f6afdd/
v4-pro-imu | 电子与执行器 | IMU |  | 件 | 供应商刷400Hz固件，配置921600波特率；源码为H30/UART7，确认实际硬件型号。 | 原文未给出可确认的数量；不等于0。 | 数量或规格缺失 | https://item.taobao.com/item.htm?id=649300089333 | V4-PRO制作文档汇总（RM-A主控） FineSUB v4pro1固定提交5a78326 | https://iwin-fins.feishu.cn/wiki/RfVuwKMnqisR3rkWaFmcW6bOnVh https://gitee.com/gan-ju/FineSUB/tree/5a7832648206e522e9b8e0dff108638789f6afdd/
v4-pro-wireless-programmer | 电子与执行器 | 无线烧写器 | 2 | 件 | 按各自用途和SWD接口配套，不代表同时连接两台到一块板。 |  | 原文列明，采购前核对 | https://item.taobao.com/item.htm?id=745548099223 | V4-PRO制作文档汇总（RM-A主控） | https://iwin-fins.feishu.cn/wiki/RfVuwKMnqisR3rkWaFmcW6bOnVh
v4-pro-powerline-modem | 电子与执行器 | 电力载波模块 | 2 | 件 | PC与潜器通信的成对模块，具体型号/电源参数按实物核对。 |  | 原文列明，采购前核对 | https://item.taobao.com/item.htm?id=674728822237 | V4-PRO制作文档汇总（RM-A主控） | https://iwin-fins.feishu.cn/wiki/RfVuwKMnqisR3rkWaFmcW6bOnVh
v4-pro-camera | 电子与执行器 | USB相机 |  | 件 | 制作步骤与Orin说明提及USB相机；型号、数量及实际视频模式未完整给出。 | 原文未给出可确认的数量；不等于0。 | 数量或规格缺失 |  | V4-PRO制作文档汇总（RM-A主控） ORIN NX配置（ORIN NANO同样适用） | https://iwin-fins.feishu.cn/wiki/RfVuwKMnqisR3rkWaFmcW6bOnVh https://iwin-fins.feishu.cn/docx/S8I9dBMNmo2dIPxhWzkcyeQsnoP
v4-pro-rotary-switch | 电子与执行器 | 旋钮开关 |  | 件 | 内部焊线步骤提及；触点额定值和数量未列，不能套用V4开关条目。 | 原文未给出可确认的数量；不等于0。 | 数量或规格缺失 |  | V4-PRO制作文档汇总（RM-A主控） | https://iwin-fins.feishu.cn/wiki/RfVuwKMnqisR3rkWaFmcW6bOnVh
v4-pro-terminal-12p | 连接器与线材 | H3800 12P接线端子 | 2 | 件 | 文字列12P×2；接线图另外显示20P及舵机12P等，须按最终线束重新确认。 |  | 来源冲突，待实物确认 | https://item.taobao.com/item.htm?id=661948958655 | V4-PRO制作文档汇总（RM-A主控） V4接线简化图（内容为V4-pro） | https://iwin-fins.feishu.cn/wiki/RfVuwKMnqisR3rkWaFmcW6bOnVh https://iwin-fins.feishu.cn/wiki/AW4WwJtehiJW3mk2VVbcxBXOnje
v4-pro-terminal-drawing-extras | 连接器与线材 | 接线图额外20P/12P端子（待合并） |  | 件 | 用于记录图文差异，不作为在12P×2之外已确认需要追加的数量。 | 原文未给出可确认的数量；不等于0。 | 来源冲突，待实物确认 |  | V4接线简化图（内容为V4-pro） | https://iwin-fins.feishu.cn/wiki/AW4WwJtehiJW3mk2VVbcxBXOnje
v4-pro-thruster-connectors | 连接器与线材 | 推进器1W 3芯水密接插件 |  | 组（待核对） | 三相线插头；对应插座要求15A、20cm舱内线；各路配对和包装单位需展开。 | 原文随8个推进器说明定制接插件，未另列采购数量；不能假定计数单位。 | 数量或规格缺失 |  | V4-PRO制作文档汇总（RM-A主控） | https://iwin-fins.feishu.cn/wiki/RfVuwKMnqisR3rkWaFmcW6bOnVh
v4-pro-pressure-connectors | 连接器与线材 | 水压计00W 4芯水密接插件 |  | 组（待核对） | 插头1红/2黑/3绿SCL/4白SDA；插座20cm舱内线，传感器侧70cm。 | 与4个水压计配套，原文未单列接插件采购数量。 | 数量或规格缺失 |  | V4-PRO制作文档汇总（RM-A主控） | https://iwin-fins.feishu.cn/wiki/RfVuwKMnqisR3rkWaFmcW6bOnVh
v4-pro-light-connectors | 连接器与线材 | 补光灯1W 3芯水密接插件 |  | 组（待核对） | 1红/2黑/3黄PWM；插座3A、20cm舱内线，设备侧60cm。 | 与2个灯配套，原文未单列接插件采购数量。 | 数量或规格缺失 |  | V4-PRO制作文档汇总（RM-A主控） | https://iwin-fins.feishu.cn/wiki/RfVuwKMnqisR3rkWaFmcW6bOnVh
v4-pro-servo-connectors | 连接器与线材 | 舵机1W 3芯水密接插件 |  | 组（待核对） | 1红/2黑/3黄PWM；插座2A、20cm舱内线，设备侧75cm。 | 与2个舵机配套，原文未单列接插件采购数量。 | 数量或规格缺失 |  | V4-PRO制作文档汇总（RM-A主控） | https://iwin-fins.feishu.cn/wiki/RfVuwKMnqisR3rkWaFmcW6bOnVh
v4-pro-uart-harness | 连接器与线材 | Jetson–RM-A UART连接线 |  | 条 | GH1.25 4pin线去除5V，仅GND共地、TX↔RX；/dev/ttyTHS1对接UART3，按具体载板核对。 | 原文未给出可确认的数量；不等于0。 | 数量或规格缺失 |  | ORIN NX配置（ORIN NANO同样适用） | https://iwin-fins.feishu.cn/docx/S8I9dBMNmo2dIPxhWzkcyeQsnoP
v4-pro-camera-penetrator | 连接器与线材 | 相机穿舱件 |  | 件 | 内部装配要求制作相机穿线螺丝；按相机电缆外径和密封方案核对。 | 原文未给出可确认的数量；不等于0。 | 数量或规格缺失 |  | V4-PRO制作文档汇总（RM-A主控） | https://iwin-fins.feishu.cn/wiki/RfVuwKMnqisR3rkWaFmcW6bOnVh
v4-pro-ethernet-cable | 连接器与线材 | 以太网/载波连接线 |  | 条 | Orin与PC调试先直连网线，整机另有载波模块；线长与端接未给统一规格。 | 原文未给出可确认的数量；不等于0。 | 数量或规格缺失 |  | V4-PRO制作文档汇总（RM-A主控） ORIN NX配置（ORIN NANO同样适用） | https://iwin-fins.feishu.cn/wiki/RfVuwKMnqisR3rkWaFmcW6bOnVh https://iwin-fins.feishu.cn/docx/S8I9dBMNmo2dIPxhWzkcyeQsnoP
v4-pro-side-support | 结构与加工件 | 侧支撑 | 2 | 件 | 主体/侧支撑.STEP与DWG。 材料、公差与表面处理按对应工程图。 |  | 原文列明，采购前核对 |  | V4-PRO制作文档汇总（RM-A主控） V4pro.zip提取的CAD资料 | https://iwin-fins.feishu.cn/wiki/RfVuwKMnqisR3rkWaFmcW6bOnVh https://github.com/FPJ-GAOGE/V4-Underwater-Robot/tree/main/hardware/v4-pro
v4-pro-bottom-support | 结构与加工件 | 底支撑2 | 2 | 件 | 原清单称底支撑，文件名底支撑2。 材料、公差与表面处理按对应工程图。 |  | 原文列明，采购前核对 |  | V4-PRO制作文档汇总（RM-A主控） V4pro.zip提取的CAD资料 | https://iwin-fins.feishu.cn/wiki/RfVuwKMnqisR3rkWaFmcW6bOnVh https://github.com/FPJ-GAOGE/V4-Underwater-Robot/tree/main/hardware/v4-pro
v4-pro-upper-thruster-support | 结构与加工件 | 上推进器支撑 | 2 | 件 | 主体/上推进器支撑.STEP与DWG。 材料、公差与表面处理按对应工程图。 |  | 原文列明，采购前核对 |  | V4-PRO制作文档汇总（RM-A主控） V4pro.zip提取的CAD资料 | https://iwin-fins.feishu.cn/wiki/RfVuwKMnqisR3rkWaFmcW6bOnVh https://github.com/FPJ-GAOGE/V4-Underwater-Robot/tree/main/hardware/v4-pro
v4-pro-front-gimbal-base | 结构与加工件 | 前云台底座 | 1 | 件 | CAD对应相机云台/前云台底架。 材料、公差与表面处理按对应工程图。 |  | 原文列明，采购前核对 |  | V4-PRO制作文档汇总（RM-A主控） V4pro.zip提取的CAD资料 | https://iwin-fins.feishu.cn/wiki/RfVuwKMnqisR3rkWaFmcW6bOnVh https://github.com/FPJ-GAOGE/V4-Underwater-Robot/tree/main/hardware/v4-pro
v4-pro-rear-endcap | 结构与加工件 | 后舱盖 | 1 | 件 | CAD对应密封舱/后舱盖165；连接器孔与螺纹按工程图。 材料、公差与表面处理按对应工程图。 |  | 原文列明，采购前核对 |  | V4-PRO制作文档汇总（RM-A主控） V4pro.zip提取的CAD资料 | https://iwin-fins.feishu.cn/wiki/RfVuwKMnqisR3rkWaFmcW6bOnVh https://github.com/FPJ-GAOGE/V4-Underwater-Robot/tree/main/hardware/v4-pro
v4-pro-acrylic-tube | 结构与加工件 | 亚克力管 |  | 件 | 原采购文列亚克力管及附属固定件，未给数量/尺寸/耐压等级。 | 原文未给出可确认的数量；不等于0。 | 数量或规格缺失 |  | V4-PRO制作文档汇总（RM-A主控） | https://iwin-fins.feishu.cn/wiki/RfVuwKMnqisR3rkWaFmcW6bOnVh
v4-pro-housing-fixings | 结构与加工件 | 舱体密封圈/法兰/固定件 |  | 组（待展开） | 按完整装配体和配套舱体展开；原文未给完整独立零件数量。 | 原文未给出可确认的数量；不等于0。 | 数量或规格缺失 |  | V4-PRO制作文档汇总（RM-A主控） V4pro.zip提取的CAD资料 | https://iwin-fins.feishu.cn/wiki/RfVuwKMnqisR3rkWaFmcW6bOnVh https://github.com/FPJ-GAOGE/V4-Underwater-Robot/tree/main/hardware/v4-pro
v4-pro-upper-tray | 打印件与内部支撑 | 上层板架 | 1 | 件 | 按V4pro模型3D打印；材料、层高、填充率未给统一参数。 |  | 原文列明，采购前核对 |  | V4-PRO制作文档汇总（RM-A主控） V4pro.zip提取的CAD资料 | https://iwin-fins.feishu.cn/wiki/RfVuwKMnqisR3rkWaFmcW6bOnVh https://github.com/FPJ-GAOGE/V4-Underwater-Robot/tree/main/hardware/v4-pro
v4-pro-lower-tray | 打印件与内部支撑 | 下层板架 | 1 | 件 | 按V4pro模型3D打印；材料、层高、填充率未给统一参数。 |  | 原文列明，采购前核对 |  | V4-PRO制作文档汇总（RM-A主控） V4pro.zip提取的CAD资料 | https://iwin-fins.feishu.cn/wiki/RfVuwKMnqisR3rkWaFmcW6bOnVh https://github.com/FPJ-GAOGE/V4-Underwater-Robot/tree/main/hardware/v4-pro
v4-pro-pressure-mount | 打印件与内部支撑 | 水压计固定件 | 4 | 件 | 按V4pro模型3D打印；材料、层高、填充率未给统一参数。 |  | 原文列明，采购前核对 |  | V4-PRO制作文档汇总（RM-A主控） V4pro.zip提取的CAD资料 | https://iwin-fins.feishu.cn/wiki/RfVuwKMnqisR3rkWaFmcW6bOnVh https://github.com/FPJ-GAOGE/V4-Underwater-Robot/tree/main/hardware/v4-pro
v4-pro-light-mount | 打印件与内部支撑 | 补光灯固定件 | 2 | 件 | 按V4pro模型3D打印；材料、层高、填充率未给统一参数。 |  | 原文列明，采购前核对 |  | V4-PRO制作文档汇总（RM-A主控） V4pro.zip提取的CAD资料 | https://iwin-fins.feishu.cn/wiki/RfVuwKMnqisR3rkWaFmcW6bOnVh https://github.com/FPJ-GAOGE/V4-Underwater-Robot/tree/main/hardware/v4-pro
v4-pro-heat-set-inserts | 紧固件与装配材料 | M3/M4预埋螺母 |  | 件 | 按上下板架模型区分M3/M4孔位；不能使用V4的M2.5/M3说明代替。 | 原文未给出可确认的数量；不等于0。 | 数量或规格缺失 |  | V4-PRO制作文档汇总（RM-A主控） | https://iwin-fins.feishu.cn/wiki/RfVuwKMnqisR3rkWaFmcW6bOnVh
v4-pro-fasteners | 紧固件与装配材料 | 框架与板架螺钉 |  | 件 | 侧支撑要求平头螺丝；具体螺纹、长度和数量按装配体/工程图展开。 | 原文未给出可确认的数量；不等于0。 | 数量或规格缺失 |  | V4-PRO制作文档汇总（RM-A主控） V4pro.zip提取的CAD资料 | https://iwin-fins.feishu.cn/wiki/RfVuwKMnqisR3rkWaFmcW6bOnVh https://github.com/FPJ-GAOGE/V4-Underwater-Robot/tree/main/hardware/v4-pro
v4-pro-esc-capacitors | 紧固件与装配材料 | 电调配套电容 |  | 件 | 内部焊接步骤明确电调焊线与电容，未给电容规格和数量。 | 原文未给出可确认的数量；不等于0。 | 数量或规格缺失 |  | V4-PRO制作文档汇总（RM-A主控） | https://iwin-fins.feishu.cn/wiki/RfVuwKMnqisR3rkWaFmcW6bOnVh
v4-pro-power-harness | 紧固件与装配材料 | 动力/分电/开关线束 |  | 组（待展开） | 用于电调、分电板、定制电池、旋钮开关和载波模块；线规、保护与长度须按实际负载确定。 | 原文未给出可确认的数量；不等于0。 | 数量或规格缺失 |  | V4-PRO制作文档汇总（RM-A主控） | https://iwin-fins.feishu.cn/wiki/RfVuwKMnqisR3rkWaFmcW6bOnVh

Sheet: V4-pro English
V4-pro Bill of materials
Source snapshot: 2026-10-22. Blank quantities mean unspecified in the source, not zero.
Use Status to distinguish historical alternatives, optional parts, and unresolved items. Do not add historical alternatives to the current list. Supplier links do not establish current prices or availability.
Item ID | Category | Component / Part | Qty | Unit | Specifications and variant details | Quantity basis / Notes | Status | Original supplier link | Sources | Source URLs
v4-pro-thruster | Electronics and actuators | Brushless thruster without ESC | 8 | pcs | Four CW and four CCW propellers, paired one of each; the four cable groups are 65/50/38/32 cm. Three motor-phase wires, not the V4 power-positive/negative/PWM arrangement. |  | Listed in source; verify before purchase | https://item.taobao.com/item.htm?id=591864716045 | V4-PRO manufacturing guide (RM-A controller) | https://iwin-fins.feishu.cn/wiki/RfVuwKMnqisR3rkWaFmcW6bOnVh
v4-pro-esc | Electronics and actuators | Four-in-one ESC | 2 | pcs | Eight motor channels total. FineSUB uses DSHOT with bidirectional 3D mode and telemetry; confirm the ESC model, voltage and firmware settings. |  | Listed in source; verify before purchase |  | V4-PRO manufacturing guide (RM-A controller) FineSUB v4pro1, fixed commit 5a78326 | https://iwin-fins.feishu.cn/wiki/RfVuwKMnqisR3rkWaFmcW6bOnVh https://gitee.com/gan-ju/FineSUB/tree/5a7832648206e522e9b8e0dff108638789f6afdd/
v4-pro-pressure-sensor | Electronics and actuators | Depth/pressure sensor | 4 | pcs | 316L stainless steel, 10 m option; custom 70 cm waterproof leads, pin 1 red/2 black/3 green SCL/4 white SDA. The 10 m option is not a vehicle depth rating. |  | Listed in source; verify before purchase | https://item.taobao.com/item.htm?id=605375059849 | V4-PRO manufacturing guide (RM-A controller) | https://iwin-fins.feishu.cn/wiki/RfVuwKMnqisR3rkWaFmcW6bOnVh
v4-pro-fill-light | Electronics and actuators | PWM fill light | 2 | pcs | ArduSub pulse-width-controlled light, 100° beam angle; 60 cm waterproof lead, pin 1 red/2 black/3 yellow PWM. Verify its power supply specification. |  | Listed in source; verify before purchase | https://item.taobao.com/item.htm?id=934701227487 | V4-PRO manufacturing guide (RM-A controller) V4 simplified wiring drawing (the contents describe V4-pro) | https://iwin-fins.feishu.cn/wiki/RfVuwKMnqisR3rkWaFmcW6bOnVh https://iwin-fins.feishu.cn/wiki/AW4WwJtehiJW3mk2VVbcxBXOnje
v4-pro-servo | Electronics and actuators | Servo | 2 | pcs | 75 cm waterproof lead, pin 1 red/2 black/3 yellow PWM. The simplified drawing says 5 V while the manufacturing text specifies an 8.4 V adjustable board supply; resolve this before assembly. |  | Conflicting sources; confirm against the vehicle | https://item.taobao.com/item.htm?id=853148098562 | V4-PRO manufacturing guide (RM-A controller) V4 simplified wiring drawing (the contents describe V4-pro) | https://iwin-fins.feishu.cn/wiki/RfVuwKMnqisR3rkWaFmcW6bOnVh https://iwin-fins.feishu.cn/wiki/AW4WwJtehiJW3mk2VVbcxBXOnje
v4-pro-controller | Electronics and actuators | RoboMaster A board | 1 | pcs | STM32F427. Thrusters use DSHOT; lights/servos use separate PWM outputs. Verify board and load supplies. |  | Listed in source; verify before purchase | https://item.taobao.com/item.htm?id=605165393036 | V4-PRO manufacturing guide (RM-A controller) FineSUB v4pro1, fixed commit 5a78326 | https://iwin-fins.feishu.cn/wiki/RfVuwKMnqisR3rkWaFmcW6bOnVh https://gitee.com/gan-ju/FineSUB/tree/5a7832648206e522e9b8e0dff108638789f6afdd/
v4-pro-jetson | Electronics and actuators | Jetson Orin module and carrier board | 1 | set | The manufacturing list says “NANO”; the linked setup covers Orin NX/Nano and a Damiao carrier. This is not a generic substitution with the older Jetson Nano. | The source says “NANO ×1”. Counted as one computer set; separate module/carrier purchase quantities require confirmation. | Listed in source; verify before purchase |  | V4-PRO manufacturing guide (RM-A controller) Orin NX setup (also described as applicable to Orin Nano) | https://iwin-fins.feishu.cn/wiki/RfVuwKMnqisR3rkWaFmcW6bOnVh https://iwin-fins.feishu.cn/docx/S8I9dBMNmo2dIPxhWzkcyeQsnoP
v4-pro-battery | Electronics and actuators | Custom battery |  | pcs | The original wiring drawing labels the main supply 24 V. Capacity, cell configuration, protection and charging interface are unspecified; do not infer them from a product title. | No confirmed quantity is given in the source; this does not mean zero. | Quantity or specification missing |  | V4-PRO manufacturing guide (RM-A controller) V4 simplified wiring drawing (the contents describe V4-pro) | https://iwin-fins.feishu.cn/wiki/RfVuwKMnqisR3rkWaFmcW6bOnVh https://iwin-fins.feishu.cn/wiki/AW4WwJtehiJW3mk2VVbcxBXOnje
v4-pro-power-distribution | Electronics and actuators | Power distribution board |  | pcs | Must match the battery, ESC, controller and Jetson branches; model, current rating and quantity are not listed. | No confirmed quantity is given in the source; this does not mean zero. | Quantity or specification missing |  | V4-PRO manufacturing guide (RM-A controller) V4 simplified wiring drawing (the contents describe V4-pro) | https://iwin-fins.feishu.cn/wiki/RfVuwKMnqisR3rkWaFmcW6bOnVh https://iwin-fins.feishu.cn/wiki/AW4WwJtehiJW3mk2VVbcxBXOnje
v4-pro-i2c-expander | Electronics and actuators | I2C multiplexer board |  | pcs | The guide requires 3.3 V; current firmware uses I2C2 → TCA9548A at 0x70 → four pressure sensors. | No confirmed quantity is given in the source; this does not mean zero. | Quantity or specification missing | https://item.taobao.com/item.htm?id=677595693967 | V4-PRO manufacturing guide (RM-A controller) FineSUB v4pro1, fixed commit 5a78326 | https://iwin-fins.feishu.cn/wiki/RfVuwKMnqisR3rkWaFmcW6bOnVh https://gitee.com/gan-ju/FineSUB/tree/5a7832648206e522e9b8e0dff108638789f6afdd/
v4-pro-imu | Electronics and actuators | IMU |  | pcs | The guide requests 400 Hz firmware and 921600 baud. Firmware uses H30/UART7; confirm the actual hardware model. | No confirmed quantity is given in the source; this does not mean zero. | Quantity or specification missing | https://item.taobao.com/item.htm?id=649300089333 | V4-PRO manufacturing guide (RM-A controller) FineSUB v4pro1, fixed commit 5a78326 | https://iwin-fins.feishu.cn/wiki/RfVuwKMnqisR3rkWaFmcW6bOnVh https://gitee.com/gan-ju/FineSUB/tree/5a7832648206e522e9b8e0dff108638789f6afdd/
v4-pro-wireless-programmer | Electronics and actuators | Wireless programmer | 2 | pcs | Match each intended use and SWD interface; this does not mean attaching two programmers to one board. |  | Listed in source; verify before purchase | https://item.taobao.com/item.htm?id=745548099223 | V4-PRO manufacturing guide (RM-A controller) | https://iwin-fins.feishu.cn/wiki/RfVuwKMnqisR3rkWaFmcW6bOnVh
v4-pro-powerline-modem | Electronics and actuators | Power-line communication module | 2 | pcs | Paired modules for PC-to-vehicle communication; confirm model and power requirements. |  | Listed in source; verify before purchase | https://item.taobao.com/item.htm?id=674728822237 | V4-PRO manufacturing guide (RM-A controller) | https://iwin-fins.feishu.cn/wiki/RfVuwKMnqisR3rkWaFmcW6bOnVh
v4-pro-camera | Electronics and actuators | USB camera |  | pcs | The manufacturing/setup texts mention a USB camera; model, quantity and actual video modes are not fully specified. | No confirmed quantity is given in the source; this does not mean zero. | Quantity or specification missing |  | V4-PRO manufacturing guide (RM-A controller) Orin NX setup (also described as applicable to Orin Nano) | https://iwin-fins.feishu.cn/wiki/RfVuwKMnqisR3rkWaFmcW6bOnVh https://iwin-fins.feishu.cn/docx/S8I9dBMNmo2dIPxhWzkcyeQsnoP
v4-pro-rotary-switch | Electronics and actuators | Rotary power switch |  | pcs | Mentioned in the internal wiring steps; contact rating and quantity are not listed. Do not substitute the V4 switch entry automatically. | No confirmed quantity is given in the source; this does not mean zero. | Quantity or specification missing |  | V4-PRO manufacturing guide (RM-A controller) | https://iwin-fins.feishu.cn/wiki/RfVuwKMnqisR3rkWaFmcW6bOnVh
v4-pro-terminal-12p | Connectors and cabling | H3800 12-position terminal block | 2 | pcs | The text lists 12P ×2; the drawing also shows 20P and servo 12P blocks. Reconcile against the final harness. |  | Conflicting sources; confirm against the vehicle | https://item.taobao.com/item.htm?id=661948958655 | V4-PRO manufacturing guide (RM-A controller) V4 simplified wiring drawing (the contents describe V4-pro) | https://iwin-fins.feishu.cn/wiki/RfVuwKMnqisR3rkWaFmcW6bOnVh https://iwin-fins.feishu.cn/wiki/AW4WwJtehiJW3mk2VVbcxBXOnje
v4-pro-terminal-drawing-extras | Connectors and cabling | Additional 20P/12P blocks in drawing (reconciliation pending) |  | pcs | Records the drawing/text discrepancy; it is not a confirmed extra quantity on top of the listed 12P ×2. | No confirmed quantity is given in the source; this does not mean zero. | Conflicting sources; confirm against the vehicle |  | V4 simplified wiring drawing (the contents describe V4-pro) | https://iwin-fins.feishu.cn/wiki/AW4WwJtehiJW3mk2VVbcxBXOnje
v4-pro-thruster-connectors | Connectors and cabling | Thruster 1W three-pin watertight connectors |  | sets (confirm) | Motor-phase plugs; mating receptacles are specified at 15 A with 20 cm internal leads. Expand the mating pairs and supplier package units. | Connectors are specified with the eight thrusters, but no separate purchase count/unit is stated. | Quantity or specification missing |  | V4-PRO manufacturing guide (RM-A controller) | https://iwin-fins.feishu.cn/wiki/RfVuwKMnqisR3rkWaFmcW6bOnVh
v4-pro-pressure-connectors | Connectors and cabling | Pressure-sensor 00W four-pin watertight connectors |  | sets (confirm) | Plug pin 1 red/2 black/3 green SCL/4 white SDA; 20 cm internal receptacle leads and 70 cm sensor-side leads. | Specified with the four sensors; no separate connector purchase quantity is listed. | Quantity or specification missing |  | V4-PRO manufacturing guide (RM-A controller) | https://iwin-fins.feishu.cn/wiki/RfVuwKMnqisR3rkWaFmcW6bOnVh
v4-pro-light-connectors | Connectors and cabling | Fill-light 1W three-pin watertight connectors |  | sets (confirm) | Pin 1 red/2 black/3 yellow PWM; receptacle specified at 3 A with 20 cm internal leads and 60 cm device-side leads. | Specified with the two lights; no separate connector purchase quantity is listed. | Quantity or specification missing |  | V4-PRO manufacturing guide (RM-A controller) | https://iwin-fins.feishu.cn/wiki/RfVuwKMnqisR3rkWaFmcW6bOnVh
v4-pro-servo-connectors | Connectors and cabling | Servo 1W three-pin watertight connectors |  | sets (confirm) | Pin 1 red/2 black/3 yellow PWM; receptacle specified at 2 A with 20 cm internal leads and 75 cm device-side leads. | Specified with the two servos; no separate connector purchase quantity is listed. | Quantity or specification missing |  | V4-PRO manufacturing guide (RM-A controller) | https://iwin-fins.feishu.cn/wiki/RfVuwKMnqisR3rkWaFmcW6bOnVh
v4-pro-uart-harness | Connectors and cabling | Jetson-to-RM-A UART harness |  | cables | GH1.25 four-pin lead with the 5 V wire removed: common GND and crossed TX/RX. The documented /dev/ttyTHS1 connects to UART3; confirm the carrier revision. | No confirmed quantity is given in the source; this does not mean zero. | Quantity or specification missing |  | Orin NX setup (also described as applicable to Orin Nano) | https://iwin-fins.feishu.cn/docx/S8I9dBMNmo2dIPxhWzkcyeQsnoP
v4-pro-camera-penetrator | Connectors and cabling | Camera cable penetrator |  | pcs | The internal assembly instructions call for a camera cable penetrator; match the cable diameter and sealing design. | No confirmed quantity is given in the source; this does not mean zero. | Quantity or specification missing |  | V4-PRO manufacturing guide (RM-A controller) | https://iwin-fins.feishu.cn/wiki/RfVuwKMnqisR3rkWaFmcW6bOnVh
v4-pro-ethernet-cable | Connectors and cabling | Ethernet/power-line connection cables |  | cables | The Orin/PC setup uses a direct Ethernet cable for initial checks and paired power-line modules in the vehicle. No consolidated length/termination specification is given. | No confirmed quantity is given in the source; this does not mean zero. | Quantity or specification missing |  | V4-PRO manufacturing guide (RM-A controller) Orin NX setup (also described as applicable to Orin Nano) | https://iwin-fins.feishu.cn/wiki/RfVuwKMnqisR3rkWaFmcW6bOnVh https://iwin-fins.feishu.cn/docx/S8I9dBMNmo2dIPxhWzkcyeQsnoP
v4-pro-side-support | Mechanical and machined parts | Side support | 2 | pcs | 主体/侧支撑.STEP and DWG. Use the corresponding drawings for material, tolerance and finish. |  | Listed in source; verify before purchase |  | V4-PRO manufacturing guide (RM-A controller) CAD files extracted from V4pro.zip | https://iwin-fins.feishu.cn/wiki/RfVuwKMnqisR3rkWaFmcW6bOnVh https://github.com/FPJ-GAOGE/V4-Underwater-Robot/tree/main/hardware/v4-pro
v4-pro-bottom-support | Mechanical and machined parts | Bottom support 2 | 2 | pcs | Called bottom support in the list; the filename is 底支撑2. Use the corresponding drawings for material, tolerance and finish. |  | Listed in source; verify before purchase |  | V4-PRO manufacturing guide (RM-A controller) CAD files extracted from V4pro.zip | https://iwin-fins.feishu.cn/wiki/RfVuwKMnqisR3rkWaFmcW6bOnVh https://github.com/FPJ-GAOGE/V4-Underwater-Robot/tree/main/hardware/v4-pro
v4-pro-upper-thruster-support | Mechanical and machined parts | Upper thruster support | 2 | pcs | 主体/上推进器支撑.STEP and DWG. Use the corresponding drawings for material, tolerance and finish. |  | Listed in source; verify before purchase |  | V4-PRO manufacturing guide (RM-A controller) CAD files extracted from V4pro.zip | https://iwin-fins.feishu.cn/wiki/RfVuwKMnqisR3rkWaFmcW6bOnVh https://github.com/FPJ-GAOGE/V4-Underwater-Robot/tree/main/hardware/v4-pro
v4-pro-front-gimbal-base | Mechanical and machined parts | Front gimbal base | 1 | pcs | The matching CAD part is 相机云台/前云台底架. Use the corresponding drawings for material, tolerance and finish. |  | Listed in source; verify before purchase |  | V4-PRO manufacturing guide (RM-A controller) CAD files extracted from V4pro.zip | https://iwin-fins.feishu.cn/wiki/RfVuwKMnqisR3rkWaFmcW6bOnVh https://github.com/FPJ-GAOGE/V4-Underwater-Robot/tree/main/hardware/v4-pro
v4-pro-rear-endcap | Mechanical and machined parts | Rear end cap | 1 | pcs | The matching CAD part is 密封舱/后舱盖165; use the drawings for connector holes and threads. Use the corresponding drawings for material, tolerance and finish. |  | Listed in source; verify before purchase |  | V4-PRO manufacturing guide (RM-A controller) CAD files extracted from V4pro.zip | https://iwin-fins.feishu.cn/wiki/RfVuwKMnqisR3rkWaFmcW6bOnVh https://github.com/FPJ-GAOGE/V4-Underwater-Robot/tree/main/hardware/v4-pro
v4-pro-acrylic-tube | Mechanical and machined parts | Acrylic tube |  | pcs | The purchasing text lists an acrylic tube and associated mounts, without quantity, dimensions or pressure rating. | No confirmed quantity is given in the source; this does not mean zero. | Quantity or specification missing |  | V4-PRO manufacturing guide (RM-A controller) | https://iwin-fins.feishu.cn/wiki/RfVuwKMnqisR3rkWaFmcW6bOnVh
v4-pro-housing-fixings | Mechanical and machined parts | Enclosure seals/flanges/mounts |  | assembly (breakdown required) | Expand from the full assembly and selected enclosure; the source does not provide a complete per-part count. | No confirmed quantity is given in the source; this does not mean zero. | Quantity or specification missing |  | V4-PRO manufacturing guide (RM-A controller) CAD files extracted from V4pro.zip | https://iwin-fins.feishu.cn/wiki/RfVuwKMnqisR3rkWaFmcW6bOnVh https://github.com/FPJ-GAOGE/V4-Underwater-Robot/tree/main/hardware/v4-pro
v4-pro-upper-tray | Printed parts and internal supports | Upper electronics tray | 1 | pcs | 3D print from the V4pro model; no unified material, layer-height or infill settings are supplied. |  | Listed in source; verify before purchase |  | V4-PRO manufacturing guide (RM-A controller) CAD files extracted from V4pro.zip | https://iwin-fins.feishu.cn/wiki/RfVuwKMnqisR3rkWaFmcW6bOnVh https://github.com/FPJ-GAOGE/V4-Underwater-Robot/tree/main/hardware/v4-pro
v4-pro-lower-tray | Printed parts and internal supports | Lower electronics tray | 1 | pcs | 3D print from the V4pro model; no unified material, layer-height or infill settings are supplied. |  | Listed in source; verify before purchase |  | V4-PRO manufacturing guide (RM-A controller) CAD files extracted from V4pro.zip | https://iwin-fins.feishu.cn/wiki/RfVuwKMnqisR3rkWaFmcW6bOnVh https://github.com/FPJ-GAOGE/V4-Underwater-Robot/tree/main/hardware/v4-pro
v4-pro-pressure-mount | Printed parts and internal supports | Pressure-sensor mount | 4 | pcs | 3D print from the V4pro model; no unified material, layer-height or infill settings are supplied. |  | Listed in source; verify before purchase |  | V4-PRO manufacturing guide (RM-A controller) CAD files extracted from V4pro.zip | https://iwin-fins.feishu.cn/wiki/RfVuwKMnqisR3rkWaFmcW6bOnVh https://github.com/FPJ-GAOGE/V4-Underwater-Robot/tree/main/hardware/v4-pro
v4-pro-light-mount | Printed parts and internal supports | Fill-light mount | 2 | pcs | 3D print from the V4pro model; no unified material, layer-height or infill settings are supplied. |  | Listed in source; verify before purchase |  | V4-PRO manufacturing guide (RM-A controller) CAD files extracted from V4pro.zip | https://iwin-fins.feishu.cn/wiki/RfVuwKMnqisR3rkWaFmcW6bOnVh https://github.com/FPJ-GAOGE/V4-Underwater-Robot/tree/main/hardware/v4-pro
v4-pro-heat-set-inserts | Fasteners and assembly materials | M3/M4 heat-set inserts |  | pcs | Select M3/M4 positions from the upper/lower tray models; do not substitute the V4 M2.5/M3 instructions. | No confirmed quantity is given in the source; this does not mean zero. | Quantity or specification missing |  | V4-PRO manufacturing guide (RM-A controller) | https://iwin-fins.feishu.cn/wiki/RfVuwKMnqisR3rkWaFmcW6bOnVh
v4-pro-fasteners | Fasteners and assembly materials | Frame and electronics-mount screws |  | pcs | Flat-head screws are specified for side supports; derive threads, lengths and quantities from the assembly/drawings. | No confirmed quantity is given in the source; this does not mean zero. | Quantity or specification missing |  | V4-PRO manufacturing guide (RM-A controller) CAD files extracted from V4pro.zip | https://iwin-fins.feishu.cn/wiki/RfVuwKMnqisR3rkWaFmcW6bOnVh https://github.com/FPJ-GAOGE/V4-Underwater-Robot/tree/main/hardware/v4-pro
v4-pro-esc-capacitors | Fasteners and assembly materials | ESC capacitors |  | pcs | The internal soldering steps explicitly mention ESC wiring and capacitors, without capacitor ratings or quantities. | No confirmed quantity is given in the source; this does not mean zero. | Quantity or specification missing |  | V4-PRO manufacturing guide (RM-A controller) | https://iwin-fins.feishu.cn/wiki/RfVuwKMnqisR3rkWaFmcW6bOnVh
v4-pro-power-harness | Fasteners and assembly materials | Power/distribution/switch harnesses |  | sets (breakdown required) | For ESCs, distribution board, custom battery, rotary switch and power-line modules; determine wire gauge, protection and lengths from actual loads. | No confirmed quantity is given in the source; this does not mean zero. | Quantity or specification missing |  | V4-PRO manufacturing guide (RM-A controller) | https://iwin-fins.feishu.cn/wiki/RfVuwKMnqisR3rkWaFmcW6bOnVh
