FPJ-GAOGE/V4-Underwater-Robot/hardware/v4/manipulator/装配体1.SLDASM

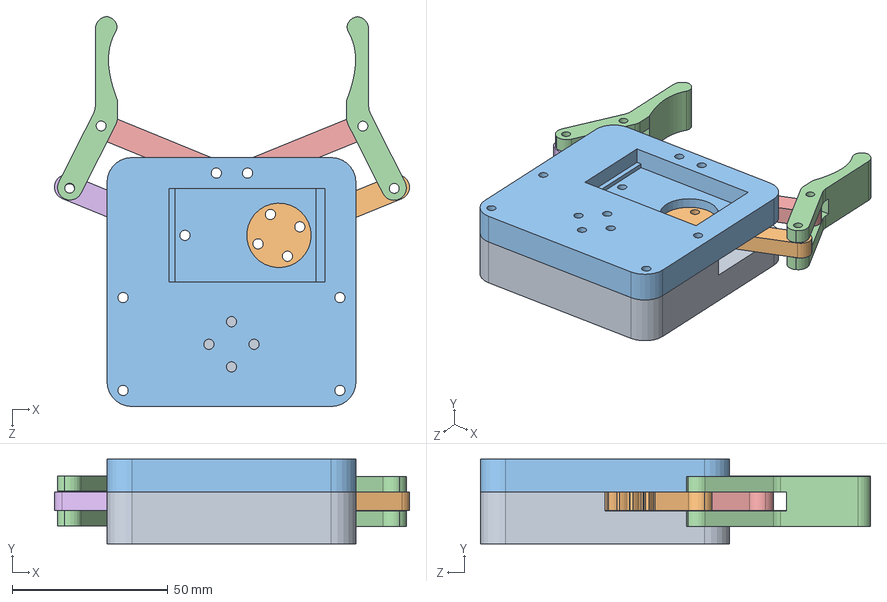
[picture p8: CAD file, 2026-10-22]
hardware/v4/manipulator/装配体1.SLDASM
114.1 x 27.2 x 125.3 mm
圆柱齿轮20×1.5-从动2
拉杆2 x 2
夹手 x 2
新基座
圆柱齿轮20×1.5-主动2
顶盖
