FPJ-GAOGE/V4-Underwater-Robot/hardware/v4-pro/cad/主体/把手护木下.STEP

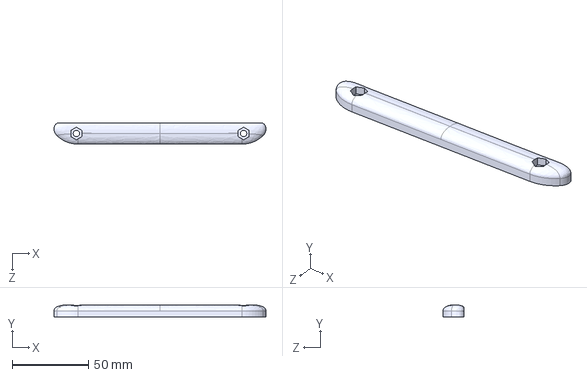
[picture p9: CAD file, 2026-10-22]
hardware/v4-pro/cad/主体/把手护木下.STEP
139.4 x 8.01 x 14.0 mm
