FPJ-GAOGE/V4-Underwater-Robot/hardware/v4-pro/cad/加工外形.STEP

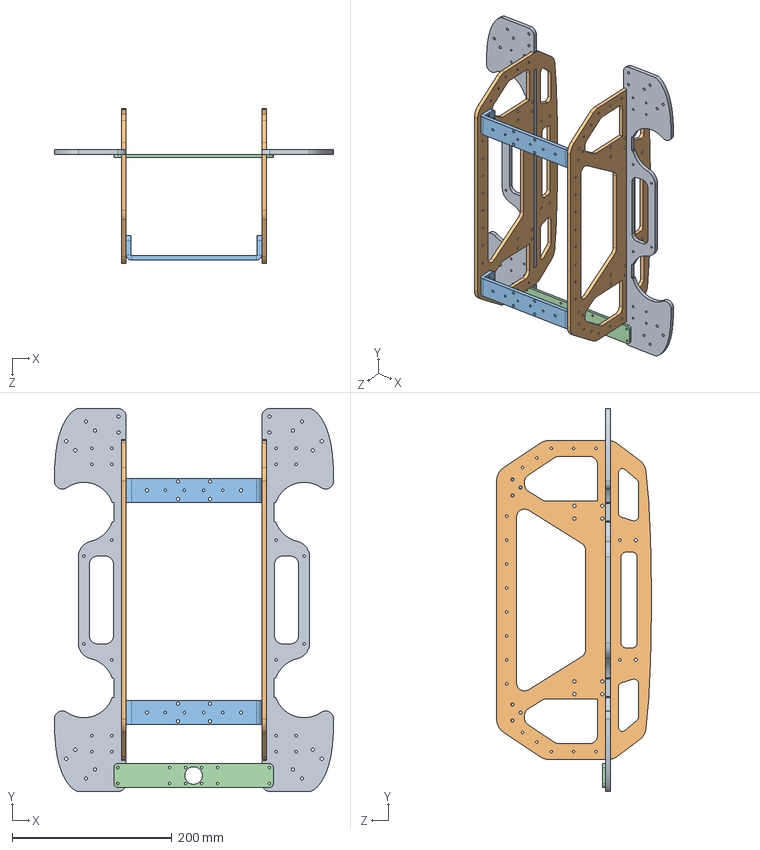
[picture p10: CAD file, 2026-10-22]
hardware/v4-pro/cad/加工外形.STEP
350.0 x 480.0 x 194.0 mm
上推进器支撑 x 2
侧支撑 x 2
底支撑2 x 2
前云台底架
