FPJ-GAOGE/V4-Underwater-Robot/hardware/v4-pro/cad/外设/补光灯固定件V2.STEP

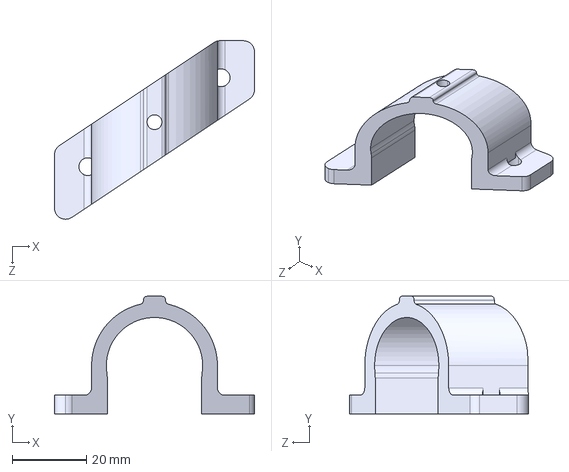
[picture p11: CAD file, 2026-10-22]
hardware/v4-pro/cad/外设/补光灯固定件V2.STEP
54.0 x 31.7 x 48.2 mm
