FPJ-GAOGE/V4-Underwater-Robot/hardware/v4-pro/cad/密封舱/后舱盖165.STEP

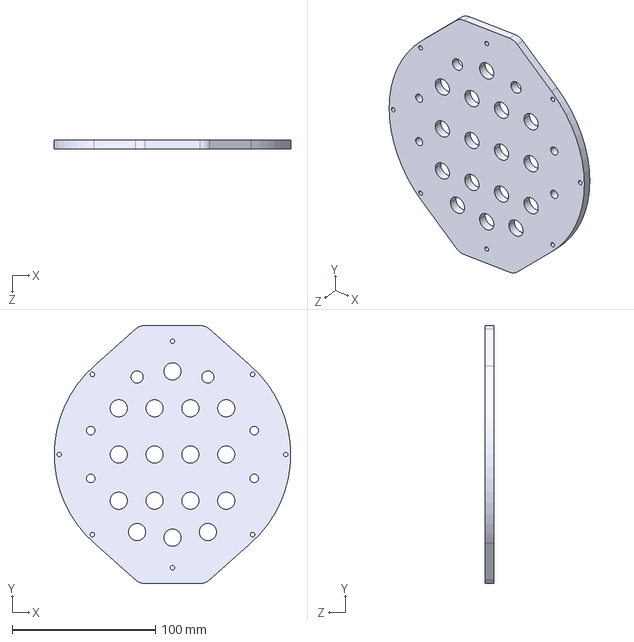
[picture p12: CAD file, 2026-10-22]
hardware/v4-pro/cad/密封舱/后舱盖165.STEP
165.0 x 180.0 x 6.00 mm
