FPJ-GAOGE/V4-Underwater-Robot/hardware/v4-pro/cad/密封舱/舱内/电池架.STEP

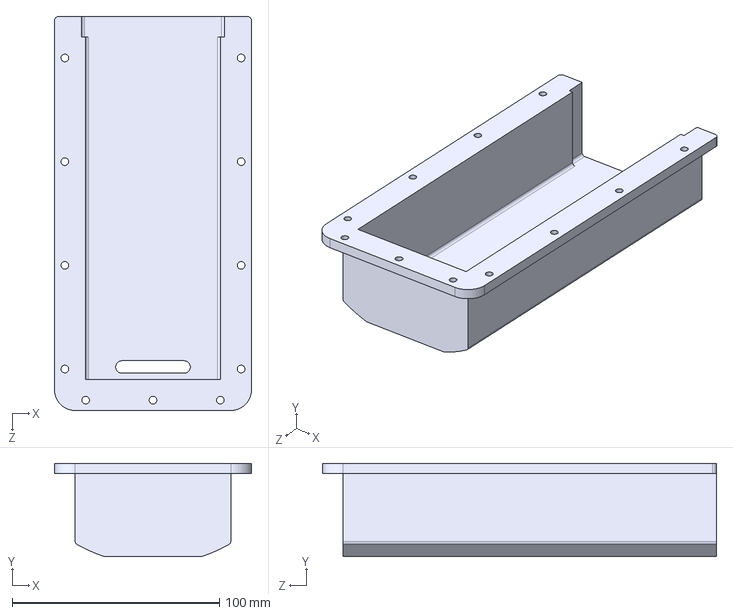
[picture p13: CAD file, 2026-10-22]
hardware/v4-pro/cad/密封舱/舱内/电池架.STEP
95.0 x 45.0 x 190.0 mm
