FPJ-GAOGE/V4-Underwater-Robot/hardware/v4-pro/cad/推进器/推进器垫板.STEP

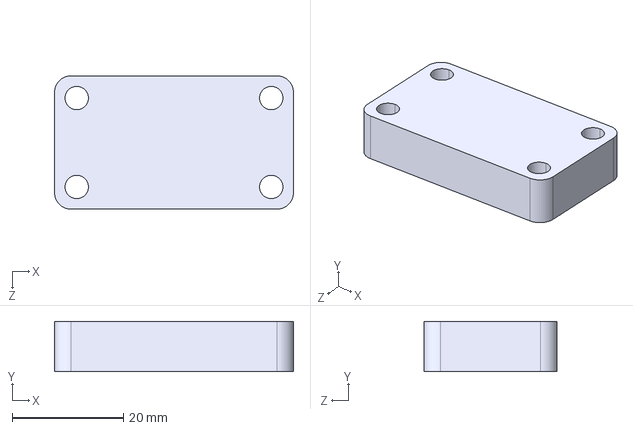
[picture p14: CAD file, 2026-10-22]
hardware/v4-pro/cad/推进器/推进器垫板.STEP
43.0 x 9.00 x 24.0 mm
