FPJ-GAOGE/V4-Underwater-Robot/hardware/v4-pro/cad/水深传感器/外置套管固定加工版.STEP

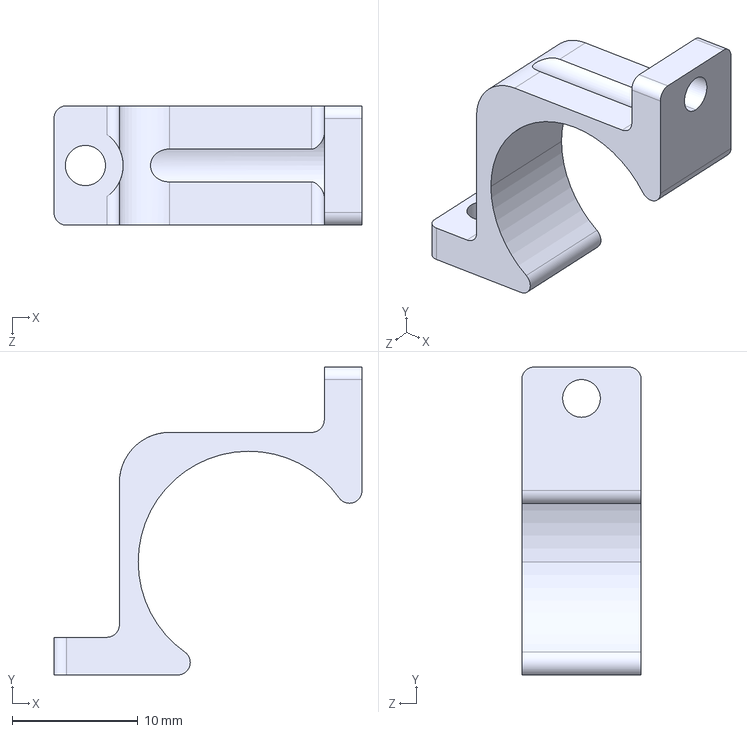
[picture p15: CAD file, 2026-10-22]
hardware/v4-pro/cad/水深传感器/外置套管固定加工版.STEP
24.5 x 24.5 x 9.50 mm
