FPJ-GAOGE/V4-Underwater-Robot/hardware/v4-pro/cad/浮力外壳/浮力外壳（加工）.STEP

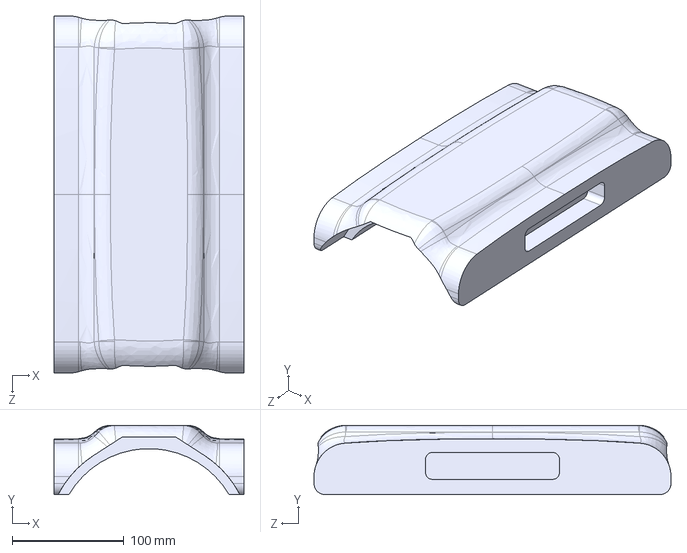
[picture p16: CAD file, 2026-10-22]
hardware/v4-pro/cad/浮力外壳/浮力外壳（加工）.STEP
170.0 x 62.0 x 320.0 mm
