FPJ-GAOGE/V4-Underwater-Robot/hardware/v4-pro/cad/相机云台/相机连接件2.STEP

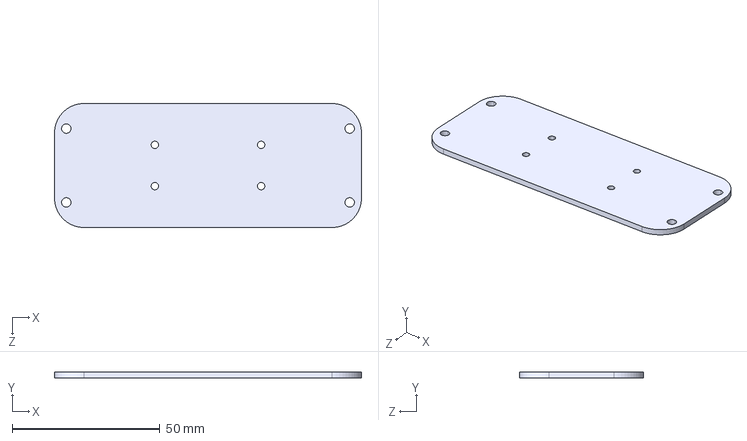
[picture p17: CAD file, 2026-10-22]
hardware/v4-pro/cad/相机云台/相机连接件2.STEP
104.0 x 2.00 x 42.0 mm
