FPJ-GAOGE/V4-Underwater-Robot/hardware/v4/cad/主体/底支撑2.STEP

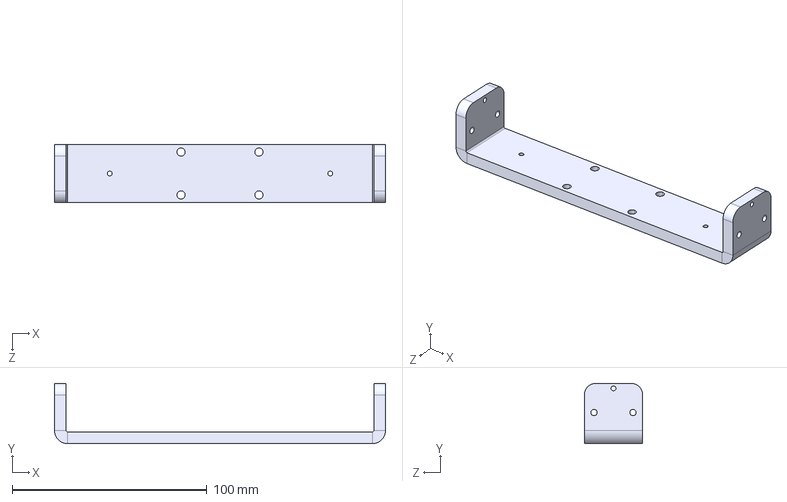
[picture p18: CAD file, 2026-10-22]
hardware/v4/cad/主体/底支撑2.STEP
170.0 x 31.0 x 30.0 mm
