FPJ-GAOGE/V4-Underwater-Robot/hardware/v4/cad/加工外形.STEP

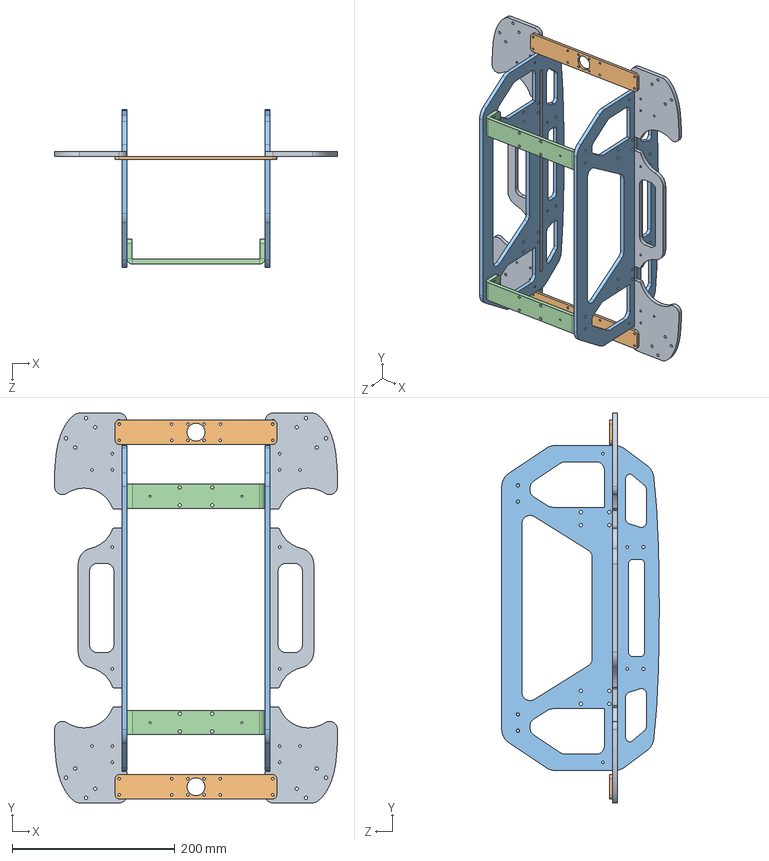
[picture p19: CAD file, 2026-10-22]
hardware/v4/cad/加工外形.STEP
348.5 x 480.0 x 194.0 mm
上推进器支撑 x 2
云台底架 x 2
侧支撑 x 2
底支撑2 x 2
