FPJ-GAOGE/V4-Underwater-Robot/hardware/v4/cad/相机云台/舵机连接件.STEP

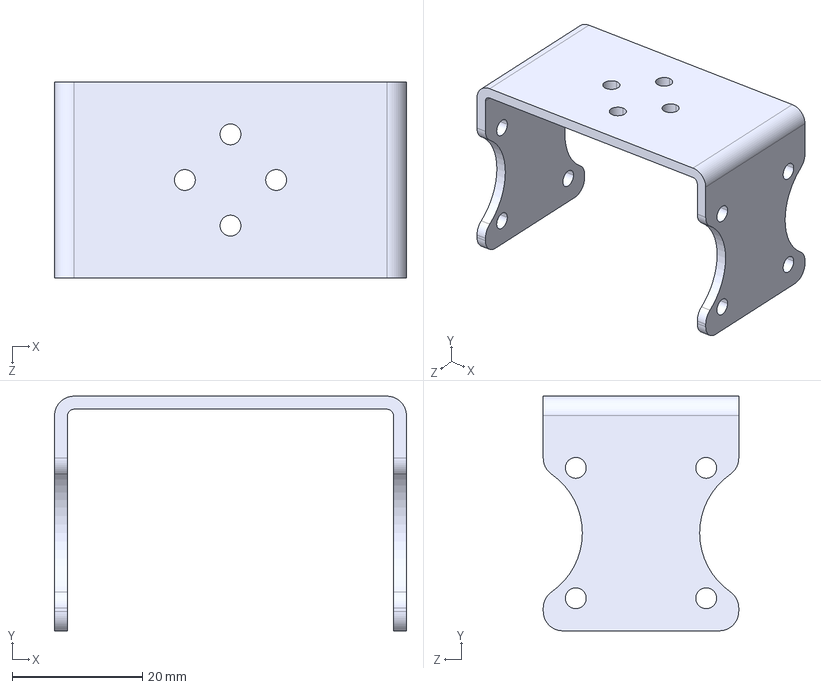
[picture p22: CAD file, 2026-10-22]
hardware/v4/cad/相机云台/舵机连接件.STEP
54.0 x 36.0 x 30.0 mm
