FPJ-GAOGE/V4-Underwater-Robot/hardware/v4/camera-mount/相机支架2.SLDPRT

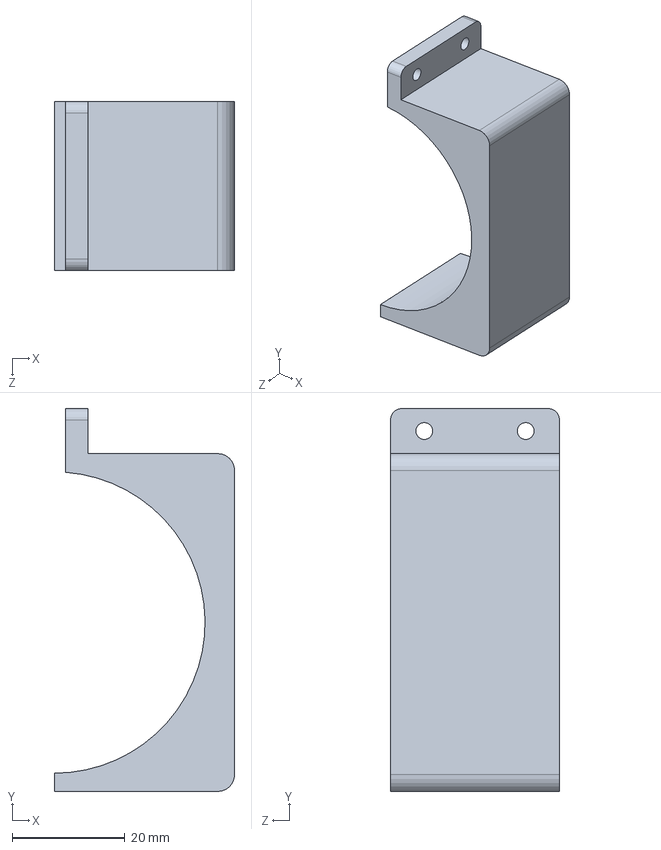
[picture p23: CAD file, 2026-10-22]
hardware/v4/camera-mount/相机支架2.SLDPRT
32.0 x 68.0 x 30.0 mm
