FPJ-GAOGE/V4-Underwater-Robot/hardware/v4/manipulator/拉杆2.SLDPRT

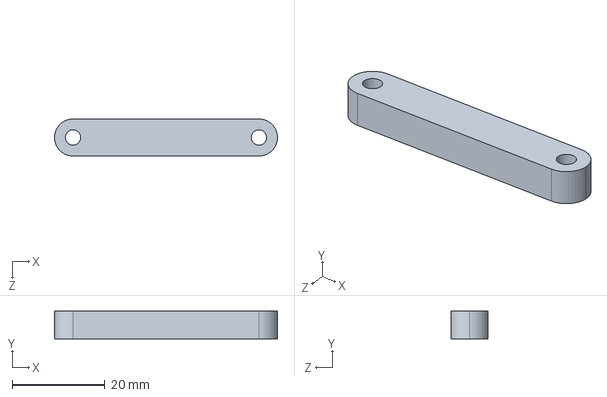
[picture p24: CAD file, 2026-10-22]
hardware/v4/manipulator/拉杆2.SLDPRT
48.0 x 6.00 x 8.00 mm
