FPJ-GAOGE/V4-Underwater-Robot/hardware/v4-pro/cad/V4外形.STEP

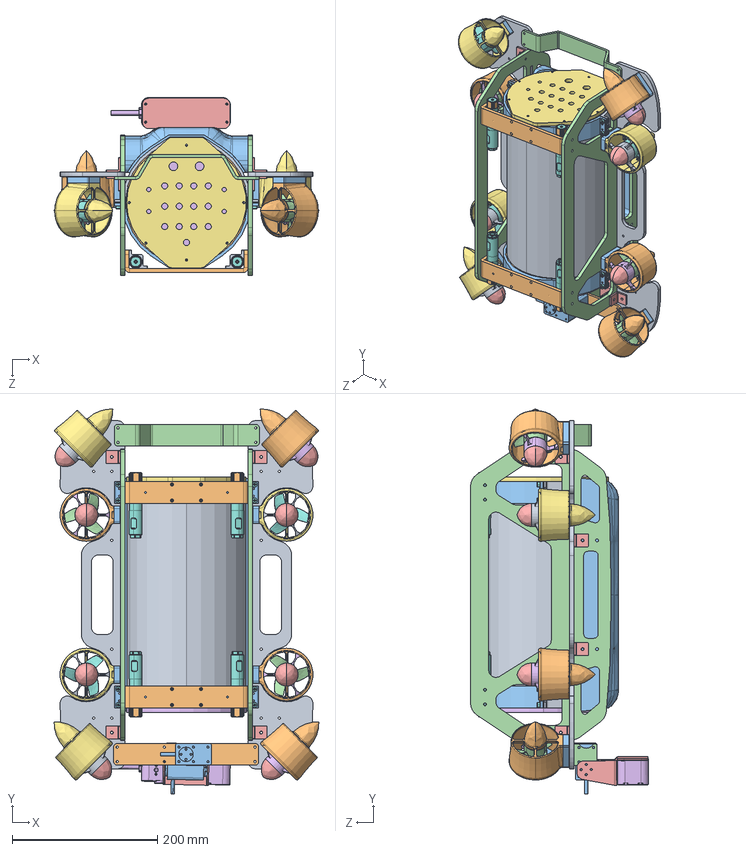
[picture p25: CAD file, 2026-10-22]
hardware/v4-pro/cad/V4外形.STEP
365.0 x 530.7 x 245.4 mm
密封亚克力管165-300
YD11-24-2.stp x 3
PRT0001.stp x 3
9-16-2.stp x 3
YD11-24-1.stp x 3
YD11-24-3.stp x 3
镜向YD11-24-2.stp x 4
镜向PRT0001.stp x 4
镜向9-16-2.stp x 4
镜向YD11-24-1.stp x 4
镜向YD11-24-3.stp x 4
水深传感器 x 4
上推进器支撑 x 2
前云台底架
ZF-S30舵机 x 2
舵机连接件
相机连接件
双目相机
法兰165 x 2
舱管固定环165 x 2
侧支撑 x 2
镜向镜向YD11-24-2.stp
镜向镜向PRT0001.stp
镜向镜向9-16-2.stp
镜向镜向YD11-24-1.stp
镜向镜向YD11-24-3.stp
角件 x 8
前舱盖165
后舱盖165
外置套管 x 4
外置套管固定 x 4
底支撑2 x 2
浮力外壳（加工）
后云台底架
垫片 x 2
