FPJ-GAOGE/V4-Underwater-Robot/hardware/v4-pro/cad/主体/侧支撑.STEP

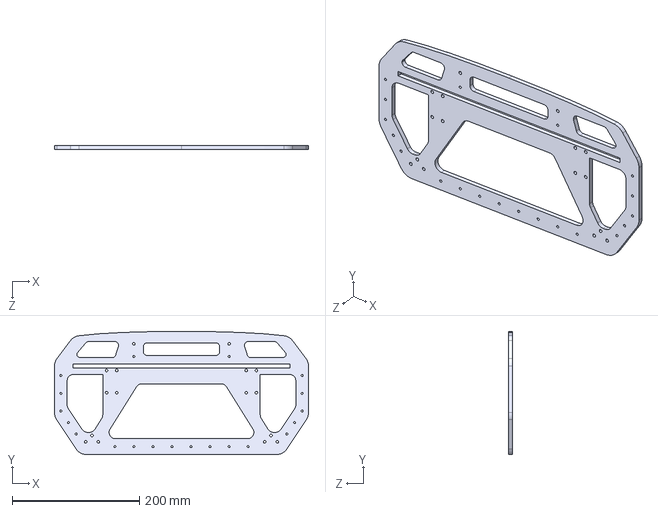
[picture p26: CAD file, 2026-10-22]
hardware/v4-pro/cad/主体/侧支撑.STEP
400.0 x 194.0 x 6.00 mm
