FPJ-GAOGE/V4-Underwater-Robot/hardware/v4-pro/cad/密封舱/舱内/下层架板.STEP

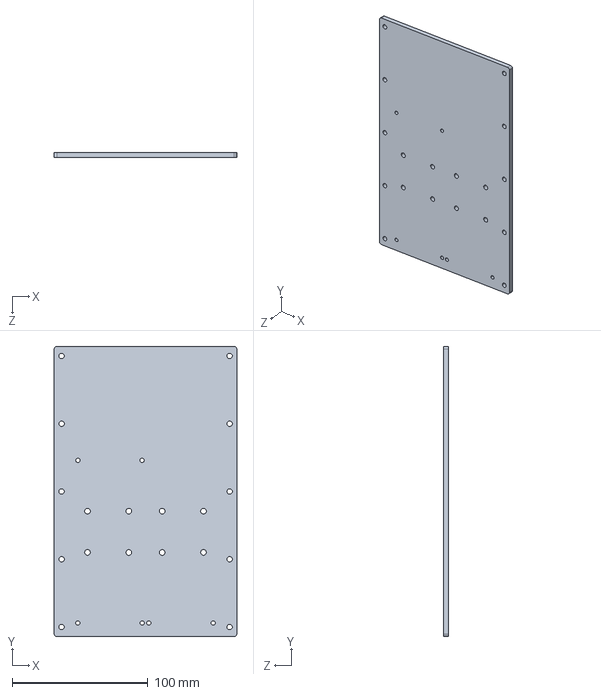
[picture p27: CAD file, 2026-10-22]
hardware/v4-pro/cad/密封舱/舱内/下层架板.STEP
134.8 x 214.0 x 4.00 mm
