FPJ-GAOGE/V4-Underwater-Robot/hardware/v4-pro/cad/相机云台/相机连接件.STEP

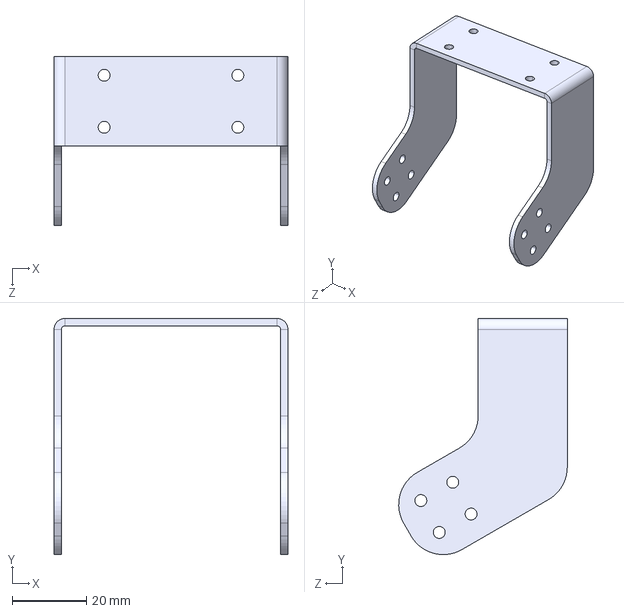
[picture p28: CAD file, 2026-10-22]
hardware/v4-pro/cad/相机云台/相机连接件.STEP
63.0 x 63.6 x 45.4 mm
