FPJ-GAOGE/V4-Underwater-Robot/hardware/v4/camera-mount/相机支架1.SLDPRT

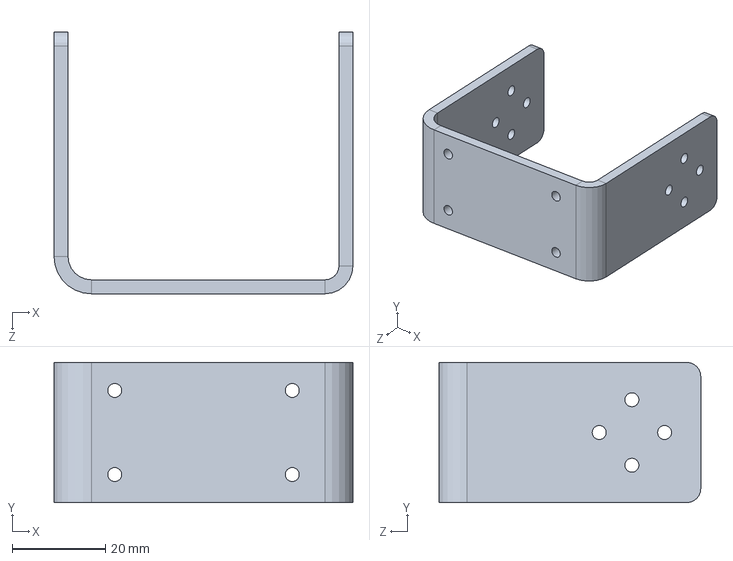
[picture p30: CAD file, 2026-10-22]
hardware/v4/camera-mount/相机支架1.SLDPRT
64.0 x 30.0 x 56.0 mm
