FPJ-GAOGE/V4-Underwater-Robot/hardware/v4/manipulator/圆柱齿轮20×1.5-主动2.SLDPRT

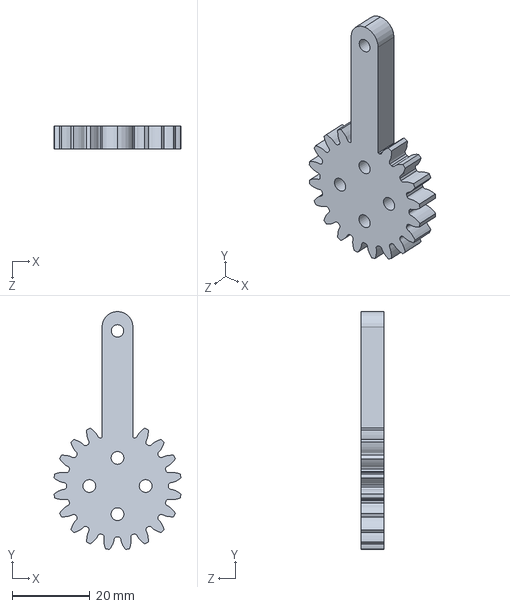
[picture p31: CAD file, 2026-10-22]
hardware/v4/manipulator/圆柱齿轮20×1.5-主动2.SLDPRT
32.7 x 61.4 x 6.00 mm
