FPJ-GAOGE/V4-Underwater-Robot/hardware/v4-pro/cad/主体/角件.STEP

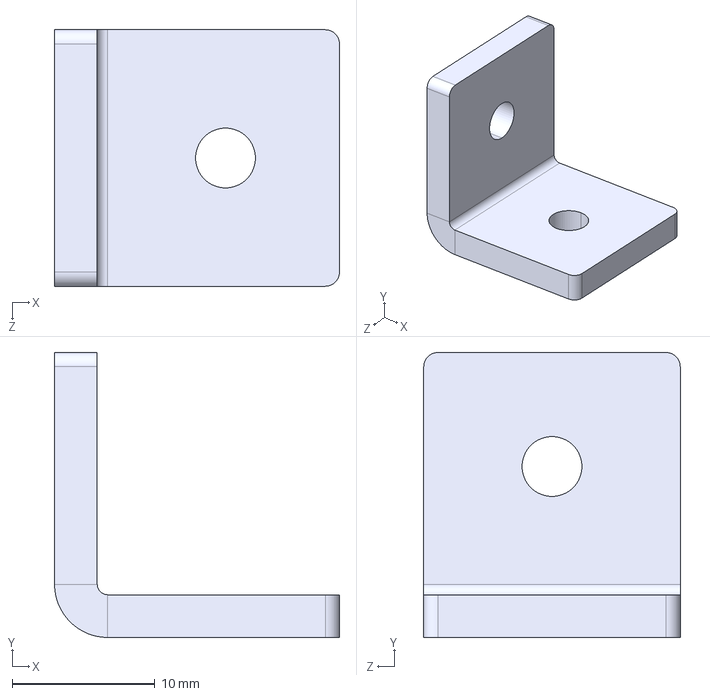
[picture p32: CAD file, 2026-10-22]
hardware/v4-pro/cad/主体/角件.STEP
20.0 x 20.0 x 18.0 mm
