FPJ-GAOGE/V4-Underwater-Robot/hardware/v4-pro/cad/外设/EL25探照灯外观.STEP

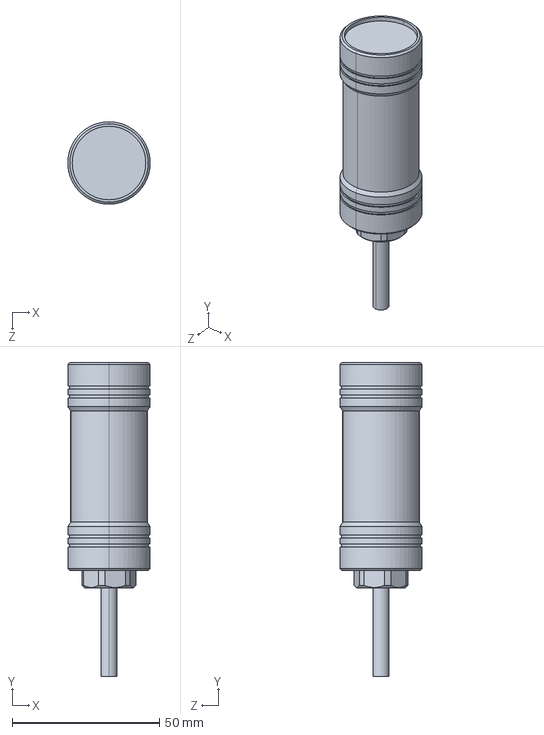
[picture p33: CAD file, 2026-10-22]
hardware/v4-pro/cad/外设/EL25探照灯外观.STEP
28.0 x 106.7 x 28.0 mm
