FPJ-GAOGE/V4-Underwater-Robot/hardware/v4-pro/cad/密封舱/舱内/WHEELTEC_H30裸板.stp

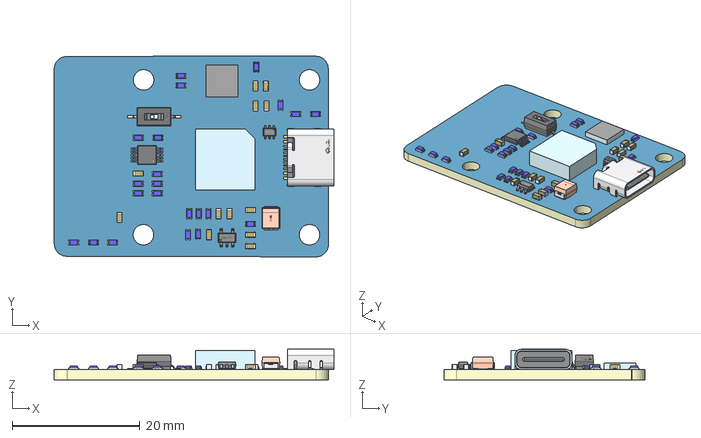
[picture p34: CAD file, 2026-10-22]
hardware/v4-pro/cad/密封舱/舱内/WHEELTEC_H30裸板.stp
43.9 x 31.5 x 4.80 mm
