FPJ-GAOGE/V4-Underwater-Robot/hardware/v4/cad/主体/上推进器支撑.STEP

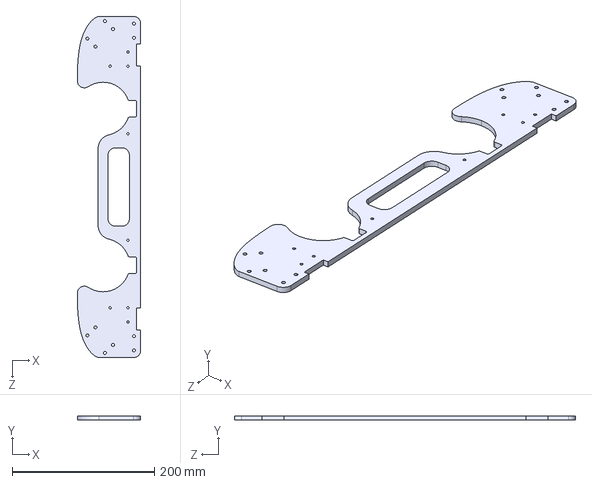
[picture p36: CAD file, 2026-10-22]
hardware/v4/cad/主体/上推进器支撑.STEP
89.3 x 6.00 x 480.0 mm
