FPJ-GAOGE/V4-Underwater-Robot/hardware/v4/cad/相机云台/云台底架.STEP

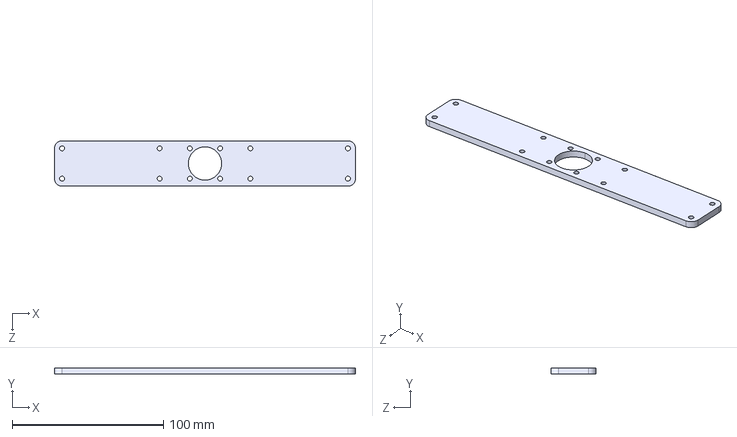
[picture p37: CAD file, 2026-10-22]
hardware/v4/cad/相机云台/云台底架.STEP
199.0 x 4.00 x 30.0 mm
