FPJ-GAOGE/V4-Underwater-Robot/hardware/v4/cad/相机云台/相机连接件.STEP

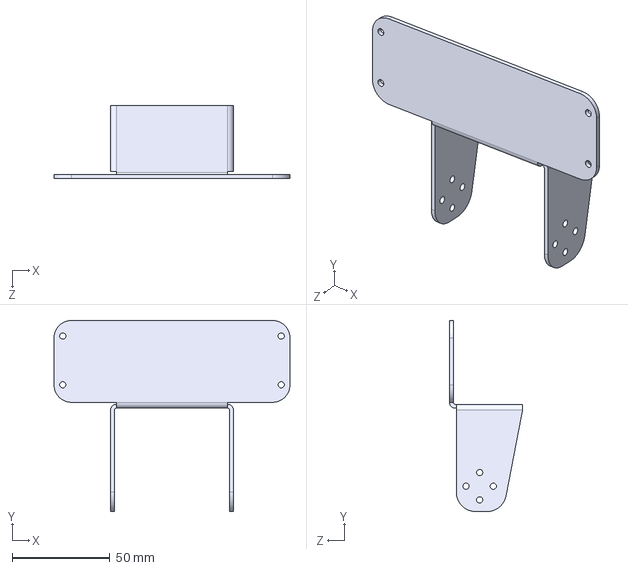
[picture p38: CAD file, 2026-10-22]
hardware/v4/cad/相机云台/相机连接件.STEP
121.0 x 98.0 x 37.5 mm
