FPJ-GAOGE/V4-Underwater-Robot/hardware/v4/manipulator/顶盖.SLDPRT

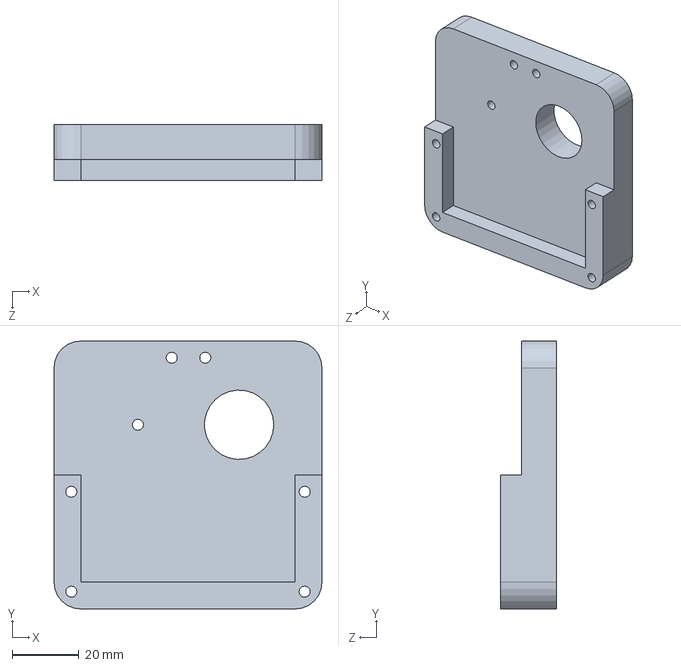
[picture p39: CAD file, 2026-10-22]
hardware/v4/manipulator/顶盖.SLDPRT
80.0 x 80.0 x 16.7 mm
