FPJ-GAOGE/V4-Underwater-Robot/hardware/v4-pro/cad/主体/上推进器支撑.STEP

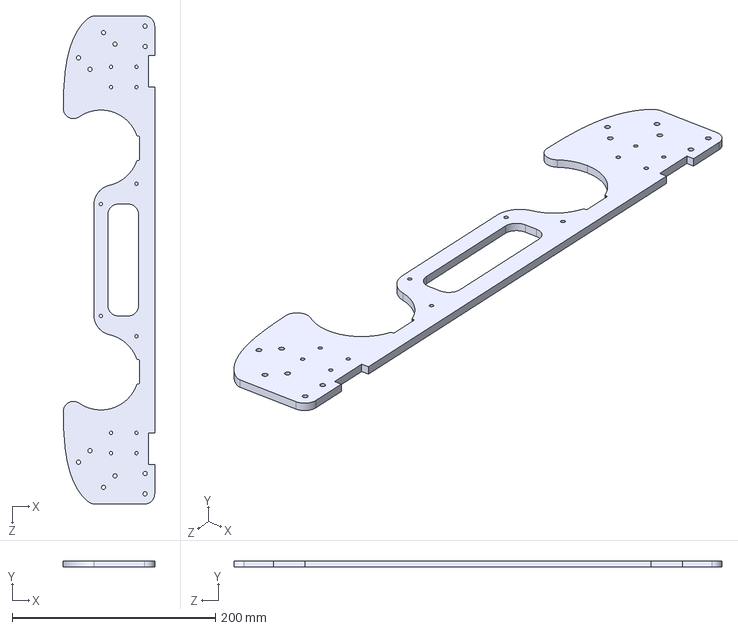
[picture p40: CAD file, 2026-10-22]
hardware/v4-pro/cad/主体/上推进器支撑.STEP
90.0 x 6.00 x 480.0 mm
