FPJ-GAOGE/V4-Underwater-Robot/hardware/v4-pro/cad/密封舱/舱内/ROBOMASTER_A板 v2.step

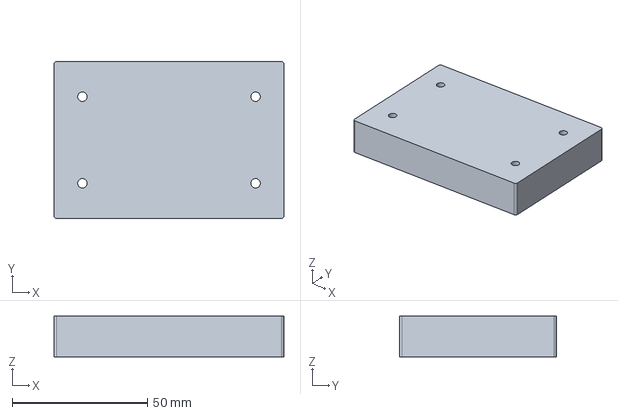
[picture p41: CAD file, 2026-10-22]
hardware/v4-pro/cad/密封舱/舱内/ROBOMASTER_A板 v2.step
85.0 x 58.0 x 15.0 mm
