FPJ-GAOGE/V4-Underwater-Robot/hardware/v4-pro/cad/相机云台/垫片.STEP

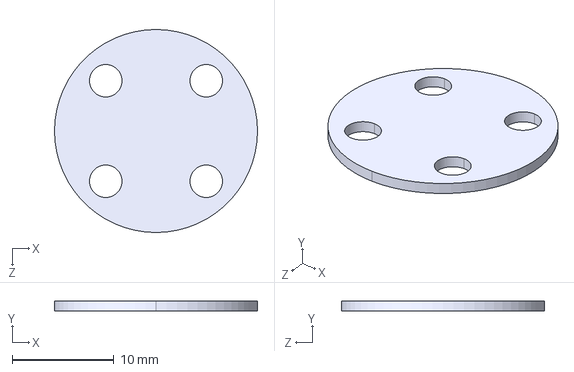
[picture p42: CAD file, 2026-10-22]
hardware/v4-pro/cad/相机云台/垫片.STEP
20.0 x 1.00 x 20.0 mm
