FPJ-GAOGE/V4-Underwater-Robot/hardware/v4/manipulator/圆柱齿轮20×1.5-从动2.SLDPRT

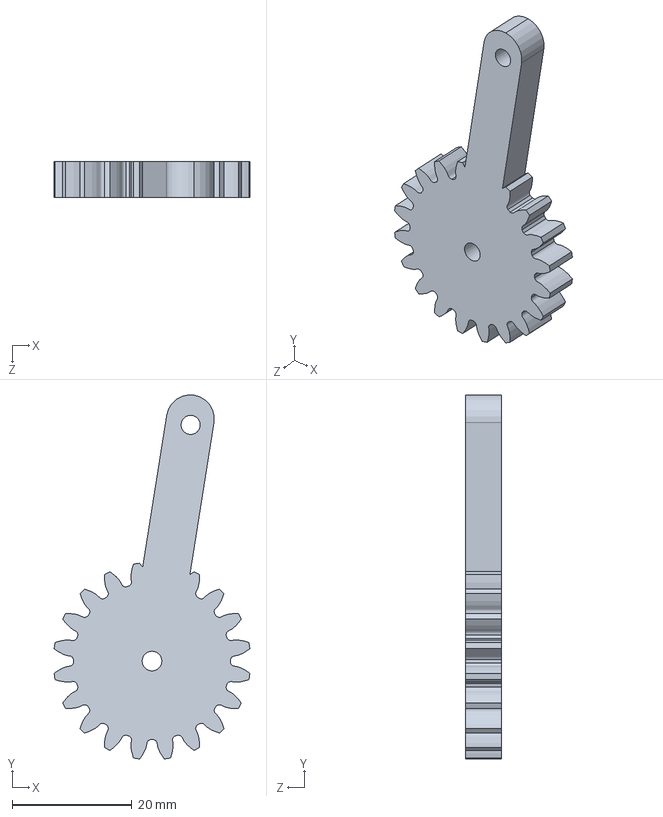
[picture p43: CAD file, 2026-10-22]
hardware/v4/manipulator/圆柱齿轮20×1.5-从动2.SLDPRT
32.7 x 60.8 x 6.00 mm
