FPJ-GAOGE/V4-Underwater-Robot/hardware/v4-pro/cad/相机云台/前云台底架.STEP

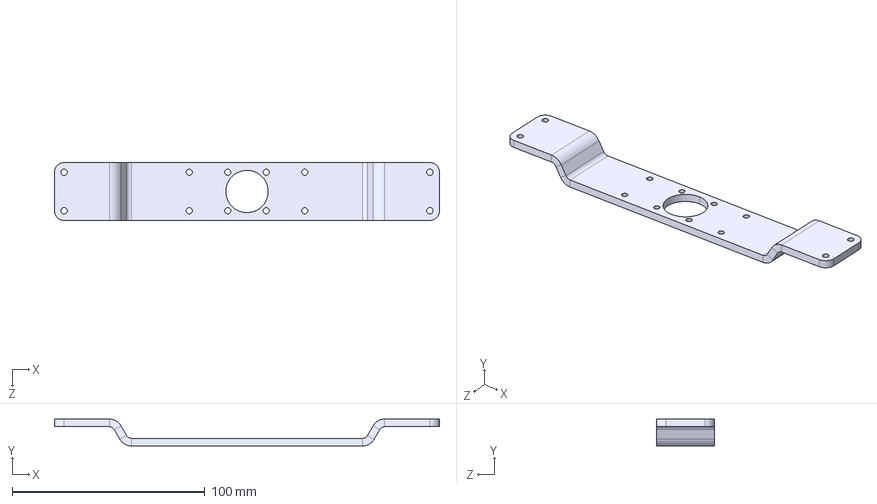
[picture p45: CAD file, 2026-10-22]
hardware/v4-pro/cad/相机云台/前云台底架.STEP
200.0 x 14.0 x 30.0 mm
