FPJ-GAOGE/V4-Underwater-Robot/hardware/v4/manipulator/夹手.SLDPRT

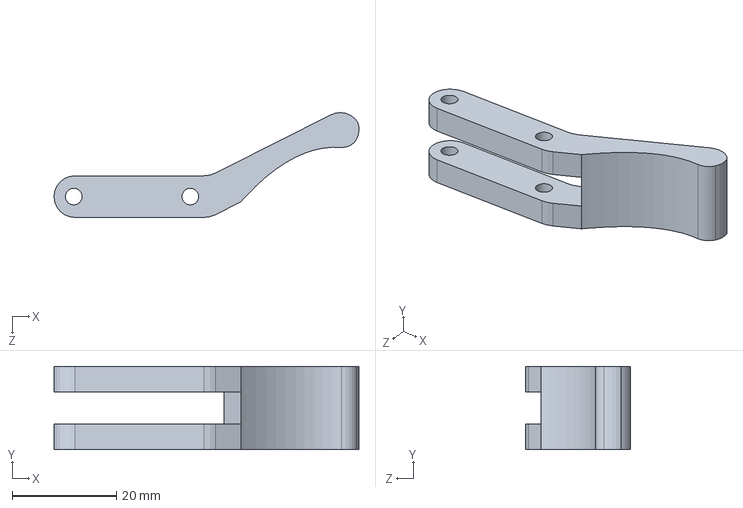
[picture p46: CAD file, 2026-10-22]
hardware/v4/manipulator/夹手.SLDPRT
58.6 x 16.0 x 20.1 mm
