FPJ-GAOGE/V4-Underwater-Robot/hardware/v4/manipulator/圆法兰盘1.SLDPRT

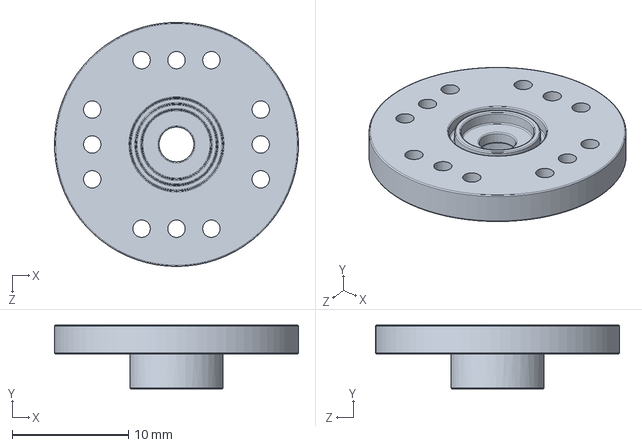
[picture p47: CAD file, 2026-10-22]
hardware/v4/manipulator/圆法兰盘1.SLDPRT
21.0 x 5.50 x 21.0 mm
