FPJ-GAOGE/V4-Underwater-Robot/hardware/v4/manipulator/新基座.SLDPRT

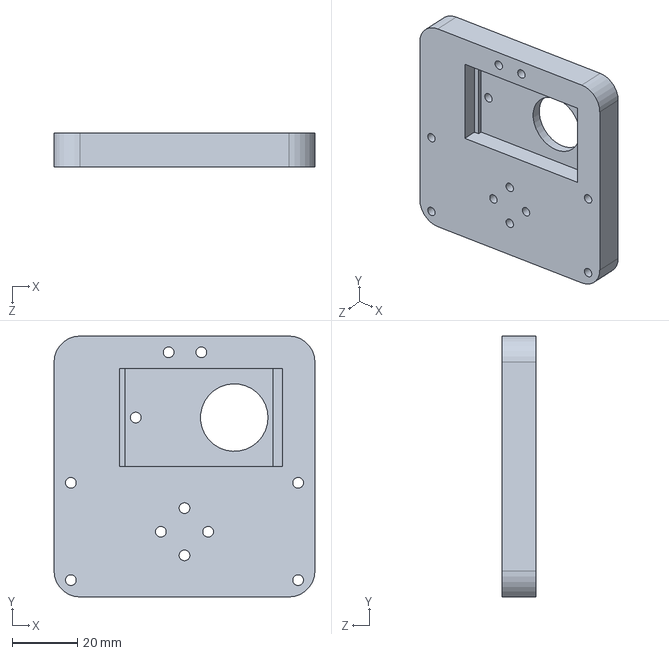
[picture p48: CAD file, 2026-10-22]
hardware/v4/manipulator/新基座.SLDPRT
80.0 x 80.0 x 10.5 mm
