FPJ-GAOGE/V4-Underwater-Robot/(list of files, cad)

Other CAD files:
hardware/v4/cad/浮力外壳/浮力外壳2.STEP
hardware/v4-pro/cad/外设/Mirror补光灯固定件V2.STEP
hardware/v4-pro/cad/浮力外壳/浮力外壳2.STEP
hardware/v4/cad/主体/侧支撑.STEP
hardware/v4/cad/密封舱/舱内/下层架板.STEP
hardware/v4-pro/cad/主体/把手护木上.STEP
hardware/v4-pro/cad/密封舱/舱内/上层架板.STEP
hardware/v4-pro/cad/相机云台/舵机连接件.STEP
hardware/v4-pro/cad/主体/上推进器支撑.DWG
hardware/v4-pro/cad/主体/侧支撑.DWG
hardware/v4-pro/cad/主体/底支撑2.DWG
hardware/v4-pro/cad/密封舱/后舱盖165.DWG
hardware/v4-pro/cad/相机云台/前云台底架.DWG
hardware/v4-pro/cad/相机云台/后云台底架.DWG
hardware/v4-pro/cad/相机云台/相机连接件2.DWG
hardware/v4/cad/主体/上推进器支撑.DWG
hardware/v4/cad/主体/侧支撑.DWG
hardware/v4/cad/主体/底支撑2.DWG
hardware/v4/cad/密封舱/后舱盖165.DWG
hardware/v4/cad/相机云台/云台底架.DWG
hardware/v4/cad/相机云台/后云台底架.DWG
