FPJ-GAOGE/V4-Underwater-Robot/firmware/v4-pro/BSP/Robomaster_A/Robomaster_A.ioc

Mcu.UserName=STM32F427IIHx
PA0/WKUP.Signal=S_TIM2_CH1_ETR
PA1.Signal=S_TIM2_CH2
PA10.Signal=USB_OTG_FS_ID
PA11.Signal=USB_OTG_FS_DM
PA12.Signal=USB_OTG_FS_DP
PA13.Signal=SYS_JTMS-SWDIO
PA14.Signal=SYS_JTCK-SWCLK
PA2.Signal=S_TIM2_CH3
PA3.Signal=S_TIM2_CH4
PB12.Signal=CAN2_RX
PB13.Signal=CAN2_TX
PB2/BOOT1.GPIO_Label=BUTTON
PB2/BOOT1.Signal=GPIO_Input
PB6.Signal=USART1_TX
PB7.Signal=USART1_RX
PC2.Signal=ADCx_IN12
PD0.Signal=CAN1_RX
PD1.Signal=CAN1_TX
PD12.Signal=S_TIM4_CH1
PD13.Signal=S_TIM4_CH2
PD14.Signal=S_TIM4_CH3
PD15.Signal=S_TIM4_CH4
PD5.Signal=USART2_TX
PD6.Signal=USART2_RX
PD8.Signal=USART3_TX
PD9.Signal=USART3_RX
PE0.Signal=UART8_RX
PE1.Signal=UART8_TX
PE11.GPIO_Label=LED_RED
PE11.Signal=GPIO_Output
PE12.Signal=SPI4_SCK
PE4.GPIO_Label=SPI4_NSS1
PE4.Signal=GPIO_Output
PE5.Signal=SPI4_MISO
PE6.Signal=SPI4_MOSI
PE7.Signal=UART7_RX
PE8.Signal=UART7_TX
PF0.Signal=I2C2_SDA
PF1.Signal=I2C2_SCL
PF14.GPIO_Label=LED_GREEN
PF14.Signal=GPIO_Output
PF6.GPIO_Label=SPI5_NSS1
PF6.Signal=GPIO_Output
PF7.Signal=SPI5_SCK
PF8.Signal=SPI5_MISO
PF9.Signal=SPI5_MOSI
PG1.GPIO_Label=LED_G1
PG1.Signal=GPIO_Output
PG14.Signal=USART6_TX
PG2.GPIO_Label=LED_G2
PG2.Signal=GPIO_Output
PG3.GPIO_Label=LED_G3
PG3.Signal=GPIO_Output
PG4.GPIO_Label=LED_G4
PG4.Signal=GPIO_Output
PG5.GPIO_Label=LED_G5
PG5.Signal=GPIO_Output
PG6.GPIO_Label=LED_G6
PG6.Signal=GPIO_Output
PG7.GPIO_Label=LED_G7
PG7.Signal=GPIO_Output
PG8.GPIO_Label=LED_G8
PG8.Signal=GPIO_Output
PG9.Signal=USART6_RX
PH0/OSC_IN.Signal=RCC_OSC_IN
PH1/OSC_OUT.Signal=RCC_OSC_OUT
PH10.Signal=S_TIM5_CH1
PH11.Signal=S_TIM5_CH2
PH12.Signal=S_TIM5_CH3
PH6.Signal=S_TIM12_CH1
PI0.Signal=S_TIM5_CH4
