FPJ-GAOGE/V4-Underwater-Robot/firmware/v4/userCode/devices/Inc/Sensor.h

//
// Created by admin on 2023/11/27.
//
#ifndef CONTROL_FRAME_MAIN_SENSOR_H
#define CONTROL_FRAME_MAIN_SENSOR_H

#include "Usermain.h"
#include "Matrix.h"
#include "Extension.h"
#include "MahonyAHRS.h"
#include "FilterBase.h"

#define B02_IIC_ADDRESS 0xEC

#define MS5837_30BA_ResetCommand     0x1E                //��λ
#define	MS5837_30BA_PROM_RD 	     0xA0                //PROM��ȡ,{0XA0,0XA2,0XA4,0XA8,0XAA,0XAC,0XAE}
#define MS5837_30BA_ADC_RD           0x00                //ADC��ȡ

#define MS5837_30BA_D1_OSR256					 0x40
#define MS5837_30BA_D1_OSR512					 0x42
#define MS5837_30BA_D1_OSR1024					 0x44
#define MS5837_30BA_D1_OSR2048					 0x46
#define MS5837_30BA_D1_OSR4096					 0x48
#define MS5837_30BA_D2_OSR256					 0x50
#define MS5837_30BA_D2_OSR512					 0x52
#define MS5837_30BA_D2_OSR1024					 0x54
#define MS5837_30BA_D2_OSR2048					 0x56
#define MS5837_30BA_D2_OSR4096					 0x58

#define PRESSURE_0_V30 1005.646
#define PRESSURE_1_V30 1004.711
#define PRESSURE_2_V30 1004.350
#define PRESSURE_3_V30 1005.058

#define PRESSURE_0_V31 1014.227
#define PRESSURE_1_V31 1003.288
#define PRESSURE_2_V31 1003.028
#define PRESSURE_3_V31 1003.799

#define PRESSURE_0_V32 1009.775
#define PRESSURE_1_V32 1010.957
#define PRESSURE_2_V32 1010.074
#define PRESSURE_3_V32 1009.850

#define PRESSURE_0_V33 1004.227
#define PRESSURE_1_V33 1003.288
#define PRESSURE_2_V33 1003.028
#define PRESSURE_3_V33 1003.799

#define PRESSURE_0_V40 1018.4
#define PRESSURE_1_V40 1020.0
#define PRESSURE_2_V40 1018.5
#define PRESSURE_3_V40 1019.1

typedef struct Sensor_Site{
    float x[SENSOR_NUM];
    float y[SENSOR_NUM];
    float z[SENSOR_NUM];
} Sensor_Site_t;

enum class PS_HandleState {
    READ_TEMP_THEN_REQU_PRES,
    READ_PRES_THEN_REQU_TEMP 
};

enum class PS_I2C_TaskState{
    TCA_SET_0, // 设置TCA通道
    TRANSMIT_READ_0, // 发送读取指令
    RECEIVE_0, // 读取数据
    TRANSMIT_CONV_0, // 发送转换下一个数据指令
    TCA_SET_1,
    TRANSMIT_READ_1,
    RECEIVE_1,
    TRANSMIT_CONV_1,
    TCA_SET_2,
    TRANSMIT_READ_2,
    RECEIVE_2,
    TRANSMIT_CONV_2,
    TCA_SET_3,
    TRANSMIT_READ_3,
    RECEIVE_3,
    TRANSMIT_CONV_3,
    Length
};

class PressureSensor: public Device{

    unsigned char MS5837_30BA_Crc4(int id);
    unsigned long MS5837_30BA_GetConversion(uint8_t command);
    uint8_t MS5837_30BA_PROM(int id);
    void MS5837_30BA_ReSet(void);
    float MS5837_30BA_GetData(int id);
    //signed int MS5837_30BA_GetTemp(int id);

    void Init_single(int id);
    void Handle_single(int id);
    void Handle_all();
    void Handle_all_IT();
    void Calibrate_single(int id);
    void Calibrate();
    void CalcRealPressure(uint8_t id);
    void Solve_plane_3(float* data,float* h,float* x,float* y,float* z);
    void Solve_plane(float* data,float* h,float* x,float* y,float* z,int num);
    void Update_plane();//计算水面方程

    signed int dT,TEMP;
    uint32_t Cal_C[6][7];
    int32_t OFFi,SENSi,Ti;
    int64_t OFF2;
    int64_t SENS2;
    uint32_t TEMP2;
    int64_t OFF_,SENS;
    uint32_t D1_Pres,D2_Temp;
    unsigned char flag_ok[6];
    
    int32_t CurrentID;

    Sensor_Site_t site;

public:

    void Init();
    void Handle();
    void Receive();
    void PS_I2C_IT_Handle();

    float Temperature;
    signed int data_temp[6];
    float data_pressure_offset[6]; // 压强零偏值，在水上测量
    float data_pressure_raw[6]; // 水下压强原始值
    float data_pressure[6]; // 水下压强去掉零偏，即为深度值
    float data_plane[5]; // 水面方程Ax+By+Cz+D=0,A*A+B*B+C*C=0,5个数据分别为A、B、C、D、拉格朗日乘数
    float data_depth; // 深度数据，单位cm
    float data_roll,data_pitch;
    float data_level[3];
    float pitch,roll; // 俯仰角、横滚角
    bool flag_calibrate; // 校准水压计零偏的标志
    bool flag_read_pres; // 读取水压计读数的标志
    uint32_t conv_D1[SENSOR_NUM] = {0}; // pres
    uint32_t conv_D2[SENSOR_NUM] = {0}; // temp
    uint8_t i2c_it_data;
    uint8_t i2c_it_rx[3];

    MeanFilter<float, 5> meanfilter[SENSOR_NUM];
    // static PressureSensor pressure_sensor;
    PS_HandleState ps_state;
    PS_I2C_TaskState ps_i2c_state;

};

extern PressureSensor pressure_sensor;

class Sonar: public Device{
    int32_t data;
    int32_t data_offset;

public:

    void Init();
    void Handle();
    void Receive();
    static Sonar sonar;
};

extern Sonar sonar;

#endif //CONTROL_FRAME_MAIN_SENSOR_H
