FPJ-GAOGE/V4-Underwater-Robot/firmware/v4/userCode/devices/Inc/IMU.h

//
// Created by LEGION on 2021/10/17.
//

#ifndef RM_FRAME_C_IMU_H
#define RM_FRAME_C_IMU_H

#include "BMI088driver.h"
#include "ist8310driver.h"
#include "H30_IMU.h"
#include "Usermain.h"
#include "KalmanFilter.h"
#include "MahonyAHRS.h"
#include "bsp_spi.h"
#include "PID.h"
#include "ExtendedKalmanFilter.h"
#include <stdint.h>

// 输出数据个数
#define OUTPUT_NUM                3

#define IMU_USE_MAG 1 // 是否融合磁力计数据

#define SPI_DMA_GYRO_LENGHT       8
#define SPI_DMA_ACCEL_LENGHT      9
#define SPI_DMA_ACCEL_TEMP_LENGHT 4

#define IMU_DR_SHFITS        0u
#define IMU_SPI_SHFITS       1u
#define IMU_UPDATE_SHFITS    2u
#define IMU_NOTIFY_SHFITS    3u

#define BMI088_GYRO_RX_BUF_DATA_OFFSET  1u
#define BMI088_ACCEL_RX_BUF_DATA_OFFSET 2u

//ist83100原始数据在缓冲区buf的位置
#define IST8310_RX_BUF_DATA_OFFSET 16

//平均滤波采样值
#define SUM_WIN_SIZE 8
#define IMU_TARGET_TEMP 45.0f
#define MPU6500_TEMP_PWM_MAX 2000 //mpu6500控制温度的设置TIM的重载值，即给PWM最大为 MPU6500_TEMP_PWM_MAX - 1

extern float BMI088_ACCEL_SEN;
extern float BMI088_GYRO_SEN;

//轴偏
/*constexpr float C1 = 1.010006001930344f;
constexpr float C2 = -0.007492008326987f;
constexpr float C3 = -0.009254187692463f;
constexpr float C4 = 0.016494226767657f;
constexpr float C5 = 1.004509527569225f;
constexpr float C6 = 0.022698224839392f;
constexpr float C7 = -0.006601428647036f;
constexpr float C8 = -0.000182664761106f;
constexpr float C9 = 1.016633267989222f;
constexpr float Cx = 0.099323298159297f;
constexpr float Cy = 0.017485774998530f;
constexpr float Cz = -0.166100036392575f;*/

//椭球误差
#define MAG_SCALE_X 0.889875
#define MAG_SCALE_Y 0.880329
#define MAG_SCALE_Z 1.229795
#define MAG_OFFSET_X 8.418958
#define MAG_OFFSET_Y -21.033503
#define MAG_OFFSET_Z -4.048424

//EKF参数初始化(P,Q,R)
extern float P_initial[X_SIZE][X_SIZE];
extern float Q_initial[X_SIZE][X_SIZE];
extern float R_initial[Z_SIZE][Z_SIZE];

/*枚举类型定义------------------------------------------------------------*/
/*结构体定义--------------------------------------------------------------*/


typedef struct IMU_Raw_Data{
    float accel[3], gyro[3], temp, mag[3], accel_offset[3], gyro_offset[3], time;
} IMU_Raw_Data_t;

typedef struct IMU_Pro_Data{
    float accel[3], gyro[3], temp, mag[3], ins_quat[4], ins_angle[3];
} IMU_Pro_Data_t;

typedef struct IMU_Attitude{
    float ang[3]; // roll, pitch, yaw
    float ang_vel[3]; // roll, pitch, yaw
} IMU_Attitude_t;

typedef enum IMU_DMA_State{
    IMU_DMA_IDLE = 0,
    IMU_DMA_READ_GYRO,
    IMU_DMA_READ_ACCEL,
    IMU_DMA_READ_TEMP
}IMU_DMA_State_e;

typedef struct IMU_DMA_Buffer{
	
    uint8_t gyro_dma_rx_buf[SPI_DMA_GYRO_LENGHT];
    uint8_t gyro_dma_tx_buf[SPI_DMA_GYRO_LENGHT] = {0x82,0xFF,0xFF,0xFF,0xFF,0xFF,0xFF,0xFF};

    uint8_t accel_dma_rx_buf[SPI_DMA_ACCEL_LENGHT];
    uint8_t accel_dma_tx_buf[SPI_DMA_ACCEL_LENGHT] = {0x92,0xFF,0xFF,0xFF,0xFF,0xFF,0xFF,0xFF,0xFF};

    uint8_t accel_temp_dma_rx_buf[SPI_DMA_ACCEL_TEMP_LENGHT];
    uint8_t accel_temp_dma_tx_buf[SPI_DMA_ACCEL_TEMP_LENGHT] = {0xA2,0xFF,0xFF,0xFF};
}IMU_DMA_Buffer_t;

/*类型定义----------------------------------------------------------------*/

class IMU : public Device
{
    void ErrorHandle();

    //读取数据
    void imu_cmd_spi_dma(void);
    void trigger_gyro_dma(void);
    void trigger_accel_dma(void);
    void trigger_temp_dma(void);

    //数据处理
    void offset_correction();
    void calibrate_offset();    //获取加速度零偏值

    //姿态解算
    void AHRS_update(float quat[4], float time, float accel[3], float mag[3]);
    void AHRS_out(float quat[4], float time, float gyro[3], float accel[3], float mag[3]);
    void get_angle(float q[4], float *yaw, float *pitch, float *roll);
    bool flag_Test;
    //温度控制
    PID tempPid;
    uint8_t first_temperate = 0;
    uint32_t count_imu;
    void imu_temp_control(float temp);
    void IMU_temp_PWM(uint16_t pwm);
    //位移获取
    void attitude_update();
    void h30_attitude_update();

public:

    void Init();
    void Handle();
    void Receive();
    void DMA_IT_Handle(void);

    bool flag_update_pressure = false;
    
    ExtendedKalmanFilter ekf = ExtendedKalmanFilter(Q_initial, R_initial, P_initial);
    IMU_DMA_Buffer_t buf;
    IMU_Raw_Data_t raw_data;
    IMU_Pro_Data_t pro_data;
    IMU_Attitude_t attitude;
    IMU_DMA_State_e dma_state;
    H30_IMU h30_imu;
};

extern IMU imu;

//extern float variance;

/*结构体成员取值定义组------------------------------------------------------*/
/*外部变量声明-------------------------------------------------------------*/
/*外部函数声明-------------------------------------------------------------*/
#ifdef __cplusplus
extern "C" {
#endif
extern void DMA2_Stream0_IRQHandler(void);
#ifdef __cplusplus
}
#endif

#endif //RM_FRAME_C_IMU_H
