FPJ-GAOGE/V4-Underwater-Robot/firmware/v4/userCode/devices/Inc/Extension.h

//
// Created by admin on 2023/10/29.
//

#ifndef CONTROL_FRAME_MAIN_EXTENSION_H
#define CONTROL_FRAME_MAIN_EXTENSION_H

#include "Usermain.h"

#define TCA9548A_ADDR         0x70

#define TCA9548A_CHANNEL_0          0x01
#define TCA9548A_CHANNEL_1          0x02
#define TCA9548A_CHANNEL_2          0x04
#define TCA9548A_CHANNEL_3          0x08
#define TCA9548A_CHANNEL_4          0x10
#define TCA9548A_CHANNEL_5          0x20
#define TCA9548A_CHANNEL_6          0x40
#define TCA9548A_CHANNEL_7          0x80

#define PCA9685_ADDR 0x80

#define PCA9685_MODE1 0x0
#define PCA9685_PRESCALE 0xFE

#define LED0_ON_L 0x6
#define LED0_ON_H 0x7
#define LED0_OFF_L 0x8
#define LED0_OFF_H 0x9

/*

extern uint8_t RxBuffer_servo[];


extern void I2C_Extension_init();
extern void I2C_Extension();*/

enum class I2C_TaskState{
    PressureSensor,
    PROPELLER,
    SERVO
};

void TCA_SetChannel(uint8_t channel);
void PCA_Setpwm(uint8_t num, uint32_t on, uint32_t off);
void PCA_Write(uint8_t adrr,uint8_t data);
void PCA_Setfreq(float freq);
uint8_t PCA_Read(uint8_t adrr);

extern void HAL_I2C_MasterTxCpltCallback(I2C_HandleTypeDef *hi2c);
extern void HAL_I2C_MasterRxCpltCallback(I2C_HandleTypeDef *hi2c);

extern I2C_TaskState i2c_state;




#endif //CONTROL_FRAME_MAIN_EXTENSION_H
