FPJ-GAOGE/V4-Underwater-Robot/(commit log)

2026-10-22 Organize V4 and V4-pro sources, mechanical designs, and Chinese documentation
    [EL25探照灯外观.STEP, Mirror补光灯固定件V2.STEP, ROBOMASTER_A板 v2.step, V4外形.STEP, WHEELTEC_H30裸板.stp, stm32f4+dap-link.cfg, stm32f4+st-link.cfg, 上层架板.STEP]
2026-10-22 Add bilingual documentation and downloadable V4 and V4-pro BOM
    [V4-BOM.csv, V4-V4pro-BOM.xlsx, V4-pro-BOM.csv]
